pioter1234567/airhockey/firmware/lcd-unit/data/test.jpg

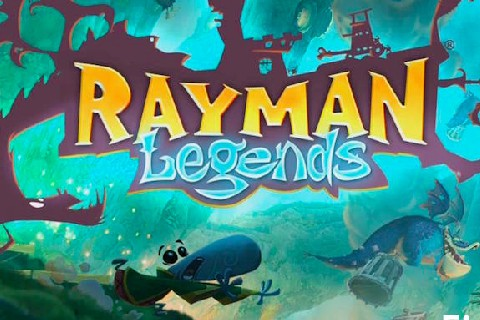
firmware/lcd-unit/data/test.jpg
