pioter1234567/airhockey/assets/Photos-3-001/IMG_20250711_163729.jpg

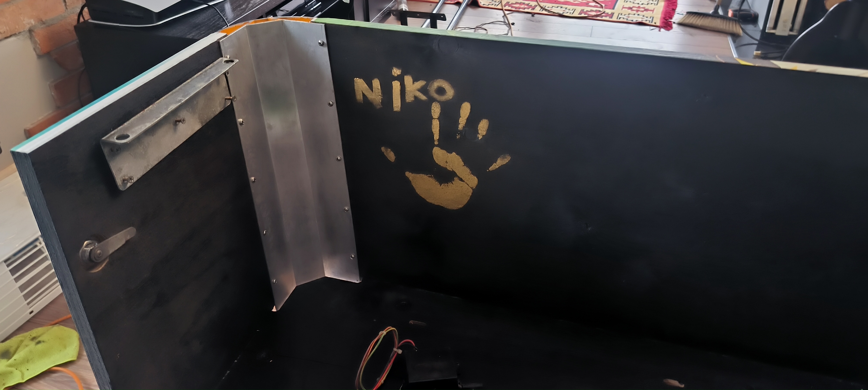
assets/Photos-3-001/IMG_20250711_163729.jpg
