pioter1234567/airhockey/assets/Photos-3-001/IMG20251211001312.jpg

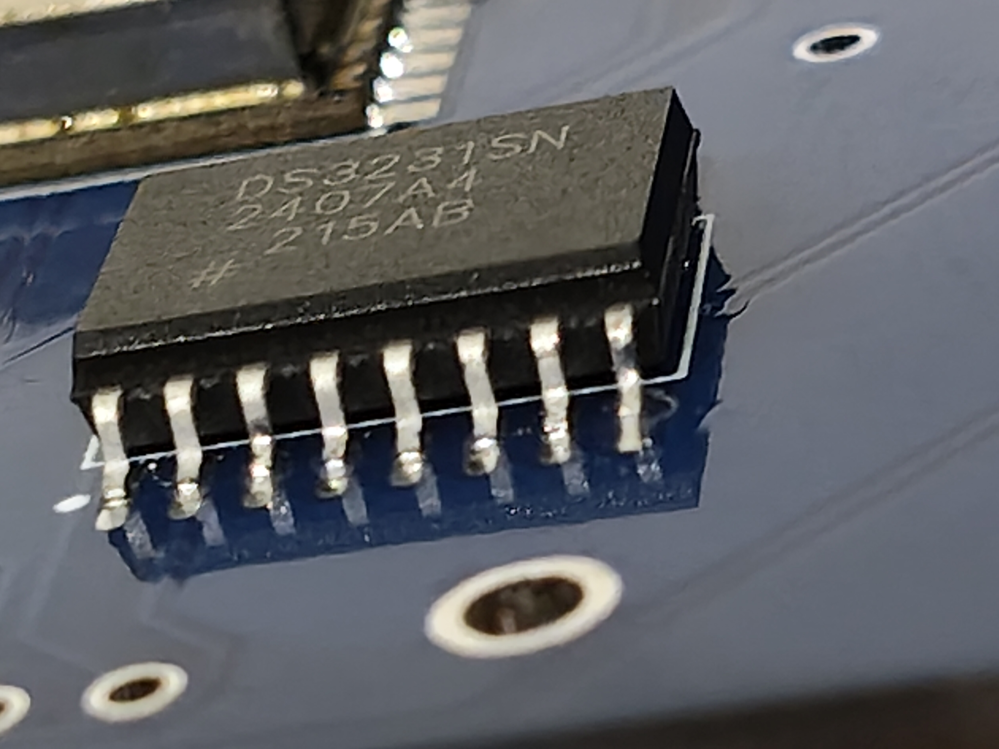
assets/Photos-3-001/IMG20251211001312.jpg
