pioter1234567/airhockey/assets/Photos-3-001/IMG20251225112504.jpg

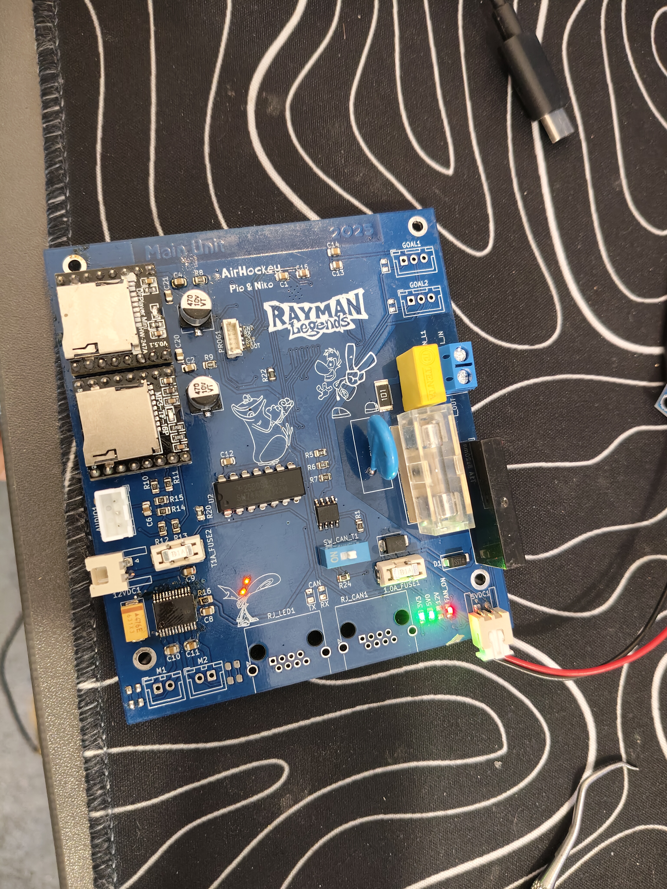
assets/Photos-3-001/IMG20251225112504.jpg
