pioter1234567/airhockey/assets/Photos-3-001/IMG20260116083901.jpg

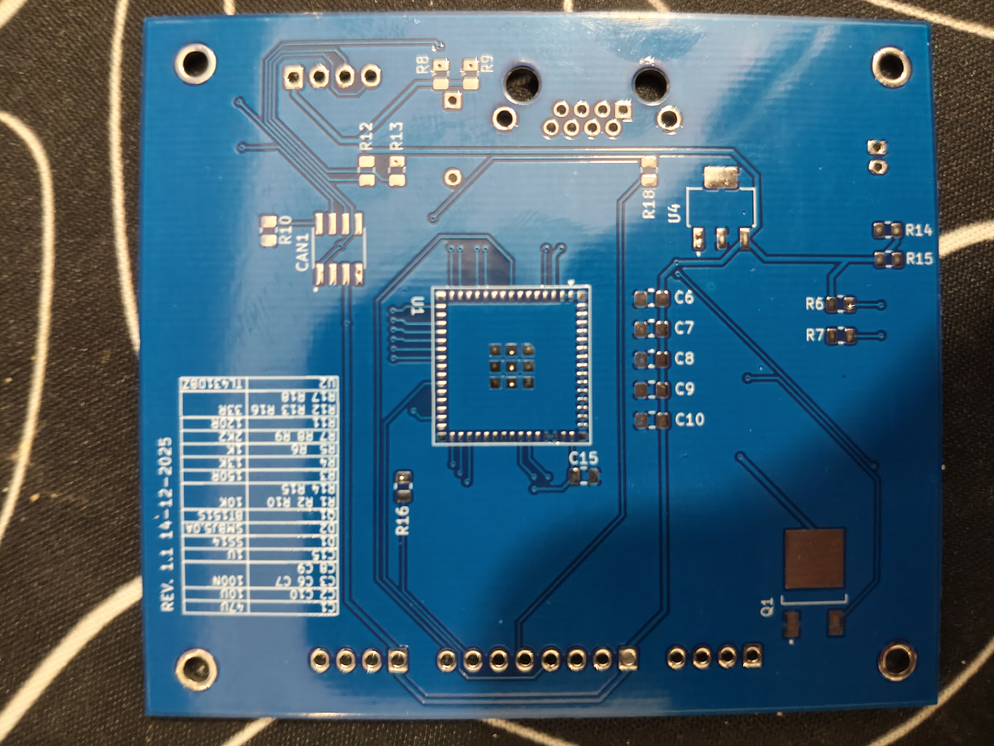
assets/Photos-3-001/IMG20260116083901.jpg
