pioter1234567/airhockey/assets/Photos-3-001/IMG20260215171539.jpg

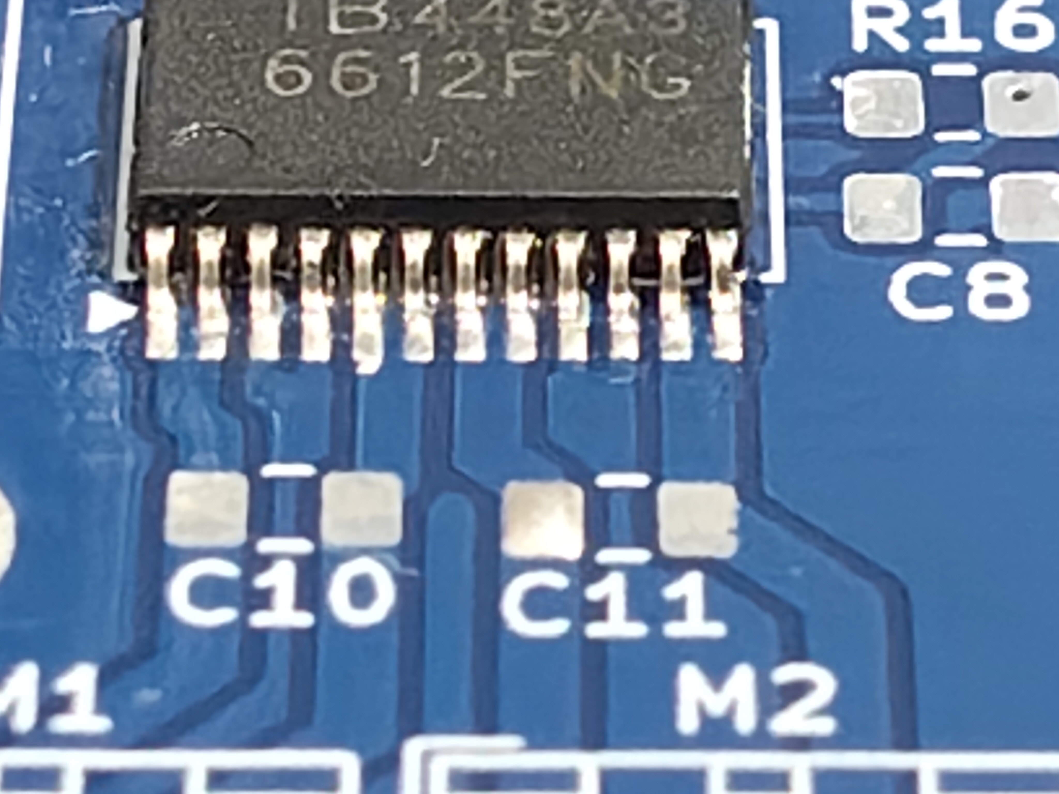
assets/Photos-3-001/IMG20260215171539.jpg
