pioter1234567/airhockey/assets/Photos-3-001/IMG20260219232452.jpg

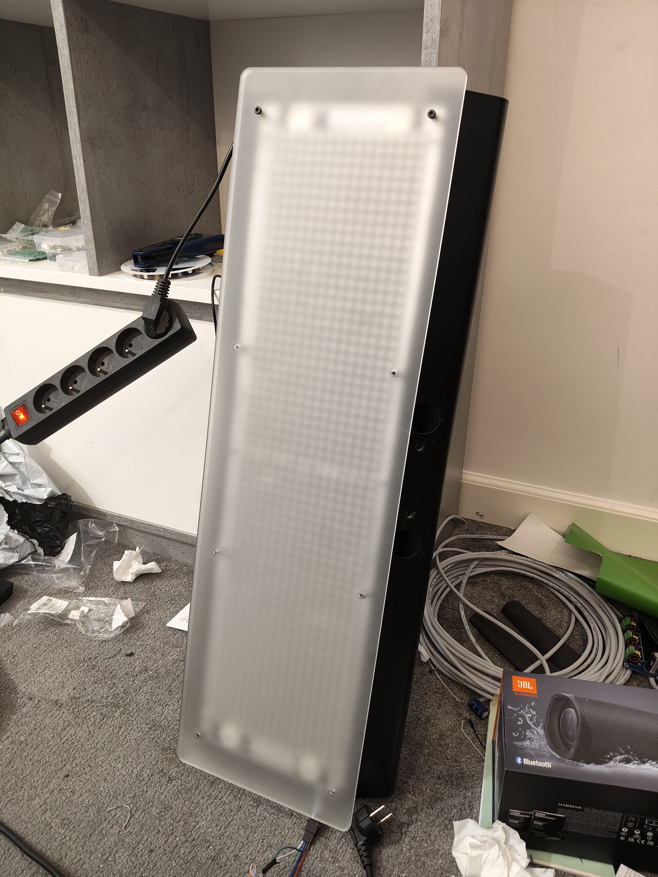
assets/Photos-3-001/IMG20260219232452.jpg
