pioter1234567/airhockey/assets/Photos-3-001/IMG20260315170738.jpg

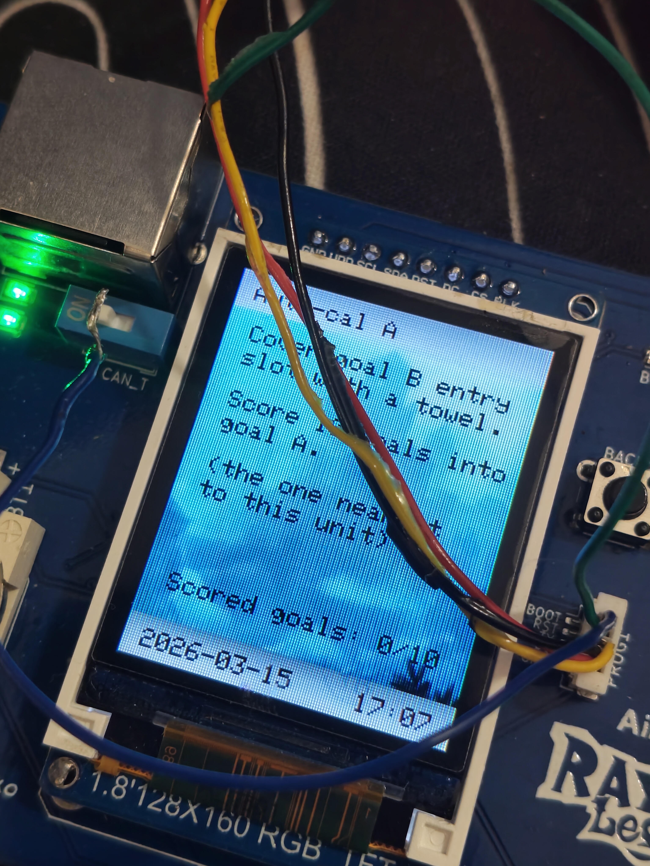
assets/Photos-3-001/IMG20260315170738.jpg
