pioter1234567/airhockey/assets/Photos-3-001/IMG20260322153125.jpg

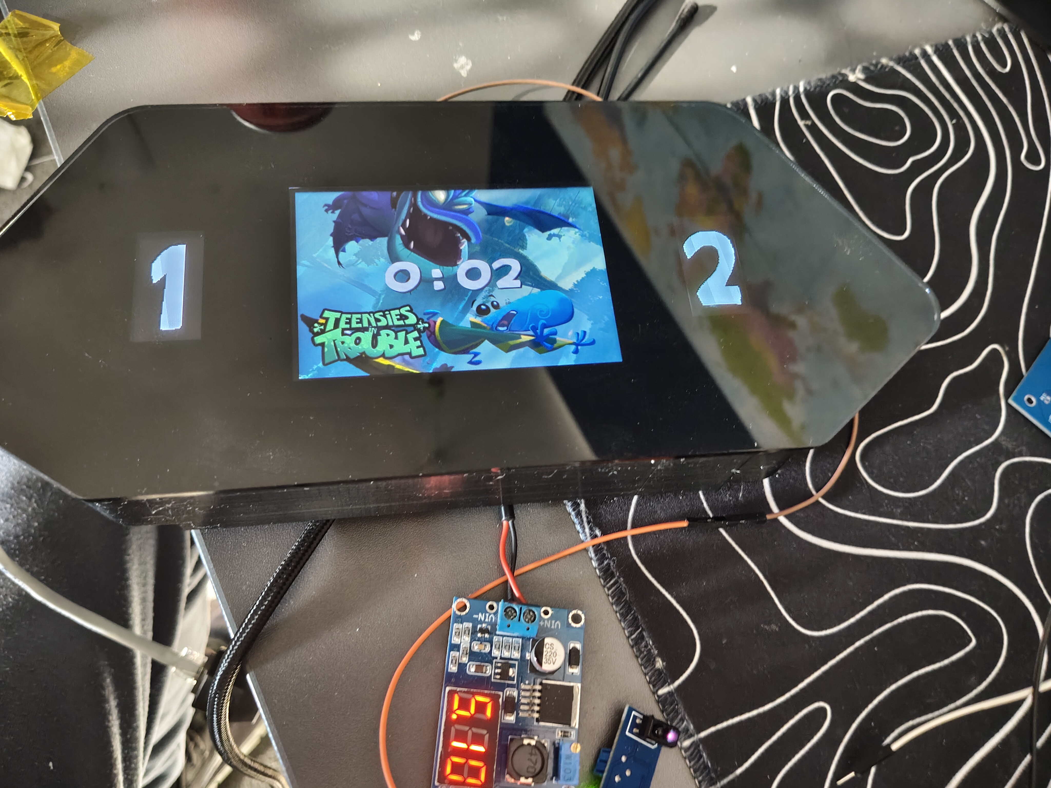
assets/Photos-3-001/IMG20260322153125.jpg
