pioter1234567/airhockey/assets/Photos-3-001/IMG_20250701_151449.jpg

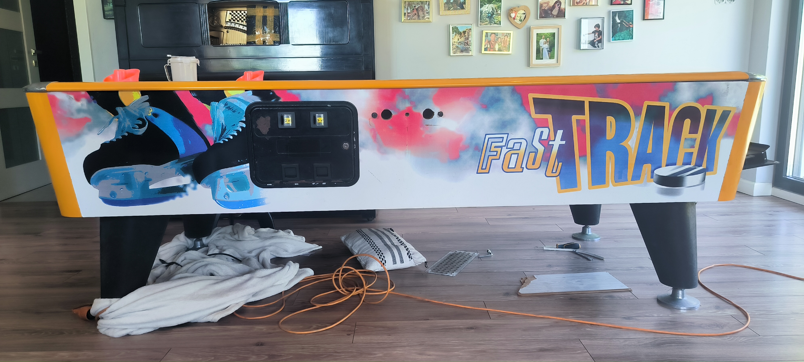
assets/Photos-3-001/IMG_20250701_151449.jpg
