pioter1234567/airhockey/assets/Photos-3-001/IMG_20250701_194646.jpg

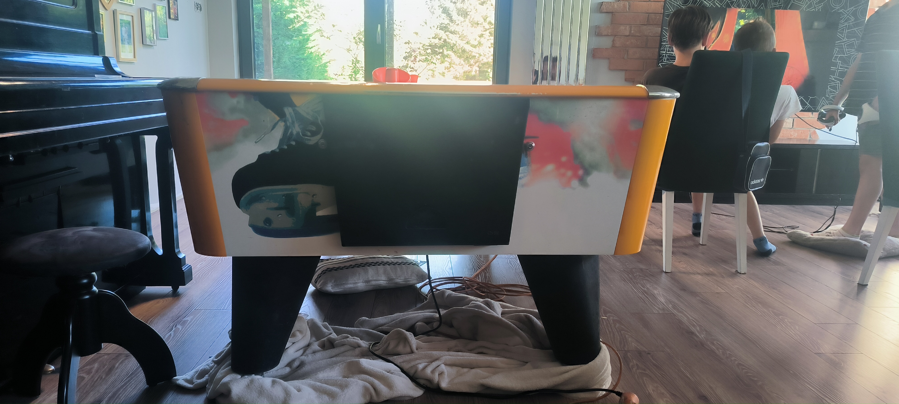
assets/Photos-3-001/IMG_20250701_194646.jpg
