pioter1234567/airhockey/assets/Photos-3-001/IMG_20250701_220945.jpg

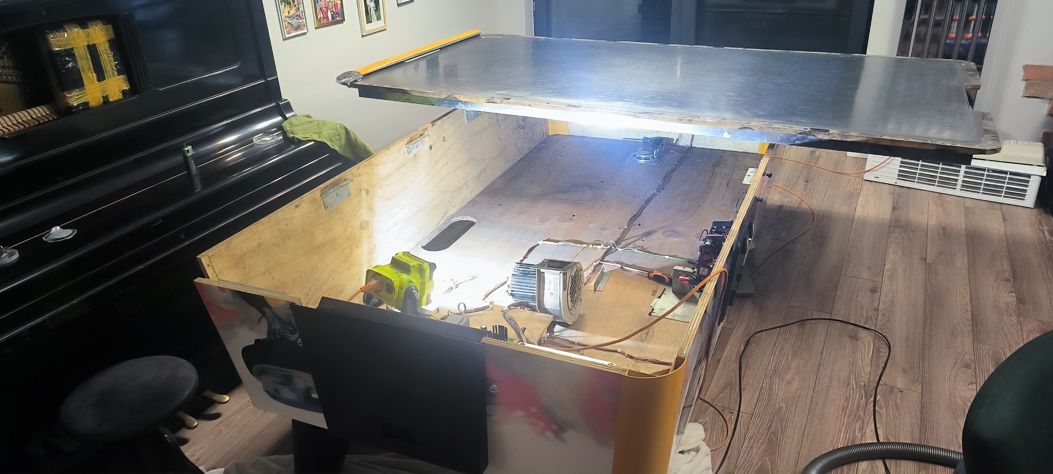
assets/Photos-3-001/IMG_20250701_220945.jpg
