pioter1234567/airhockey/assets/Photos-3-001/IMG_20250702_174221.jpg

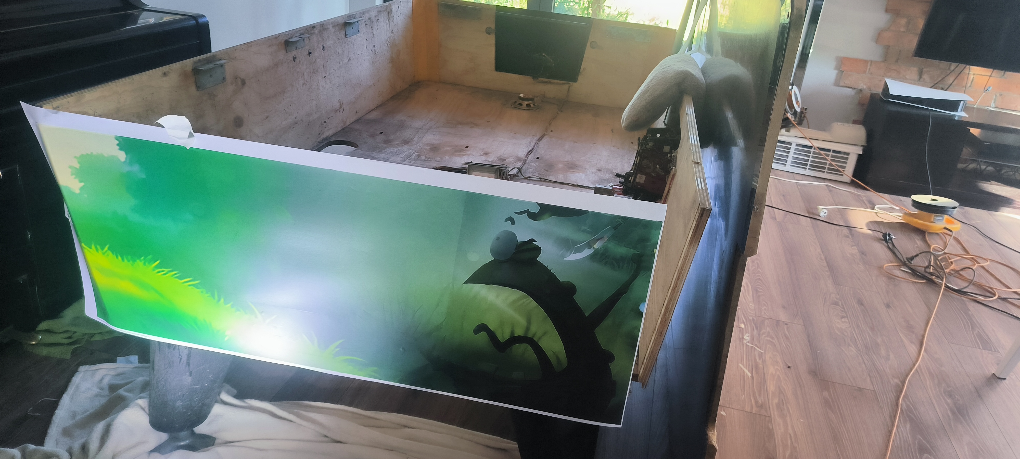
assets/Photos-3-001/IMG_20250702_174221.jpg
