pioter1234567/airhockey/assets/Photos-3-001/IMG_20250702_181902.jpg

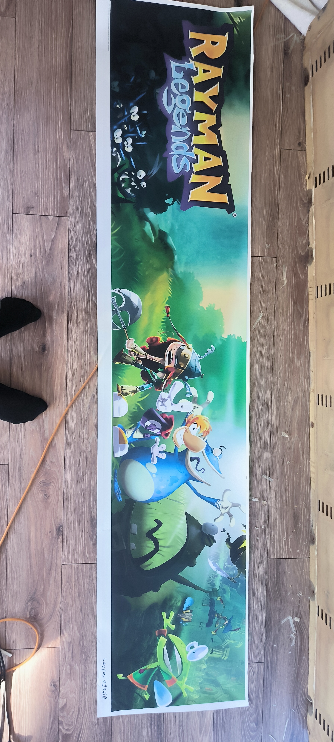
assets/Photos-3-001/IMG_20250702_181902.jpg
