pioter1234567/airhockey/assets/Photos-3-001/IMG_20250703_210801.jpg

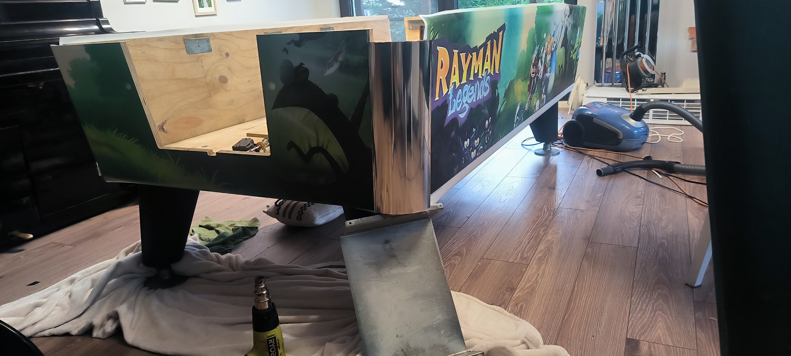
assets/Photos-3-001/IMG_20250703_210801.jpg
