pioter1234567/airhockey/assets/Photos-3-001/IMG_20250704_192019.jpg

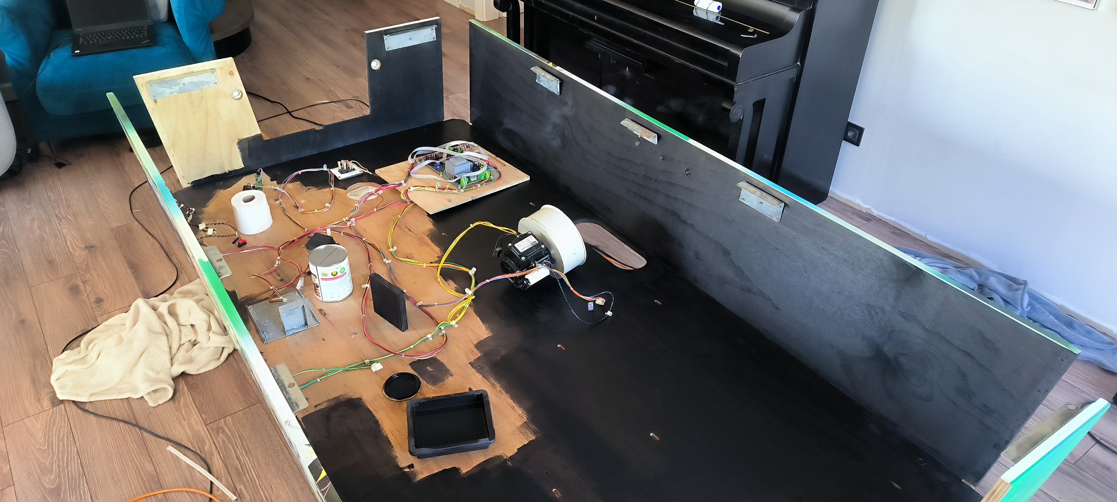
assets/Photos-3-001/IMG_20250704_192019.jpg
