pioter1234567/airhockey/assets/Photos-3-001/IMG_20250704_192031.jpg

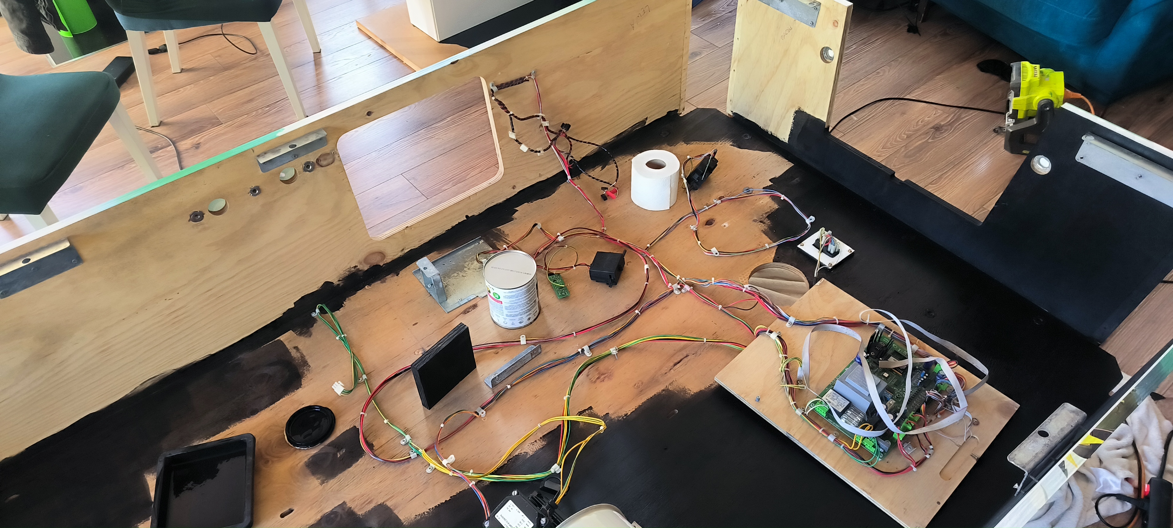
assets/Photos-3-001/IMG_20250704_192031.jpg
