pioter1234567/airhockey/assets/Photos-3-001/IMG_20250705_002451.jpg

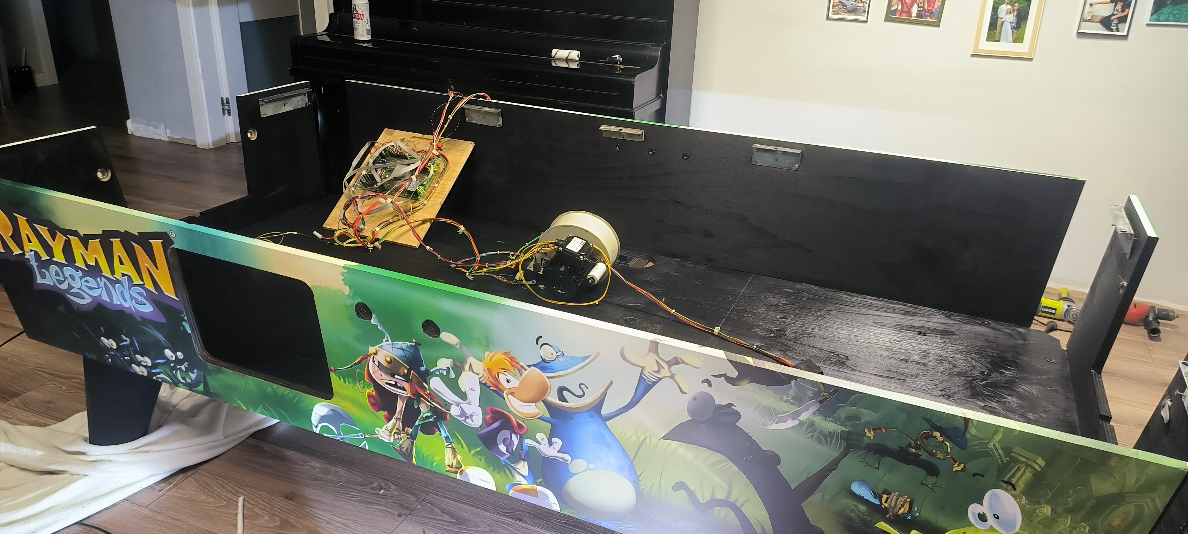
assets/Photos-3-001/IMG_20250705_002451.jpg
