pioter1234567/airhockey/assets/Photos-3-001/IMG_20250707_110234.jpg

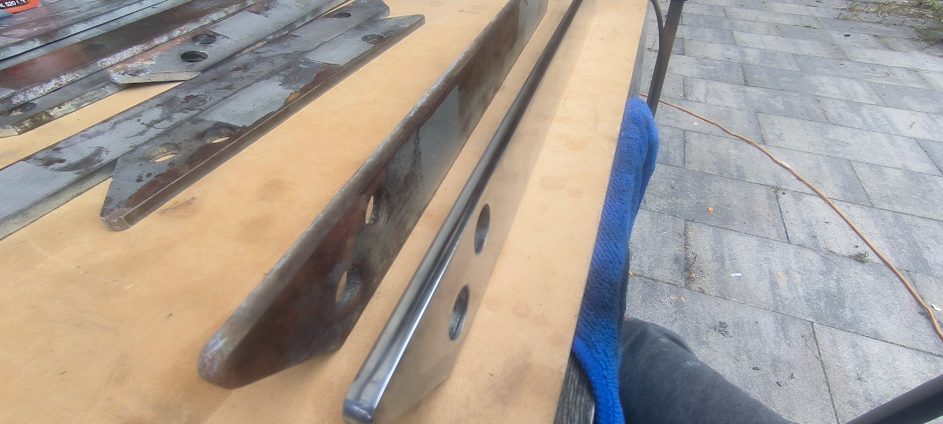
assets/Photos-3-001/IMG_20250707_110234.jpg
