pioter1234567/airhockey/assets/Photos-3-001/IMG_20250710_201015.jpg

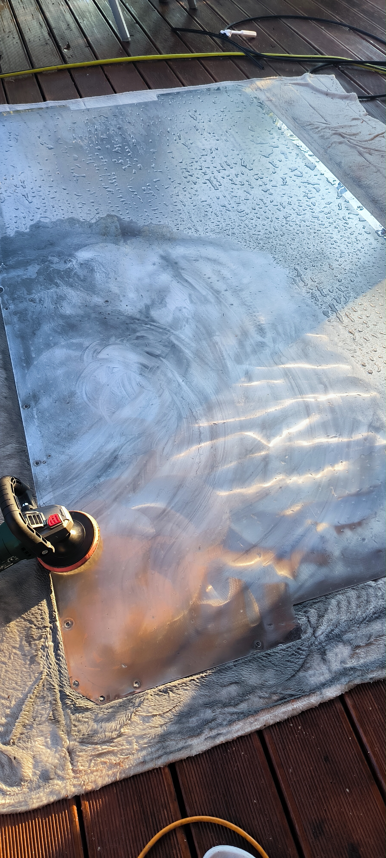
assets/Photos-3-001/IMG_20250710_201015.jpg
