pioter1234567/airhockey/assets/Photos-3-001/IMG_20250710_223631.jpg

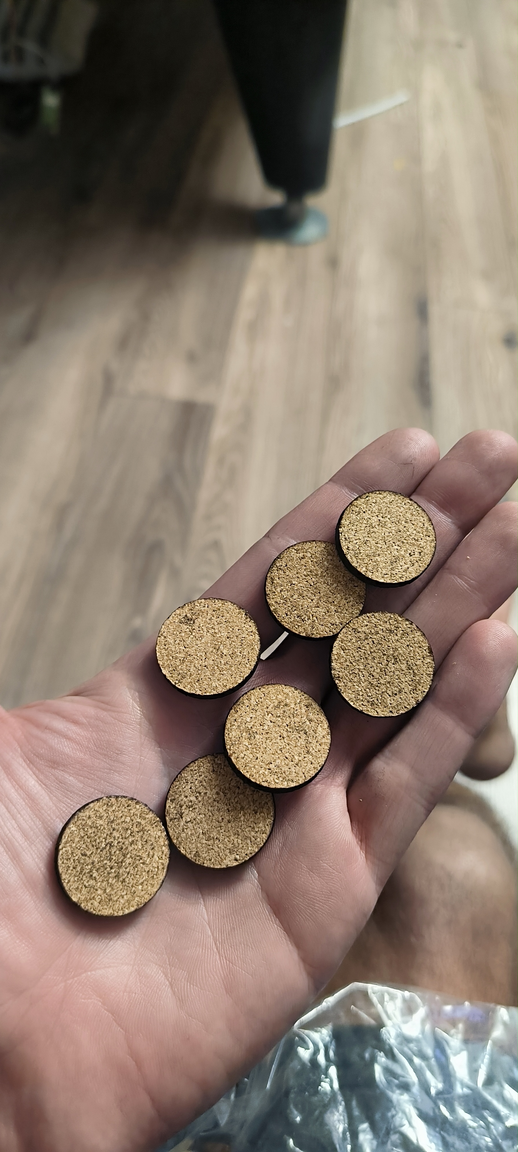
assets/Photos-3-001/IMG_20250710_223631.jpg
