pioter1234567/airhockey/assets/Photos-3-001/IMG_20250711_163737.jpg

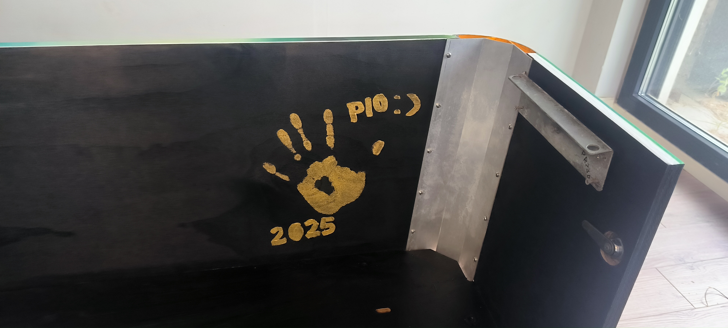
assets/Photos-3-001/IMG_20250711_163737.jpg
