pioter1234567/airhockey/assets/Photos-3-001/IMG_20250711_205644.jpg

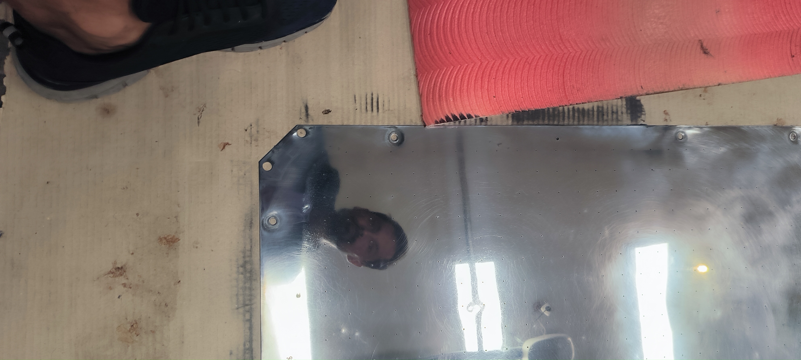
assets/Photos-3-001/IMG_20250711_205644.jpg
