pioter1234567/airhockey/assets/Photos-3-001/IMG_20250713_214349.jpg

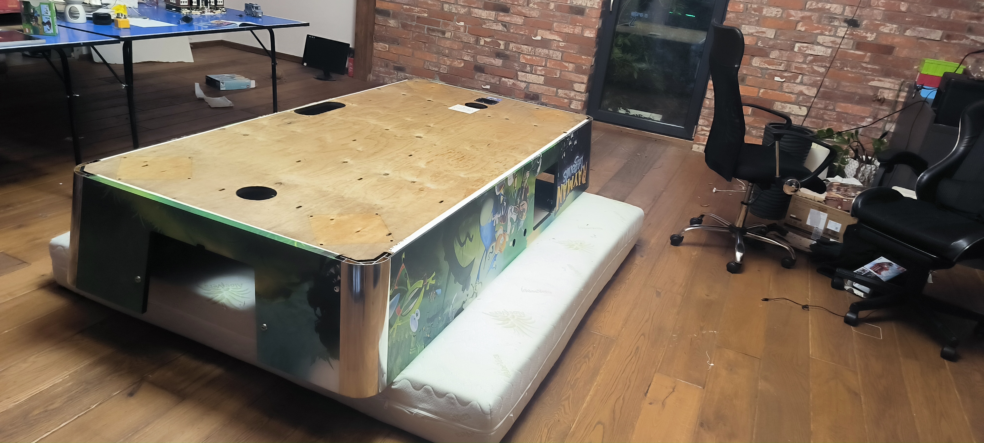
assets/Photos-3-001/IMG_20250713_214349.jpg
