pioter1234567/airhockey/assets/Photos-3-001/IMG_20250714_130432.jpg

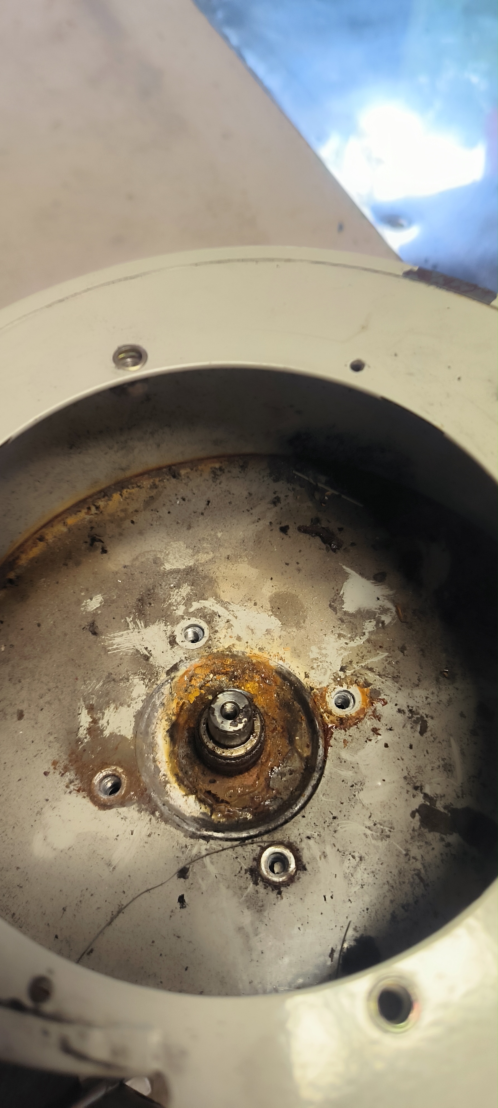
assets/Photos-3-001/IMG_20250714_130432.jpg
