pioter1234567/airhockey/assets/Photos-3-001/IMG_20250715_013938.jpg

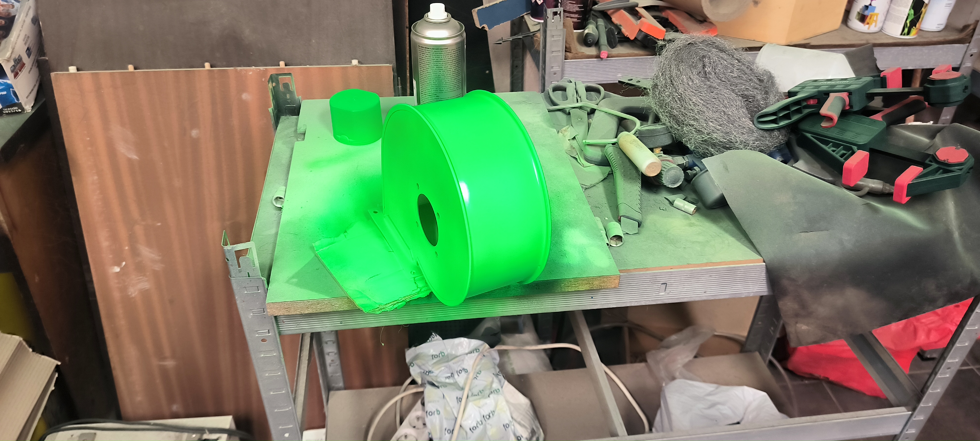
assets/Photos-3-001/IMG_20250715_013938.jpg
