pioter1234567/airhockey/assets/Photos-3-001/IMG_20250715_210039.jpg

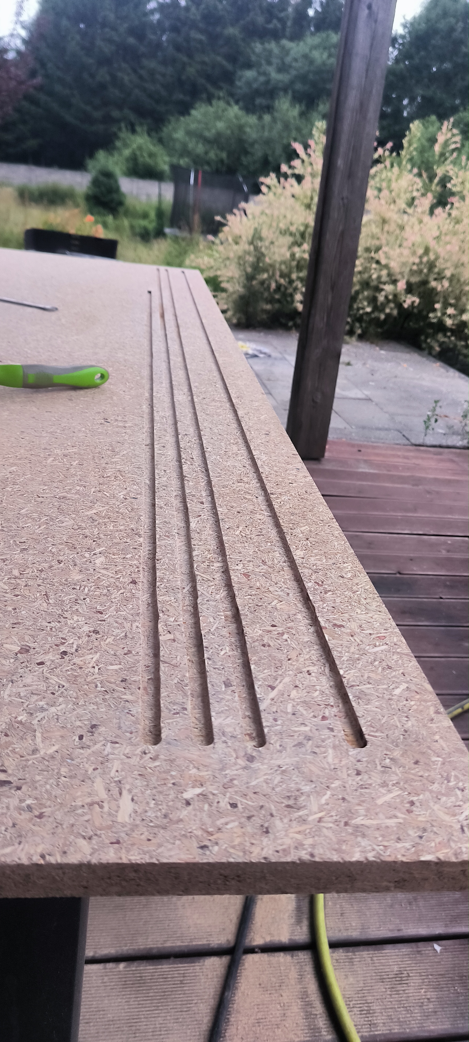
assets/Photos-3-001/IMG_20250715_210039.jpg
