pioter1234567/airhockey/assets/Photos-3-001/IMG_20250801_133204.jpg

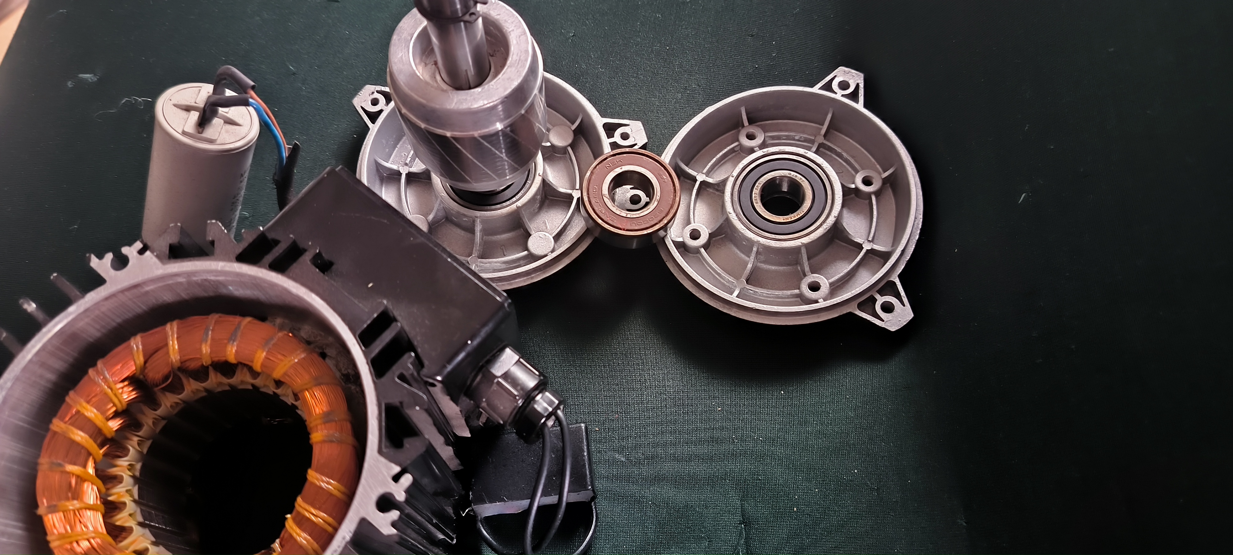
assets/Photos-3-001/IMG_20250801_133204.jpg
