pioter1234567/airhockey/assets/Photos-3-001/IMG_20250807_211830.jpg

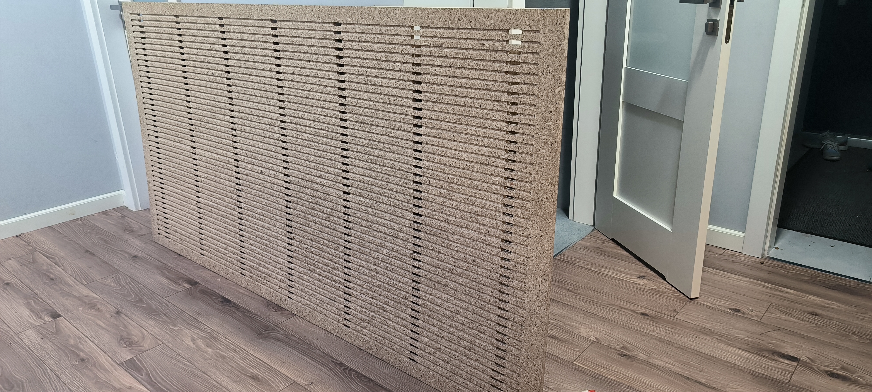
assets/Photos-3-001/IMG_20250807_211830.jpg
