pioter1234567/airhockey/assets/Photos-3-001/IMG_20250807_212000.jpg

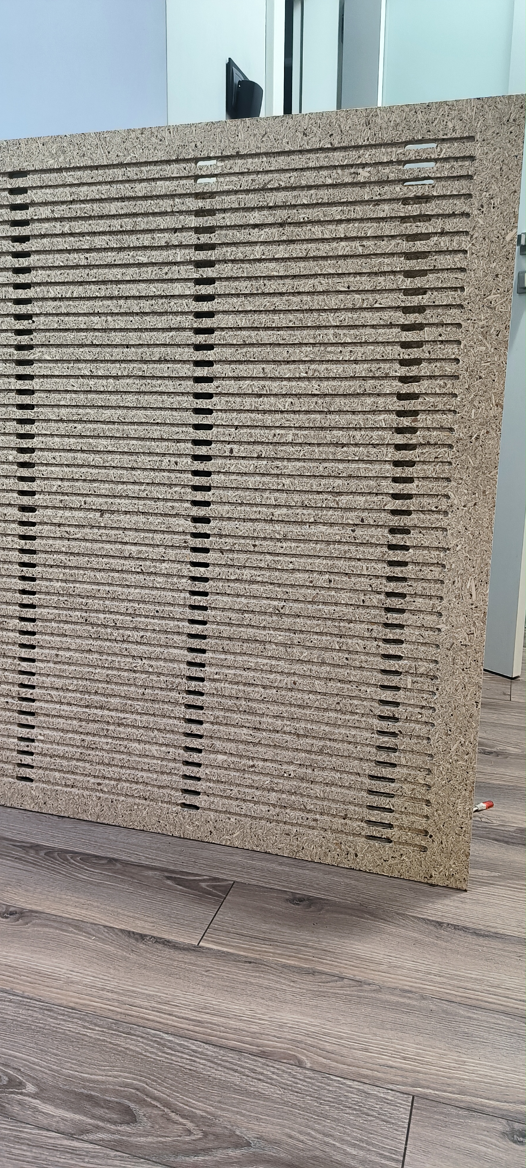
assets/Photos-3-001/IMG_20250807_212000.jpg
