pioter1234567/airhockey/assets/Photos-3-001/IMG_20250908_225837.jpg

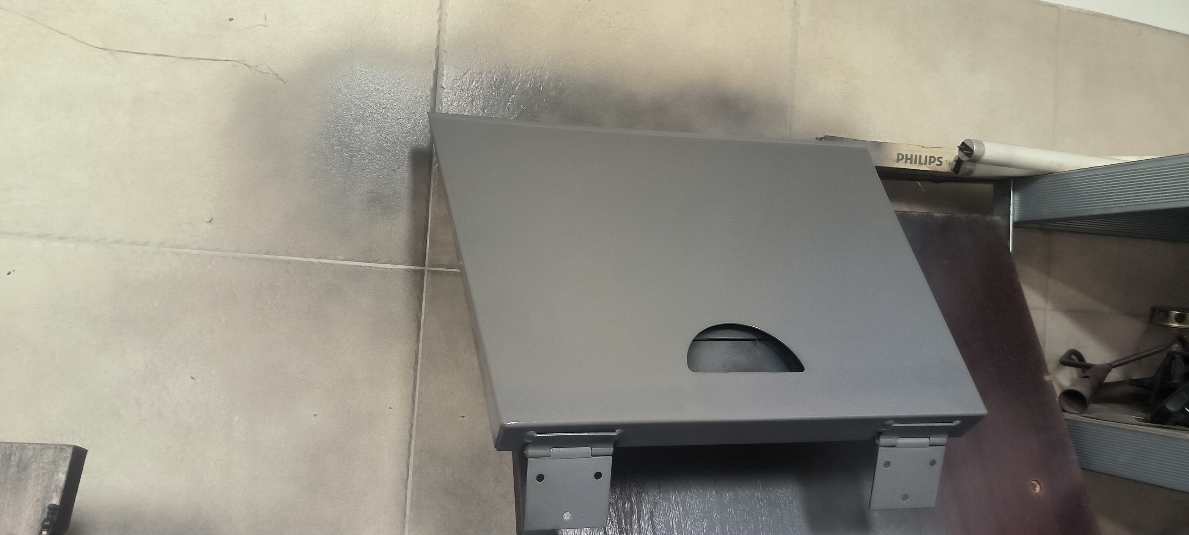
assets/Photos-3-001/IMG_20250908_225837.jpg
