pioter1234567/airhockey/electronics/main-unit_nowy/rayman_main.step

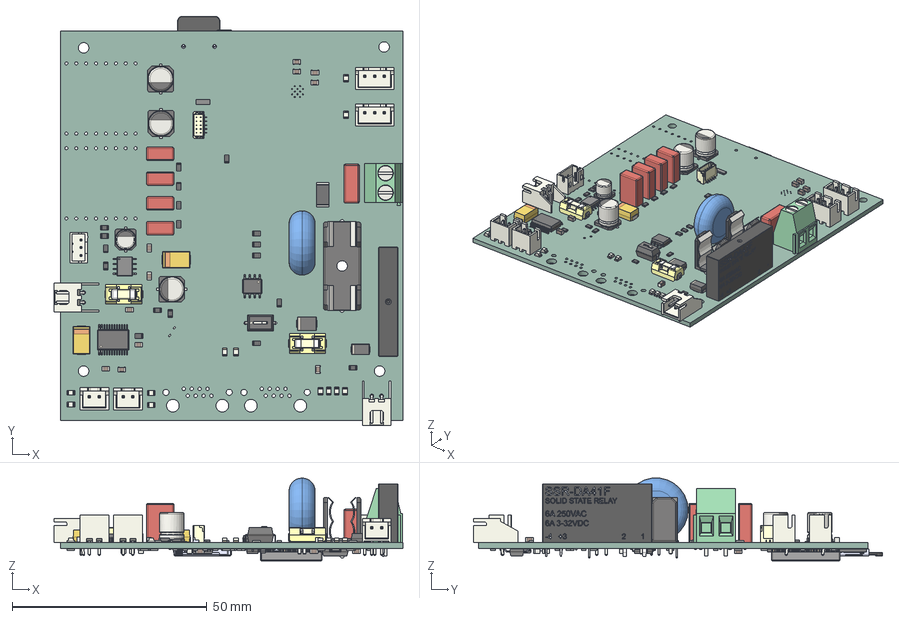
[picture p40: CAD file, 2026-06-09]
electronics/main-unit_nowy/rayman_main.step
89.6 x 105.1 x 21.2 mm
JST_XH_B2B-XH-A_1x02_P2.50mm_Vertical x 2
SOIC-8_3.9x4.9mm_P1.27mm
C_Rect_L10.0mm_W4.0mm_P7.50mm_FKS3_FKP3
SW_DIP_SPSTx01_Slide_6.7x4.1mm_W7.62mm_P2.54mm_LowProfile
R_0805_2012Metric x 47
0154001.DR x 2
C_Rect_L7.0mm_W3.5mm_P5.00mm x 4
LED_0805_2012Metric x 12
CP_EIA-7343-31_Kemet-D x 2
D_SMB
C_0805_2012Metric x 22
BM05B-SRSS-TB-LF--SN---3DModel-STEP-56544
RV_Disc_D16.5mm_W6.7mm_P7.5mm
CP_Elec_6.3x7.7 x 3
R_2512_6332Metric
TerminalBlock_Phoenix_MKDS-1,5-2_1x02_P5.00mm_Horizontal
JST_XH_S2B-XH-A-1_1x02_P2.50mm_Horizontal x 2
SSOP-24_5.3x8.2mm_P0.65mm
SP3012-06UTG
CP_Elec_5x5.3
JST_XH_B3B-XH-A_1x03_P2.50mm_Vertical x 2
D_SMA
LED_0201_0603Metric x 2
Fuseholder_Cylinder-5x20mm_Schurter_0031_8201_Horizontal_Open
JST_PH_B3B-PH-K_1x03_P2.00mm_Vertical
Body001 (Mirror #1) x 4
XY-plane x 12
X-axis x 12
noga4
noga3
noga2
noga1
SOT-23
SN74AHCT125PW
PESD1CAN
MCP1826S-5002E_DB
ESP32-S3-WROOM-1
ACM2012-T002 DRRAubN(typ size)
ACM2012-T002 dɃubN(typ size) x 4
MSD-4-A
Micro SD Card
rayman_main_PCB
