pioter1234567/airhockey/assets/3d-models-etc/main unit tray.FCStd

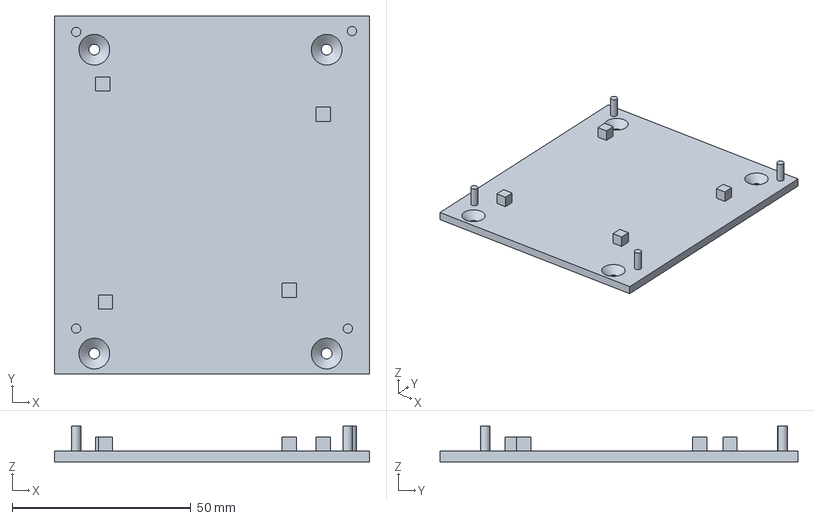
[picture p41: CAD file, 2026-06-09]
assets/3d-models-etc/main unit tray.FCStd
88.1 x 100.0 x 10.0 mm
