pioter1234567/airhockey/assets/3d-models-etc/door_strip_latch.stl

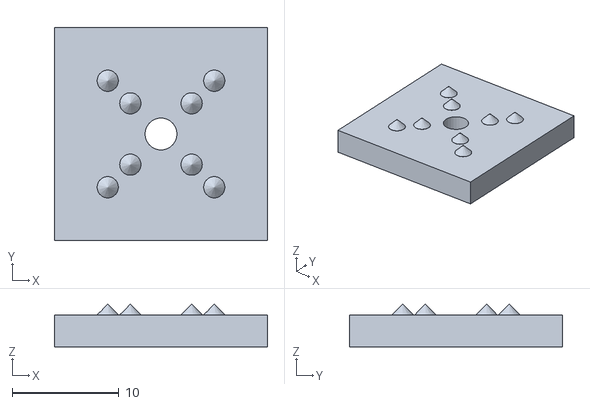
[picture p42: CAD file, 2026-06-22]
assets/3d-models-etc/door_strip_latch.stl
20.0 x 20.0 x 4.00
