pioter1234567/airhockey/electronics/lamp-driver/lamp-driver/lamp-driver.step

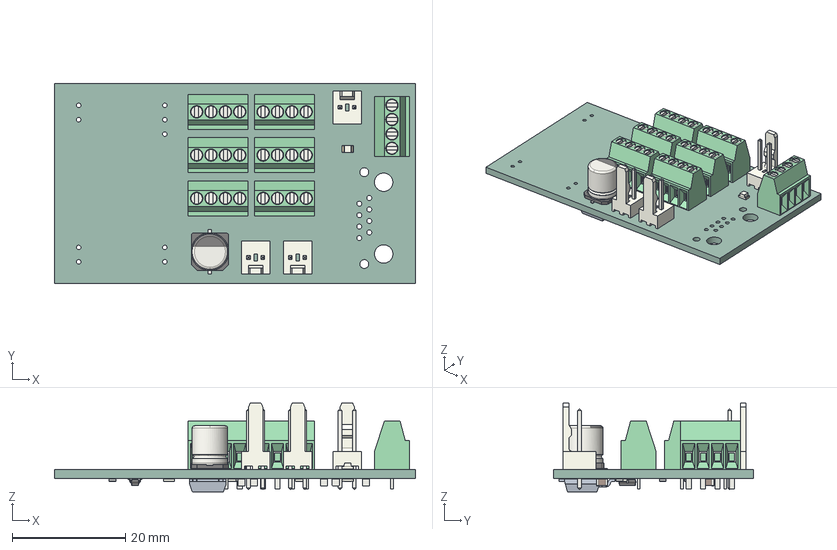
[picture p43: CAD file, 2026-04-10]
electronics/lamp-driver/lamp-driver/lamp-driver.step
63.9 x 35.4 x 15.7 mm
CP_Elec_6.3x7.7
TerminalBlock_Phoenix_MPT-0,5-4-2.54_1x04_P2.54mm_Horizontal x 7
LED_0805_2012Metric
Molex_KK-254_AE-6410-02A_1x02_P2.54mm_Vertical x 3
R_0805_2012Metric x 9
C_0805_2012Metric x 5
SOT-23
lamp-driver 1.21.1
lamp-driver_PCB
