pioter1234567/airhockey/electronics/lcd-unit-STM32/rayman_LCD_STM.step

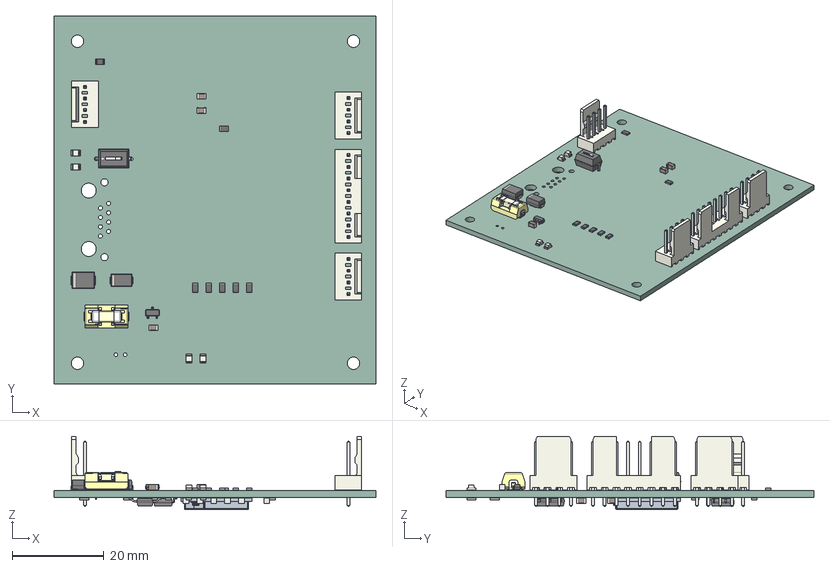
[picture p44: CAD file, 2026-04-10]
electronics/lcd-unit-STM32/rayman_LCD_STM.step
70.0 x 80.0 x 16.0 mm
R_0805_2012Metric x 18
D_SMB
Molex_KK-254_AE-6410-04A_1x04_P2.54mm_Vertical x 3
C_0805_2012Metric x 9
SOT-23
LED_0805_2012Metric x 4
0154001.DR
SW_DIP_SPSTx01_Slide_6.7x4.1mm_W7.62mm_P2.54mm_LowProfile
D_SMA
Molex_KK-254_AE-6410-08A_1x08_P2.54mm_Vertical
MCP1826S-5002E_DB
rayman_LCD 1.31.1
rayman_LCD 1.31.2
Body001 (Mirror #1) x 4
XY-plane x 12
X-axis x 12
rayman_LCD_PCB
