pioter1234567/airhockey/electronics/settings-unit/nowe_ust.step

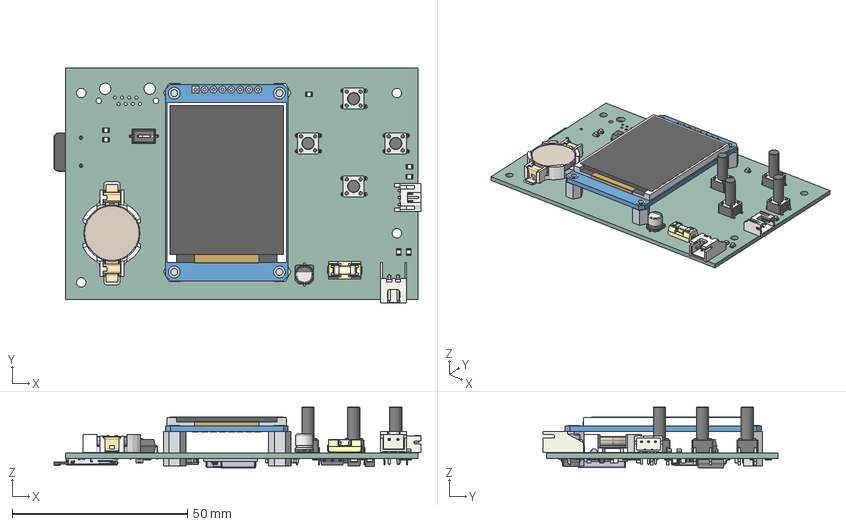
[picture p45: CAD file, 2026-06-09]
electronics/settings-unit/nowe_ust.step
104.6 x 67.0 x 17.3 mm
SW_DIP_SPSTx01_Slide_6.7x4.1mm_W7.62mm_P2.54mm_LowProfile
JST_PH_S3B-PH-K_1x03_P2.00mm_Horizontal
SW_PUSH_6mm_H13mm x 4
LED_0805_2012Metric x 7
BU-1632SM PAD^BU-1632SM-JJ-GTR_00
BU-1632SM^BU-1632SM-JJ-G_BU-1632SM-JJ-GTR_00
Contact (+)^BU-1632SM-JJ-G_BU-1632SM-JJ-GTR_00
Contact (-)^BU-1632SM-JJ-G_BU-1632SM-JJ-GTR_00
CR1632^BU-1632SM-JJ-GTR
0154001.DR
CP_Elec_5x5.3
JST_XH_S2B-XH-A-1_1x02_P2.50mm_Horizontal
1.8_inches_128x160_RGB_TFT_LCD
srubki
C_0805_2012Metric x 13
R_0805_2012Metric x 31
nowe_ust 1.25.1
nowe_ust 1.25.2
D_SMB
MSD-4-A
Micro SD Card
MCP1826S-5002E_DB
D_SMA
DS3231S
Body001 (Mirror #1) x 4
XY-plane x 12
X-axis x 12
SOT-23
nowe_ust_PCB
