pioter1234567/airhockey/assets/3d-models-etc/door_stripe_latch2.FCStd

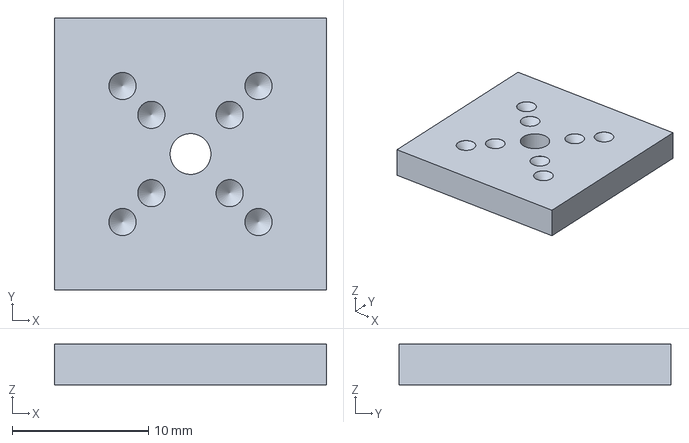
[picture p46: CAD file, 2026-06-22]
assets/3d-models-etc/door_stripe_latch2.FCStd
20.0 x 20.0 x 3.00 mm
