pioter1234567/airhockey/electronics/settings-unit/ob_gora.step

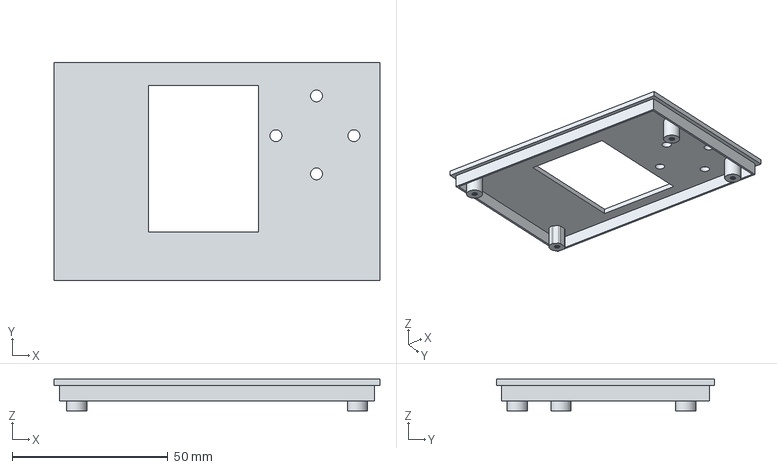
[picture p47: CAD file, 2026-03-13]
electronics/settings-unit/ob_gora.step
104.5 x 70.0 x 10.2 mm
