pioter1234567/airhockey/assets/3d-models-etc/kulka.stl

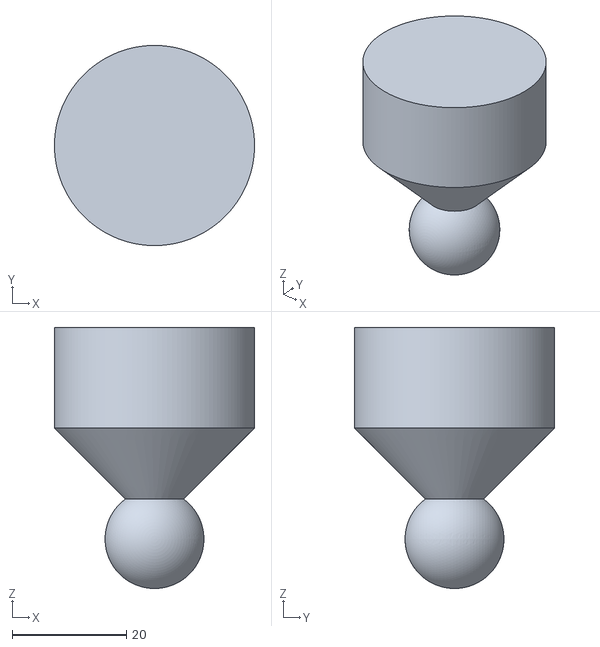
[picture p48: CAD file, 2026-06-22]
assets/3d-models-etc/kulka.stl
35.0 x 35.0 x 45.6
