pioter1234567/airhockey/assets/3d-models-etc/BT_tray.stl

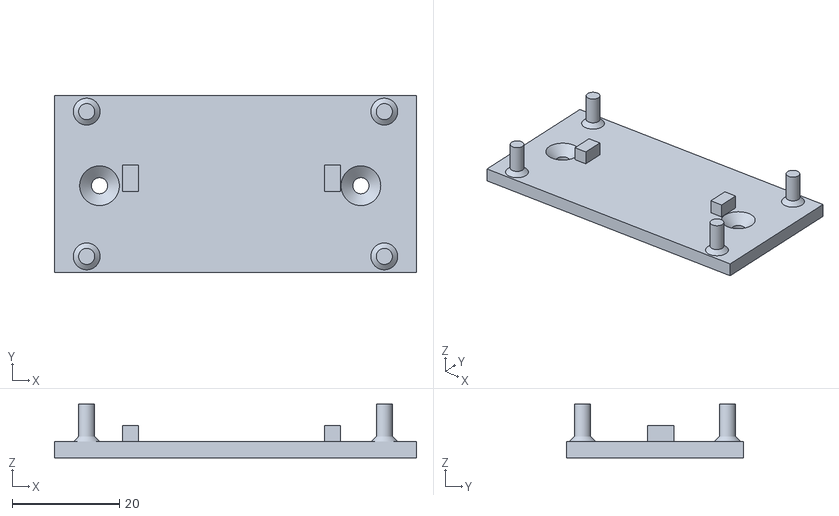
[picture p49: CAD file, 2026-06-09]
assets/3d-models-etc/BT_tray.stl
67.5 x 33.0 x 10.0
