pioter1234567/airhockey/assets/3d-models-etc/5v_tray.stl

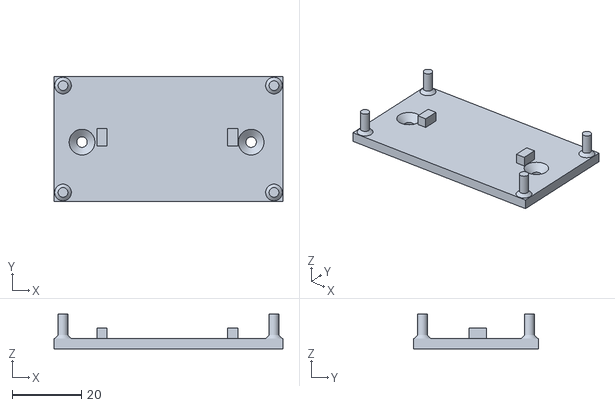
[picture p50: CAD file, 2026-06-09]
assets/3d-models-etc/5v_tray.stl
66.0 x 36.0 x 10.0
