pioter1234567/airhockey/assets/3d-models-etc/settings tray.FCStd

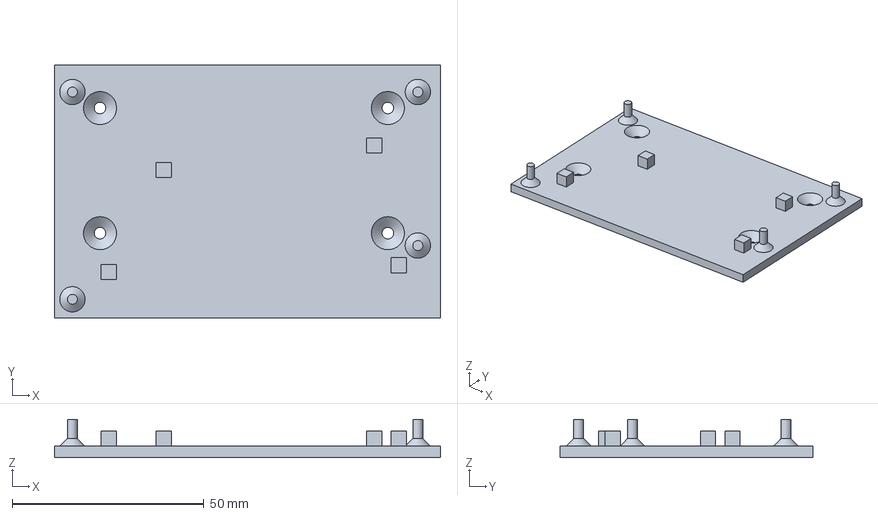
[picture p51: CAD file, 2026-06-09]
assets/3d-models-etc/settings tray.FCStd
100.6 x 66.0 x 10.0 mm
