pioter1234567/airhockey/assets/3d-models-etc/speaker_tweeters.FCStd

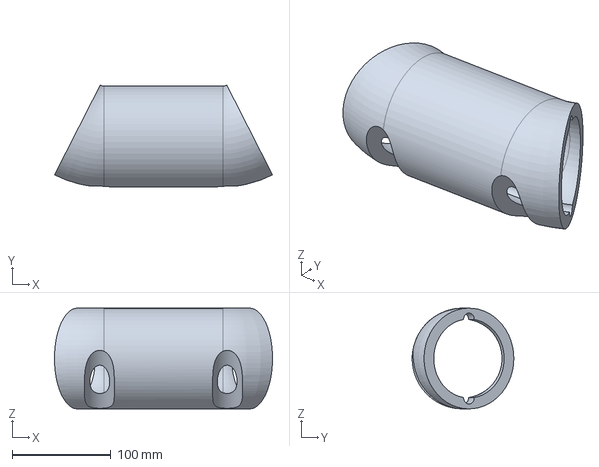
[picture p52: CAD file, 2026-06-02]
assets/3d-models-etc/speaker_tweeters.FCStd
220.7 x 103.0 x 102.0 mm
