pioter1234567/airhockey/assets/3d-models-etc/speaker_tweeters2.FCStd

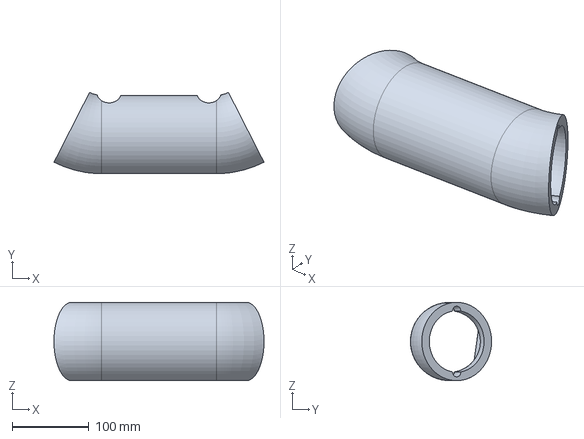
[picture p53: CAD file, 2026-06-02]
assets/3d-models-etc/speaker_tweeters2.FCStd
273.4 x 105.7 x 102.0 mm
