pioter1234567/airhockey/assets/3d-models-etc/lamp-driver-housing.FCStd

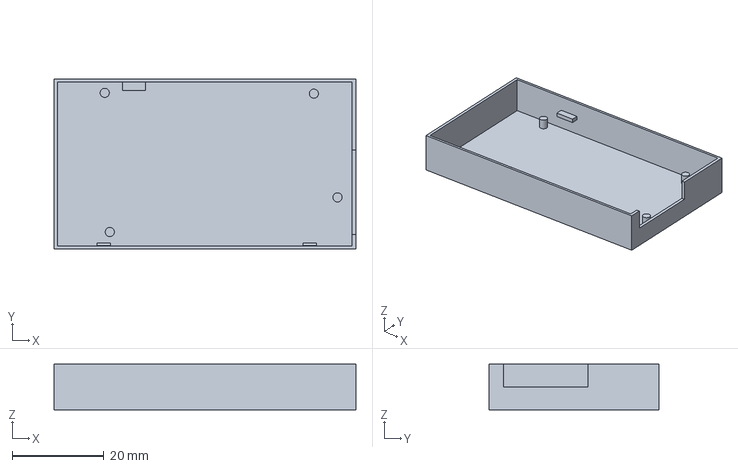
[picture p54: CAD file, 2026-04-10]
assets/3d-models-etc/lamp-driver-housing.FCStd
65.8 x 36.9 x 10.0 mm
