pioter1234567/airhockey/assets/3d-models-etc/speaker_box.FCStd

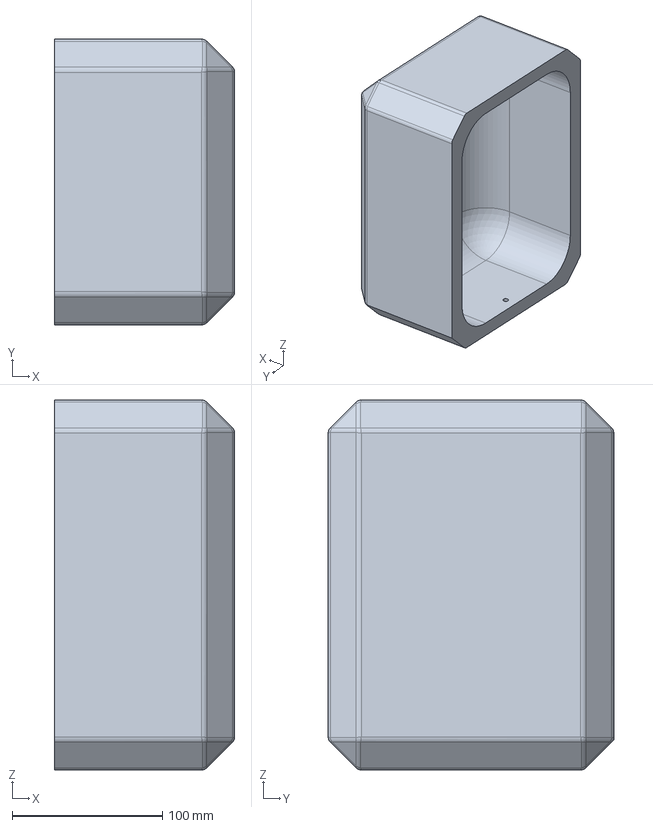
[picture p55: CAD file, 2026-03-21]
assets/3d-models-etc/speaker_box.FCStd
120.0 x 190.0 x 246.0 mm
