pioter1234567/airhockey/assets/3d-models-etc/lcd-housing.FCStd

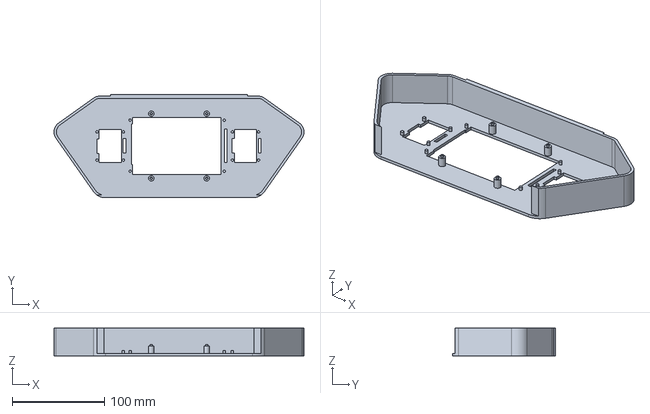
[picture p56: CAD file, 2026-03-21]
assets/3d-models-etc/lcd-housing.FCStd
270.7 x 112.0 x 30.0 mm
