pioter1234567/airhockey/(list of files, cad)

Other CAD files:
assets/3d-models-etc/door_stripe_latch.FCStd
assets/3d-models-etc/door_strip_latch2.stl
assets/3d-models-etc/treble-box.stl
assets/3d-models-etc/lcd-cover-screen-lasercut.FCStd
assets/3d-models-etc/lamp-driver-housing.stl
assets/3d-models-etc/lcd-housing.stl
assets/3d-models-etc/main unit tray.stl
assets/3d-models-etc/settings tray.stl
