pioter1234567/airhockey/(list of files, drawings)

Other design files:
electronics/settings-unit/nowe_ust.dsn
