pioter1234567/airhockey/electronics/main-unit/rayman_main.kicad_pcb

## KiCad design electronics/main-unit/rayman_main.kicad_pcb (2026-06-02)

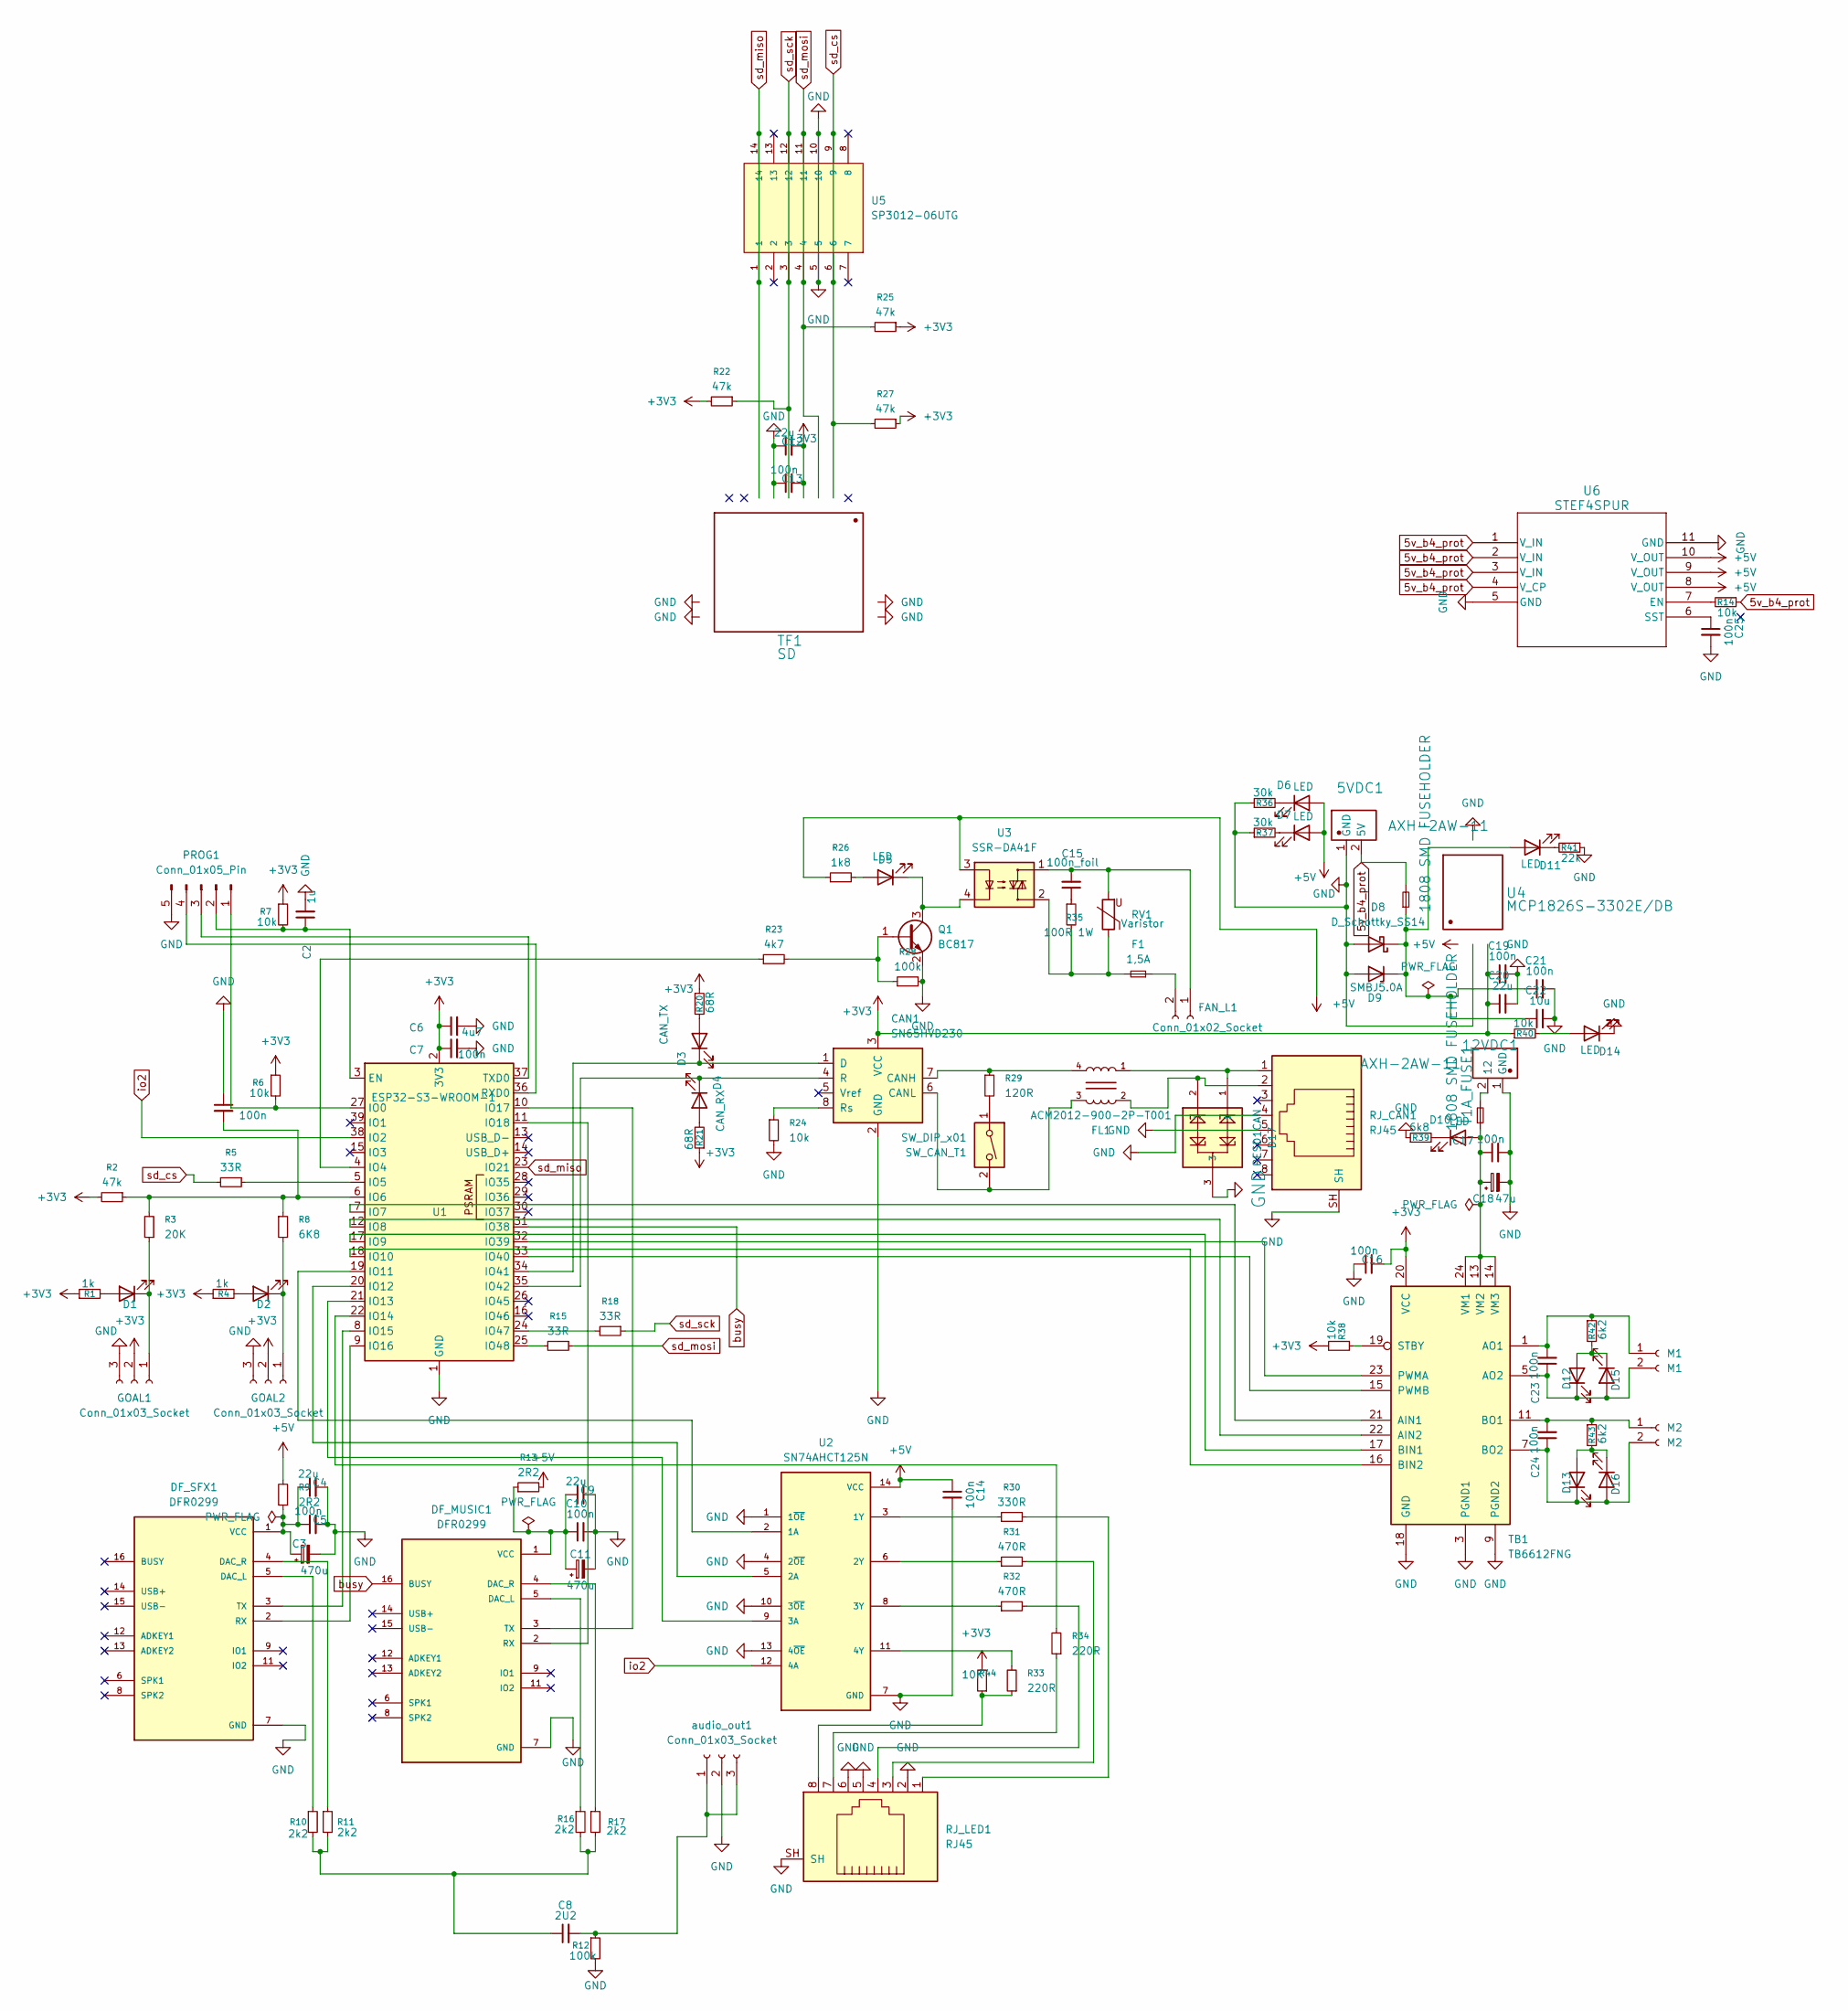
[picture p57: schematic rayman_main.kicad_sch]

Parts:
1,0A_FUSE1: 1808 SMD FUSEHOLDER; FUSE_1808; Manufacturer Part 1808 SMD Fuseholder
5VDC1, 12VDC1: AXH-2AW-11; JST_XH_S2B-XH-A-1_1x02_P2.50mm_Horizontal; Manufacturer Part AXH-2AW-11
C1, C5, C7, C10, C13, C14, C16, C17, C19, C21, C23, C24, C25: 100n; C_0805_2012Metric
C2: 1u; C_0805_2012Metric
C3, C11: 470u; CP_Elec_6.3x7.7
C4, C9, C12, C20: 22u; C_0805_2012Metric
C6: 4u7; C_0805_2012Metric
C8: 2U2; C_0805_2012Metric
C15: 100n_foil; C_Rect_L10.0mm_W4.0mm_P7.50mm_FKS3_FKP3
C18: 47u; CP_EIA-7343-31_Kemet-D
C22: 10u; C_0805_2012Metric
CAN1: SN65HVD230; SOIC-8_3.9x4.9mm_P1.27mm
D1, D2, D5, D10, D11, D12, D13, D14, D15, D16: LED; LED_0805_2012Metric
D3: CAN_TX; LED_0805_2012Metric
D4: CAN_RX; LED_0805_2012Metric
D6, D7: LED; LED_0201_0603Metric
D8: D_Schottky_SS14; D_SMA
D9: SMBJ5.0A; D_SMB
D17: PESD1CAN; SOT23-3
DF_MUSIC1: DFR0299; MODULE_DFR0299
DF_SFX1: DFR0299; MODULE_DFR0299
F1: 1,5A; Fuseholder_Cylinder-5x20mm_Schurter_0031_8201_Horizontal_Op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
FAN_L1: Conn_01x02_Socket; TerminalBlock_Phoenix_MKDS-1,5-2_1x02_P5.00mm_Horizontal
FL1: ACM2012-900-2P-T001; FIL_ACM2012-900-2P-T001
GOAL1, GOAL2: Conn_01x03_Socket; JST_XH_B3B-XH-A_1x03_P2.50mm_Vertical
M1: M1; JST_XH_B2B-XH-A_1x02_P2.50mm_Vertical
M2: M2; JST_XH_B2B-XH-A_1x02_P2.50mm_Vertical
PROG1: Conn_01x05_Pin; JST_SH_BM05B-SRSS-TB_1x05-1MP_P1.00mm_Vertical
Q1: BC817; SOT-23
R1, R4: 1k; R_0805_2012Metric
R2, R22, R25, R27: 47k; R_0805_2012Metric
R3: 20K; R_0805_2012Metric
R5, R15, R18: 33R; R_0805_2012Metric
R6, R7, R14, R24, R38, R40: 10k; R_0805_2012Metric
R8: 6K8; R_0805_2012Metric
R9, R13: 2R2; R_0805_2012Metric
R10, R11, R16, R17: 2k2; R_0805_2012Metric
R12, R28: 100k; R_0805_2012Metric
R20, R21: 68R; R_0805_2012Metric
R23: 4k7; R_0805_2012Metric
R26: 1k8; R_0805_2012Metric
R29: 120R; R_0805_2012Metric
R30: 330R; R_0805_2012Metric
R31, R32: 470R; R_0805_2012Metric
R33, R34: 220R; R_0805_2012Metric
R35: 100R 1W; R_2512_6332Metric
R36, R37: 30k; R_0805_2012Metric
R39: 6k8; R_0805_2012Metric
R41: 22k; R_0805_2012Metric
R42, R43: 6k2; R_0805_2012Metric
R44: 10K; R_0805_2012Metric
RJ_CAN1: RJ45; RJ45_Amphenol_RJHSE5380
RJ_LED1: RJ45; RJ45_Amphenol_RJHSE5380
RV1: Varistor; RV_Disc_D16.5mm_W6.7mm_P7.5mm
SW_CAN_T1: SW_DIP_x01; SW_DIP_SPSTx01_Slide_6.7x4.1mm_W7.62mm_P2.54mm_LowProfile
T1A_FUSE1: 1808 SMD FUSEHOLDER; FUSE_1808; Manufacturer Part 1808 SMD Fuseholder
TB1: TB6612FNG; SSOP-24_5.3x8.2mm_P0.65mm
TF1: SD; CUI_MSD-4-A; Manufacturer Part SD
U1: ESP32-S3-WROOM-1
U2: SN74AHCT125N; DIP794W45P254L1930H508Q14; PARTREV Q
U3: SSR-DA41F; Relay_SPST-NO_Fujitsu_FTR-LYAA005x_FormA_Vertical
U4: MCP1826S-3302E/DB; MCP1826S-5002EDB; Manufacturer Part MCP1826S-3302E/DB
U5: SP3012-06UTG; SON50P350X135X55-14N; PARTREV 02/23/17
U6: STEF4SPUR; STEF05PUR
audio_out1: Conn_01x03_Socket; JST_PH_B3B-PH-SM4-TB_1x03-1MP_P2.00mm_Vertical

Connections:
5v_b4_prot: 1,0A_FUSE1.2, 5VDC1.2 (5V), R14.1, U6.1 (V_IN), U6.2 (V_IN), U6.3 (V_IN), U6.4 (V_CP)
+3V3: C6.1, C7.1, C12.2, C13.2, C16.2, C19.1, C20.1, CAN1.3 (VCC), GOAL1.2 (VCC), GOAL2.2 (VCC), R1.1, R2.2, R4.1, R6.1, R7.1, R20.1, R21.1, R22.2, R25.1, R27.1, R38.2, R40.1, R44.2, TB1.20 (VCC), TF1.4 (VDD), U1.2 (3V3), U4.3 (VOUT)
+5V: C14.1, D6.2 (A), D7.2 (A), R9.2, R13.2, R26.1, U2.14 (VCC), U3.3, U4.1 (VIN), U6.8 (V_OUT), U6.9 (V_OUT), U6.10 (V_OUT)
GND: 5VDC1.1 (GND), 12VDC1.1 (GND), C1.1, C2.2, C3.2, C4.2, C5.2, C6.2, C7.2, C9.2, C10.2, C11.2, C12.1, C13.1, C14.2, C16.1, C17.2, C18.2, C19.2, C20.2, C21.2, C22.2, C25.2, CAN1.2 (GND), D8.2 (A), D9.2 (A), D14.1 (K), D17.3, DF_MUSIC1.7 (GND), DF_MUSIC1.10 (GND), DF_SFX1.7 (GND), DF_SFX1.10 (GND), GOAL1.3 (GND), GOAL2.3 (GND), PROG1.5, Q1.2 (E), R12.2, R24.2, R28.2, R36.1, R37.1, R39.1, R41.1, RJ_CAN1.4, RJ_CAN1.5, RJ_CAN1.SH, RJ_LED1.2, RJ_LED1.5, RJ_LED1.6, RJ_LED1.SH, TB1.3 (PGND1), TB1.4 (PGND1), TB1.9 (PGND2), TB1.10 (PGND2), TB1.18 (GND), TF1.6 (VSS), TF1.G1, TF1.G2, TF1.G3, TF1.G4, U1.1 (GND), U1.40 (GND), U1.41 (GND), U2.1 (1~OE), U2.4 (2~OE), U2.7 (GND), U2.10 (3~OE), U2.13 (4~OE), U4.2 (GND), U4.4 (GND), U5.5, U5.10, U6.5 (GND), U6.11 (GND), audio_out1.2 (VCC)
unnamed: 12VDC1.2 (12), T1A_FUSE1.2
unnamed: C8.1, R10.2, R11.2, R16.2, R17.2
unnamed: C15.1, R35.1
unnamed: CAN1.7 (CANH), FL1.4, R29.1
unnamed: CAN1.6 (CANL), FL1.3, SW_CAN_T1.2
unnamed: CAN1.1 (D), D3.1 (K), U1.34 (IO41)
unnamed: CAN1.4 (R), D4.1 (K), U1.35 (IO42)
unnamed: CAN1.8 (Rs), R24.1
unnamed: D1.2 (A), R1.2
unnamed: D1.1 (K), GOAL1.1 (DO), R3.1
unnamed: D2.2 (A), R4.2
unnamed: D2.1 (K), GOAL2.1 (DO), R8.2
unnamed: D3.2 (A), R20.2
unnamed: D4.2 (A), R21.2
unnamed: D5.2 (A), R26.2
unnamed: D5.1 (K), Q1.3 (C), U3.4
unnamed: D6.1 (K), R36.2
unnamed: D7.1 (K), R37.2
unnamed: C17.1, C18.1, D10.2 (A), T1A_FUSE1.1, TB1.13 (VM2), TB1.14 (VM3), TB1.24 (VM1)
unnamed: D10.1 (K), R39.2
unnamed: 1,0A_FUSE1.1, C21.1, C22.1, D8.1 (K), D9.1 (K), D11.2 (A)
unnamed: D11.1 (K), R41.2
unnamed: D12.2 (A), D15.1 (K), R42.2
unnamed: C23.1, D12.1 (K), D15.2 (A), M1.2, TB1.5 (AO2), TB1.6 (AO2)
unnamed: D13.2 (A), D16.1 (K), R43.2
unnamed: C24.1, D13.1 (K), D16.2 (A), M2.2, TB1.7 (BO2), TB1.8 (BO2)
unnamed: D14.2 (A), R40.2
unnamed: D17.1, FL1.1, RJ_CAN1.1
unnamed: D17.2, FL1.2, RJ_CAN1.2
unnamed: DF_MUSIC1.5 (DAC_L), R16.1
unnamed: DF_MUSIC1.4 (DAC_R), R17.1
unnamed: DF_MUSIC1.2 (RX), U1.11 (IO18)
unnamed: DF_MUSIC1.3 (TX), U1.10 (IO17)
unnamed: C9.1, C10.1, C11.1, DF_MUSIC1.1 (VCC), R13.1
unnamed: DF_SFX1.5 (DAC_L), R10.1
unnamed: DF_SFX1.4 (DAC_R), R11.1
unnamed: DF_SFX1.2 (RX), U1.9 (IO16)
unnamed: DF_SFX1.3 (TX), U1.8 (IO15)
unnamed: C3.1, C4.1, C5.1, DF_SFX1.1 (VCC), R9.1
unnamed: F1.2, R35.2, RV1.1, U3.2
unnamed: C15.2, FAN_L1.1, RV1.2, U3.1
unnamed: F1.1, FAN_L1.2
unnamed: C23.2, M1.1, R42.1, TB1.1 (AO1), TB1.2 (AO1)
unnamed: C24.2, M2.1, R43.1, TB1.11 (BO1), TB1.12 (BO1)
unnamed: PROG1.1, R6.2, U1.27 (IO0)
unnamed: C2.1, PROG1.2, R7.2, U1.3 (EN)
unnamed: PROG1.3, U1.37 (TXD0)
unnamed: PROG1.4, U1.36 (RXD0)
unnamed: Q1.1 (B), R23.2, R28.1
unnamed: R29.2, SW_CAN_T1.1
unnamed: R30.2, RJ_LED1.1
unnamed: R31.2, RJ_LED1.3
unnamed: R32.2, RJ_LED1.4
unnamed: R33.1, R44.1, RJ_LED1.8
unnamed: R34.1, RJ_LED1.7
unnamed: TB1.21 (AIN1), U1.7 (IO7)
unnamed: TB1.22 (AIN2), U1.12 (IO8)
unnamed: TB1.17 (BIN1), U1.17 (IO9)
unnamed: TB1.16 (BIN2), U1.18 (IO10)
unnamed: TB1.23 (PWMA), U1.32 (IO39)
unnamed: TB1.15 (PWMB), U1.33 (IO40)
unnamed: R38.1, TB1.19 (STBY)
unnamed: R23.1, U1.4 (IO4)
unnamed: R5.1, U1.5 (IO5)
unnamed: C1.2, R2.1, R3.2, R8.1, U1.6 (IO6)
unnamed: U1.19 (IO11), U2.2 (1A)
unnamed: U1.20 (IO12), U2.5 (2A)
unnamed: U1.21 (IO13), U2.9 (3A)
unnamed: R34.2, U1.22 (IO14)
unnamed: R18.2, U1.24 (IO47)
unnamed: R15.2, U1.25 (IO48)
unnamed: R30.1, U2.3 (1Y)
unnamed: R31.1, U2.6 (2Y)
unnamed: R32.1, U2.8 (3Y)
unnamed: R33.2, U2.11 (4Y)
unnamed: R14.2, U6.7 (EN)
unnamed: C25.1, U6.6 (SST)
unnamed: C8.2, R12.1, audio_out1.1 (DO), audio_out1.3 (GND)
busy: DF_MUSIC1.16 (BUSY), U1.31 (IO38)
io2: U1.38 (IO2), U2.12 (4A)
sd_cs: R5.2, R27.2, TF1.2 (CD/DAT3), U5.6, U5.9
sd_miso: TF1.7 (DAT0), U1.23 (IO21), U5.1, U5.14
sd_mosi: R15.1, R25.2, TF1.3 (CMD), U5.4, U5.11
sd_sck: R18.1, R22.1, TF1.5 (CLK), U5.3, U5.12

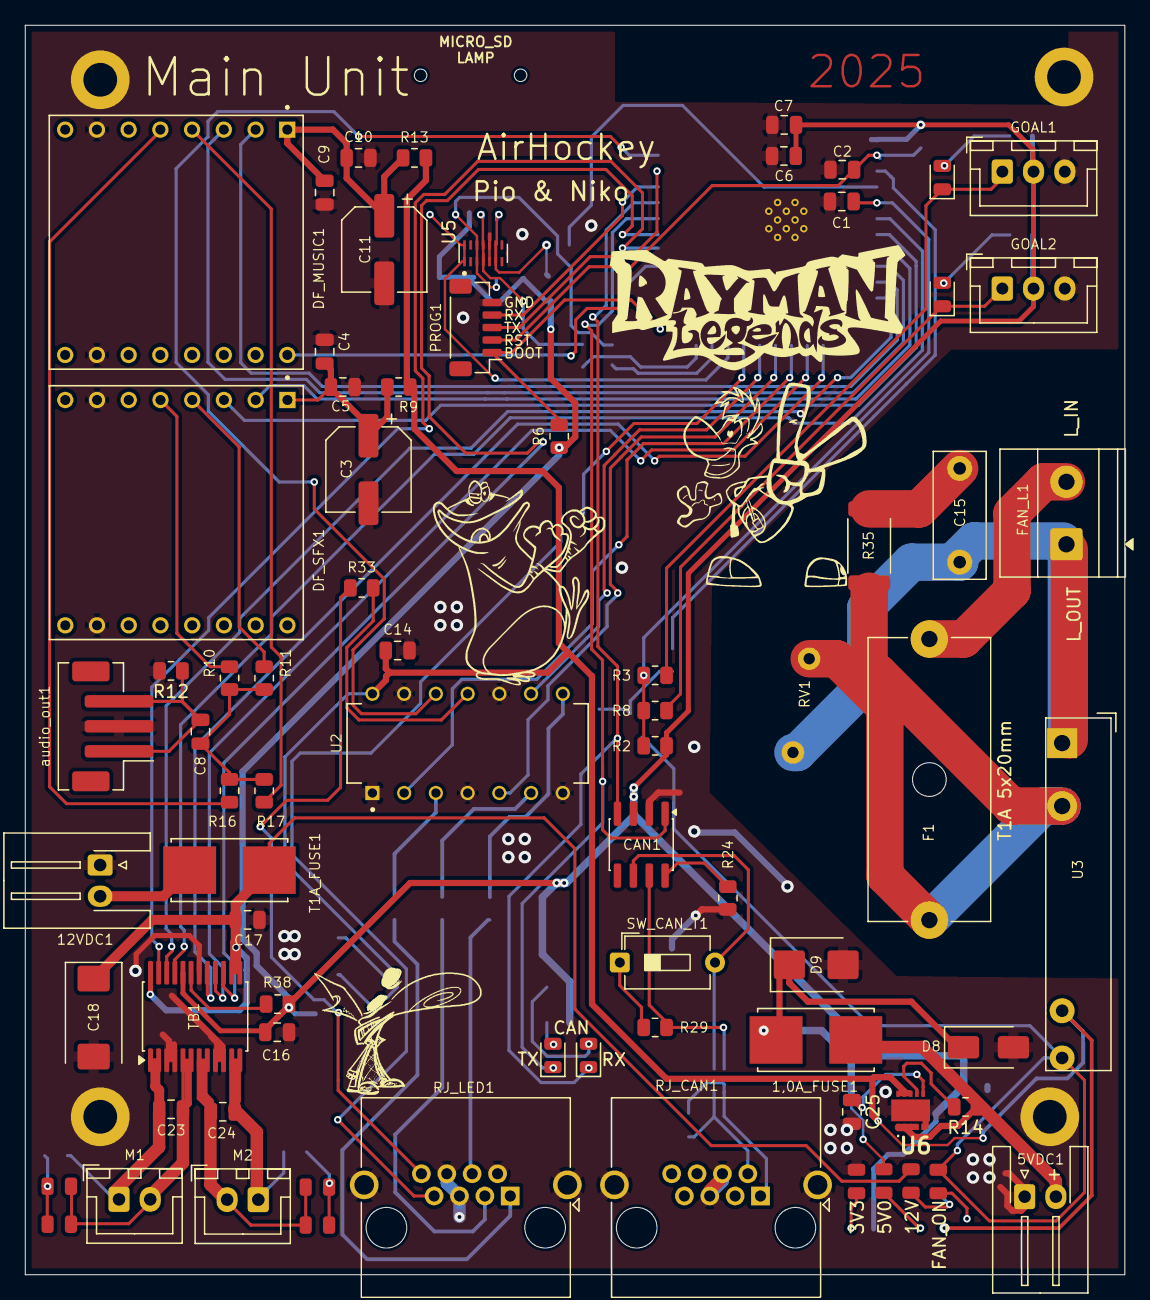
[picture p58: board rayman_main.kicad_pcb from above]

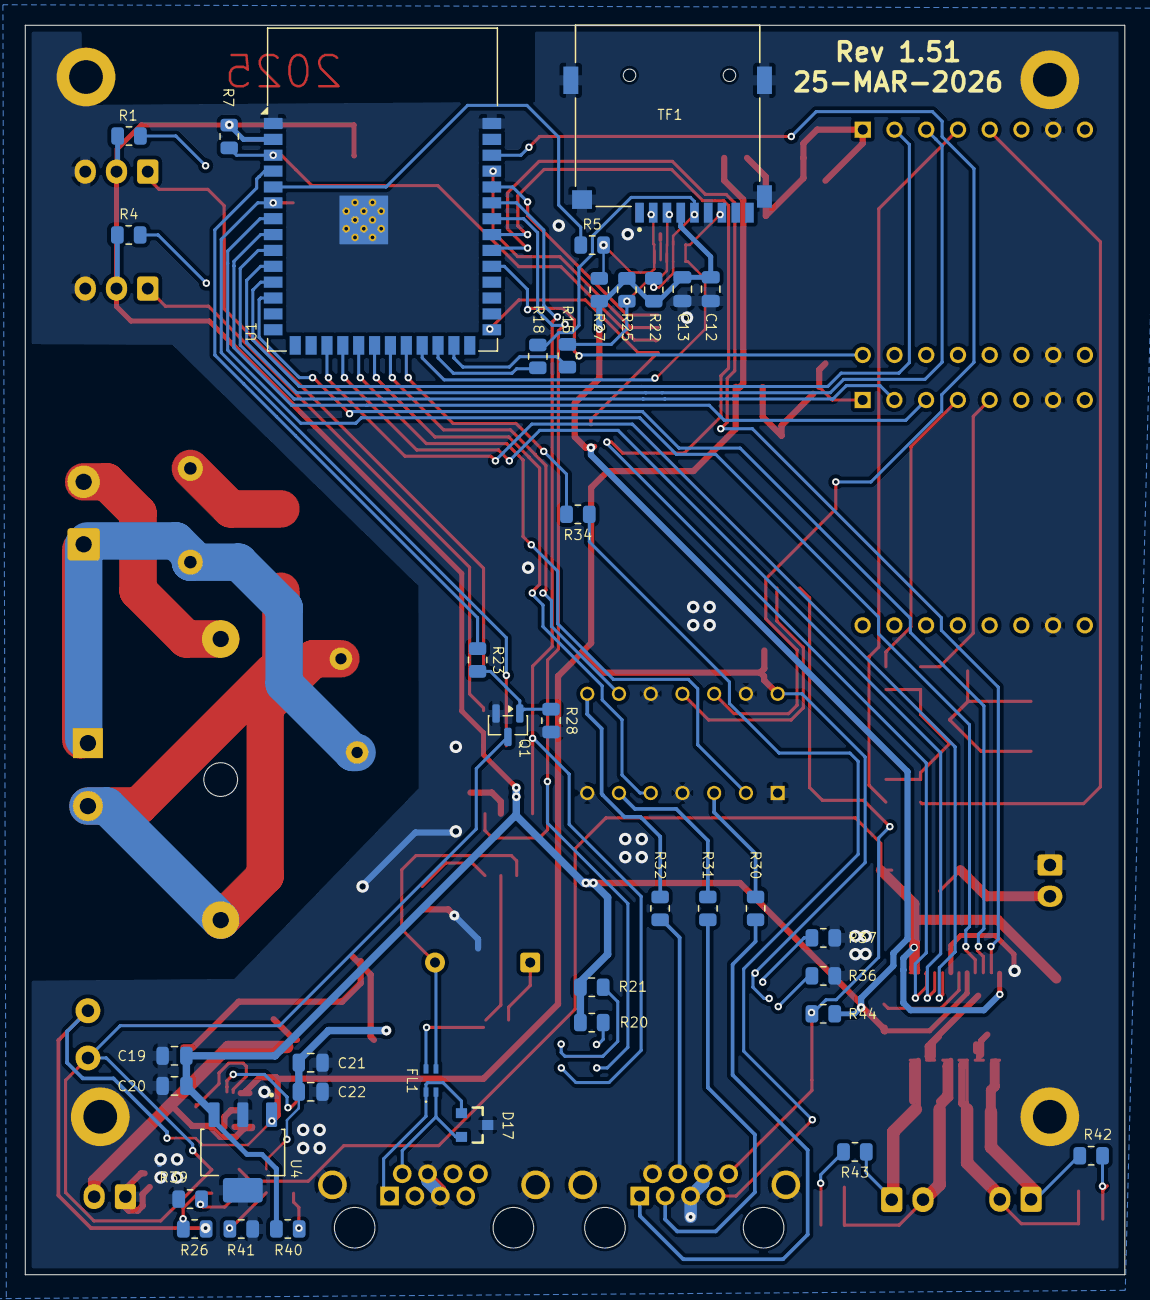
[picture p59: board rayman_main.kicad_pcb from below]

Board: 2 copper layers, 88.0 x 100.0 mm, 114 parts (38 on the bottom side), 88 nets.
