pioter1234567/airhockey/electronics/lcd-unit-STM32/rayman_LCD_STM.kicad_pcb

## KiCad design electronics/lcd-unit-STM32/rayman_LCD_STM.kicad_pcb (2026-06-02)

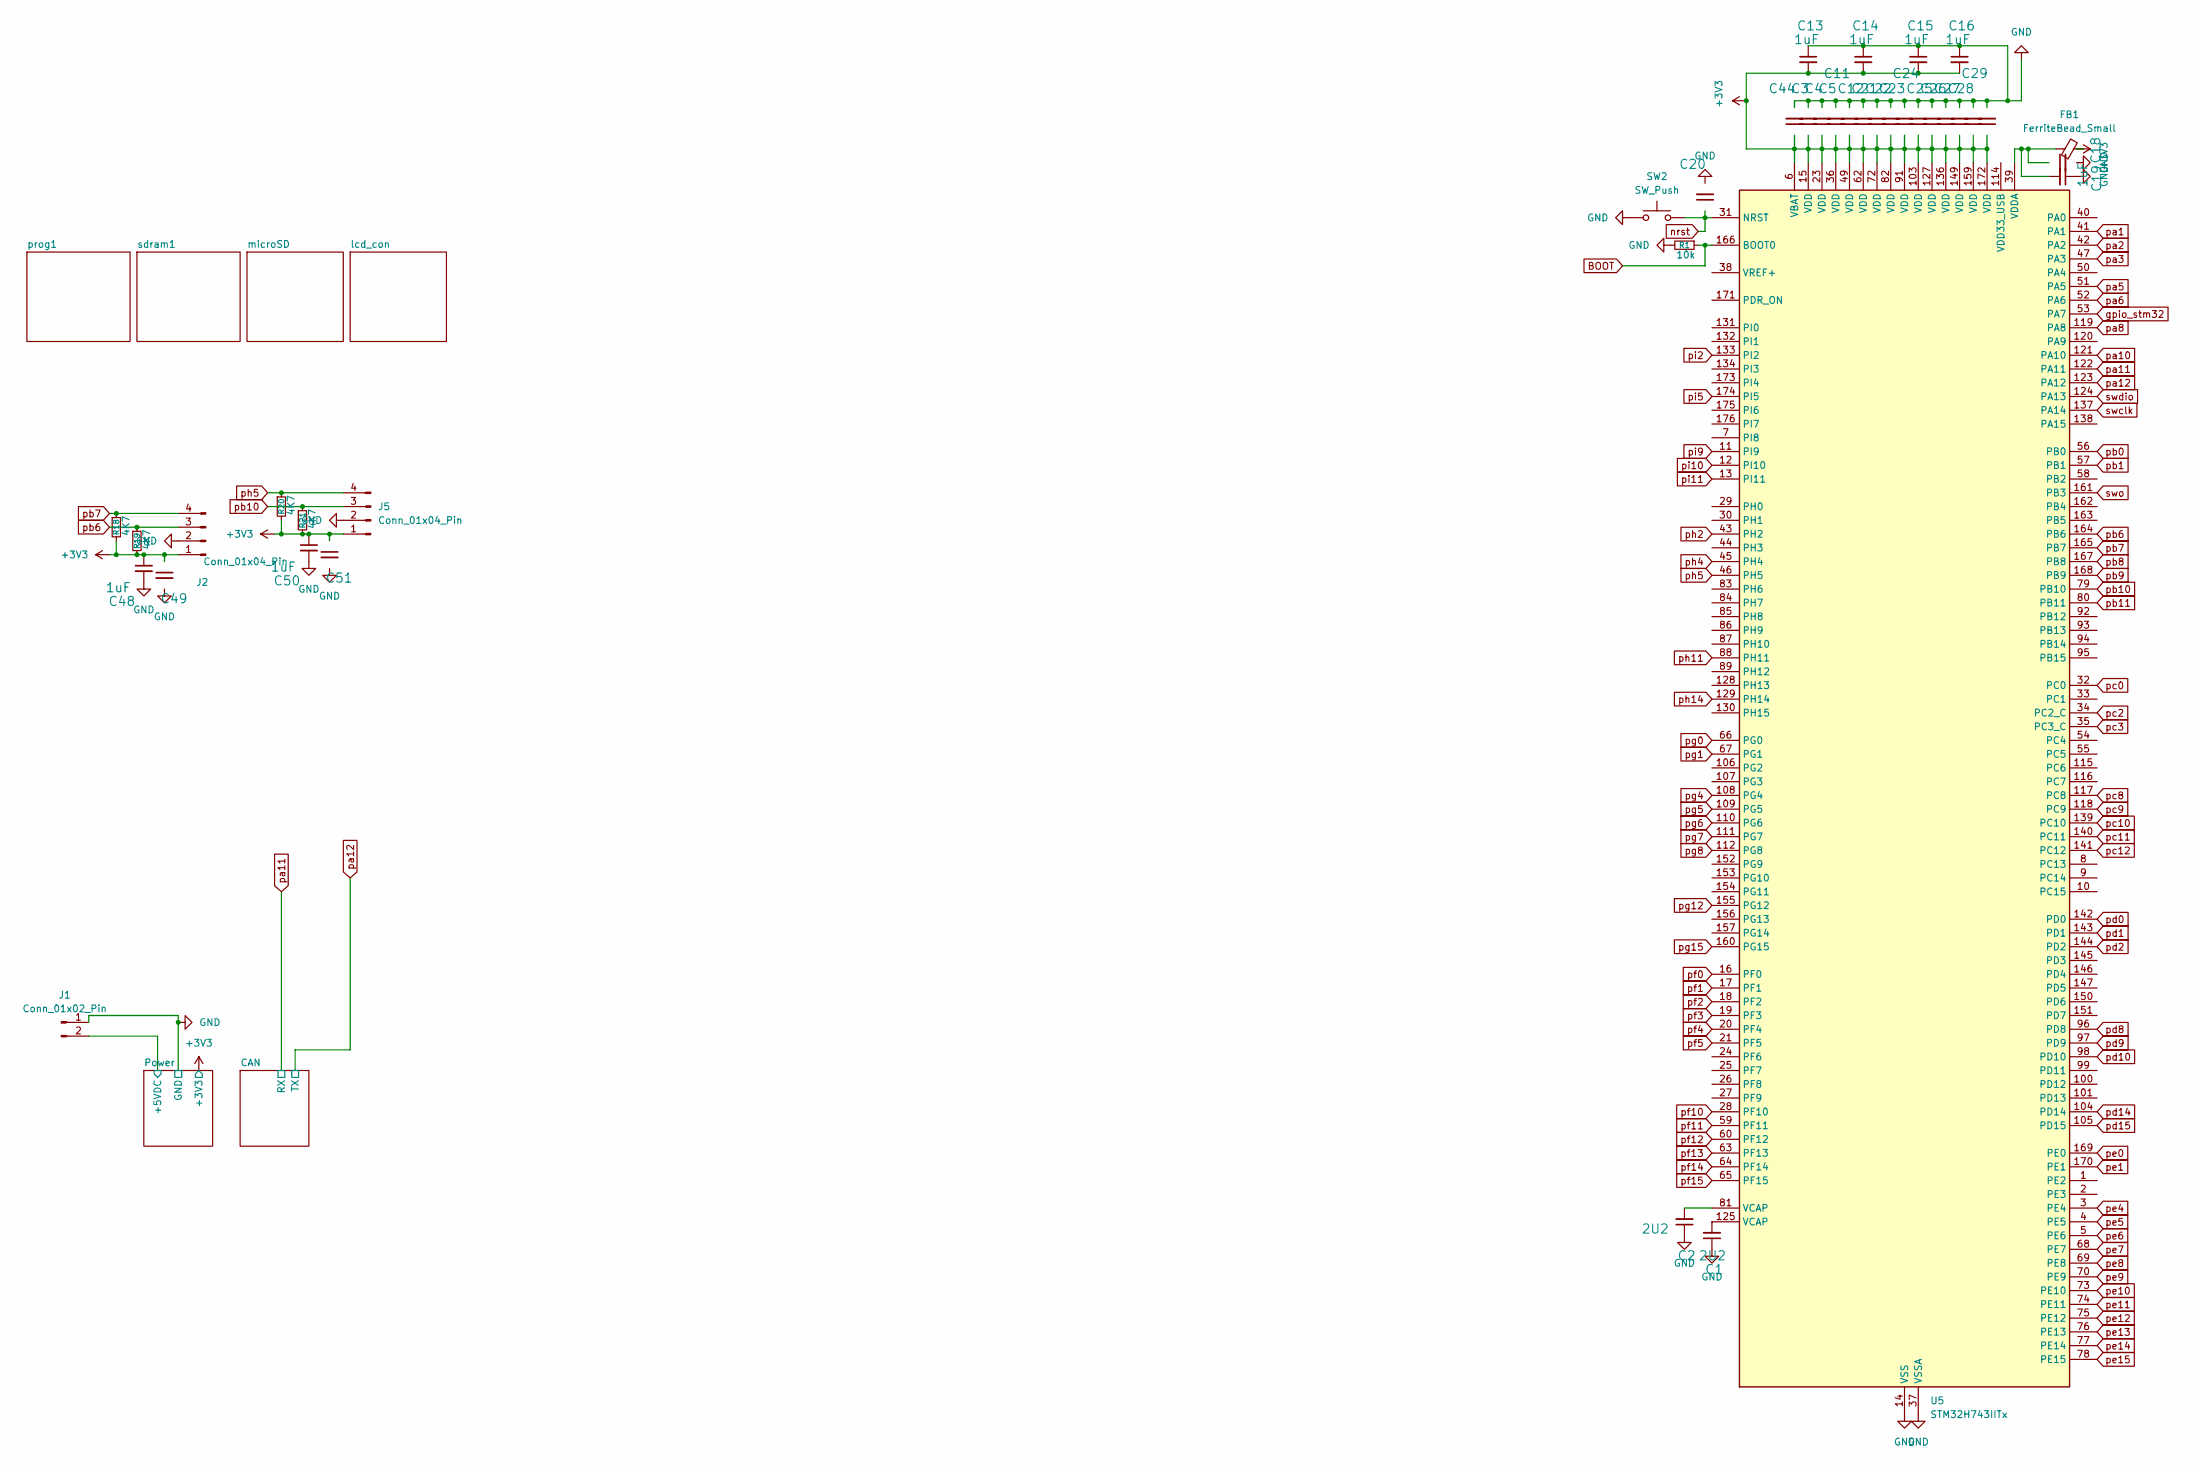
[picture p60: schematic rayman_LCD_STM.kicad_sch]

Parts:
C1, C2: 2U2; C_0603_1608Metric; Manufacturer Part 0805ZD106KAT2A
C3, C4, C5, C11, C12, C18, C20, C21, C22, C23, C24, C25, C26, C27, C28, C29, C44, C49, C51: 100nF; C_0603_1608Metric; Manufacturer Part 0805B104K160CT-C
C13, C14, C15, C16, C19, C48, C50: 1uF; C_0603_1608Metric; Manufacturer Part 0805ZD106KAT2A
FB1: FerriteBead_Small; ferrit_0805
J1: Conn_01x02_Pin; Molex_Micro-Latch_53253-0270_1x02_P2.00mm_Vertical
J2, J5: Conn_01x04_Pin; Molex_KK-254_AE-6410-04A_1x04_P2.54mm_Vertical
R1: 10k; R_0805_2012Metric
R18, R19, R20, R21: 4K7; R_0805_2012Metric
SW2: SW_Push; switch tacticle 3_4_2 smd
U5: STM32H743IITx; LQFP-176_24x24mm_P0.5mm

Connections:
+3V3: C3.1, C4.1, C5.1, C11.1, C12.1, C13.2, C14.2, C15.2, C16.2, C21.1, C22.1, C23.1, C24.1, C25.1, C26.1, C27.1, C28.1, C29.1, C44.1, C48.1, C49.1, C50.1, C51.1, FB1.2, J2.1 (VCC), J5.1 (VCC), R18.2, R19.2, R20.2, R21.2, U5.6 (VBAT), U5.15 (VDD), U5.23 (VDD), U5.36 (VDD), U5.49 (VDD), U5.62 (VDD), U5.72 (VDD), U5.82 (VDD), U5.91 (VDD), U5.103 (VDD), U5.127 (VDD), U5.136 (VDD), U5.149 (VDD), U5.159 (VDD), U5.172 (VDD); also elsewhere on the board
/Power/+5VDC: J1.2; also elsewhere on the board
BOOT: R1.1, U5.166 (BOOT0); also elsewhere on the board
GND: C1.1, C2.1, C3.2, C4.2, C5.2, C11.2, C12.2, C13.1, C14.1, C15.1, C16.1, C18.2, C19.1, C20.2, C21.2, C22.2, C23.2, C24.2, C25.2, C26.2, C27.2, C28.2, C29.2, C44.2, C48.2, C49.2, C50.2, C51.2, J1.1, J2.2 (GND), J5.2 (GND), R1.2, SW2.1, U5.14 (VSS), U5.22 (VSS), U5.37 (VSSA), U5.48 (VSS), U5.61 (VSS), U5.71 (VSS), U5.90 (VSS), U5.102 (VSS), U5.113 (VSS), U5.126 (VSS), U5.135 (VSS), U5.148 (VSS), U5.158 (VSS); also elsewhere on the board
unnamed: C1.2, U5.125 (VCAP)
unnamed: C2.2, U5.81 (VCAP)
unnamed: C18.1, C19.2, FB1.1, U5.39 (VDDA)
gpio_stm32: U5.53 (PA7); also elsewhere on the board
nrst: C20.1, SW2.2, U5.31 (NRST); also elsewhere on the board
pa1: U5.41 (PA1); also elsewhere on the board
pa2: U5.42 (PA2); also elsewhere on the board
pa3: U5.47 (PA3); also elsewhere on the board
pa5: U5.51 (PA5); also elsewhere on the board
pa6: U5.52 (PA6); also elsewhere on the board
pa8: U5.119 (PA8); also elsewhere on the board
pa10: U5.121 (PA10); also elsewhere on the board
pa11: U5.122 (PA11); also elsewhere on the board
pa12: U5.123 (PA12); also elsewhere on the board
pb0: U5.56 (PB0); also elsewhere on the board
pb1: U5.57 (PB1); also elsewhere on the board
pb6: J2.3 (SCK), R19.1, U5.164 (PB6)
pb7: J2.4 (SDK), R18.1, U5.165 (PB7)
pb8: U5.167 (PB8); also elsewhere on the board
pb9: U5.168 (PB9); also elsewhere on the board
pb10: J5.3 (SCK), R21.1, U5.79 (PB10)
pb11: U5.80 (PB11); also elsewhere on the board
pc0: U5.32 (PC0); also elsewhere on the board
pc2: U5.34 (PC2_C); also elsewhere on the board
pc3: U5.35 (PC3_C); also elsewhere on the board
pc8: U5.117 (PC8); also elsewhere on the board
pc9: U5.118 (PC9); also elsewhere on the board
pc10: U5.139 (PC10); also elsewhere on the board
pc11: U5.140 (PC11); also elsewhere on the board
pc12: U5.141 (PC12); also elsewhere on the board
pd0: U5.142 (PD0); also elsewhere on the board
pd1: U5.143 (PD1); also elsewhere on the board
pd2: U5.144 (PD2); also elsewhere on the board
pd8: U5.96 (PD8); also elsewhere on the board
pd9: U5.97 (PD9); also elsewhere on the board
pd10: U5.98 (PD10); also elsewhere on the board
pd14: U5.104 (PD14); also elsewhere on the board
pd15: U5.105 (PD15); also elsewhere on the board
pe0: U5.169 (PE0); also elsewhere on the board
pe1: U5.170 (PE1); also elsewhere on the board
pe4: U5.3 (PE4); also elsewhere on the board
pe5: U5.4 (PE5); also elsewhere on the board
pe6: U5.5 (PE6); also elsewhere on the board
pe7: U5.68 (PE7); also elsewhere on the board
pe8: U5.69 (PE8); also elsewhere on the board
pe9: U5.70 (PE9); also elsewhere on the board
pe10: U5.73 (PE10); also elsewhere on the board
pe11: U5.74 (PE11); also elsewhere on the board
pe12: U5.75 (PE12); also elsewhere on the board
pe13: U5.76 (PE13); also elsewhere on the board
pe14: U5.77 (PE14); also elsewhere on the board
pe15: U5.78 (PE15); also elsewhere on the board
pf0: U5.16 (PF0); also elsewhere on the board
pf1: U5.17 (PF1); also elsewhere on the board
pf2: U5.18 (PF2); also elsewhere on the board
pf3: U5.19 (PF3); also elsewhere on the board
pf4: U5.20 (PF4); also elsewhere on the board
pf5: U5.21 (PF5); also elsewhere on the board
pf10: U5.28 (PF10); also elsewhere on the board
pf11: U5.59 (PF11); also elsewhere on the board
pf12: U5.60 (PF12); also elsewhere on the board
pf13: U5.63 (PF13); also elsewhere on the board
pf14: U5.64 (PF14); also elsewhere on the board
pf15: U5.65 (PF15); also elsewhere on the board
pg0: U5.66 (PG0); also elsewhere on the board
pg1: U5.67 (PG1); also elsewhere on the board
pg4: U5.108 (PG4); also elsewhere on the board
pg5: U5.109 (PG5); also elsewhere on the board
pg6: U5.110 (PG6); also elsewhere on the board
pg7: U5.111 (PG7); also elsewhere on the board
pg8: U5.112 (PG8); also elsewhere on the board
pg12: U5.155 (PG12); also elsewhere on the board
pg15: U5.160 (PG15); also elsewhere on the board
ph2: U5.43 (PH2); also elsewhere on the board
ph4: U5.45 (PH4); also elsewhere on the board
ph5: J5.4 (SDK), R20.1, U5.46 (PH5)
ph11: U5.88 (PH11); also elsewhere on the board
ph14: U5.129 (PH14); also elsewhere on the board
pi2: U5.133 (PI2); also elsewhere on the board
pi5: U5.174 (PI5); also elsewhere on the board
pi9: U5.11 (PI9); also elsewhere on the board
pi10: U5.12 (PI10); also elsewhere on the board
pi11: U5.13 (PI11); also elsewhere on the board
swclk: U5.137 (PA14); also elsewhere on the board
swdio: U5.124 (PA13); also elsewhere on the board
swo: U5.161 (PB3); also elsewhere on the board

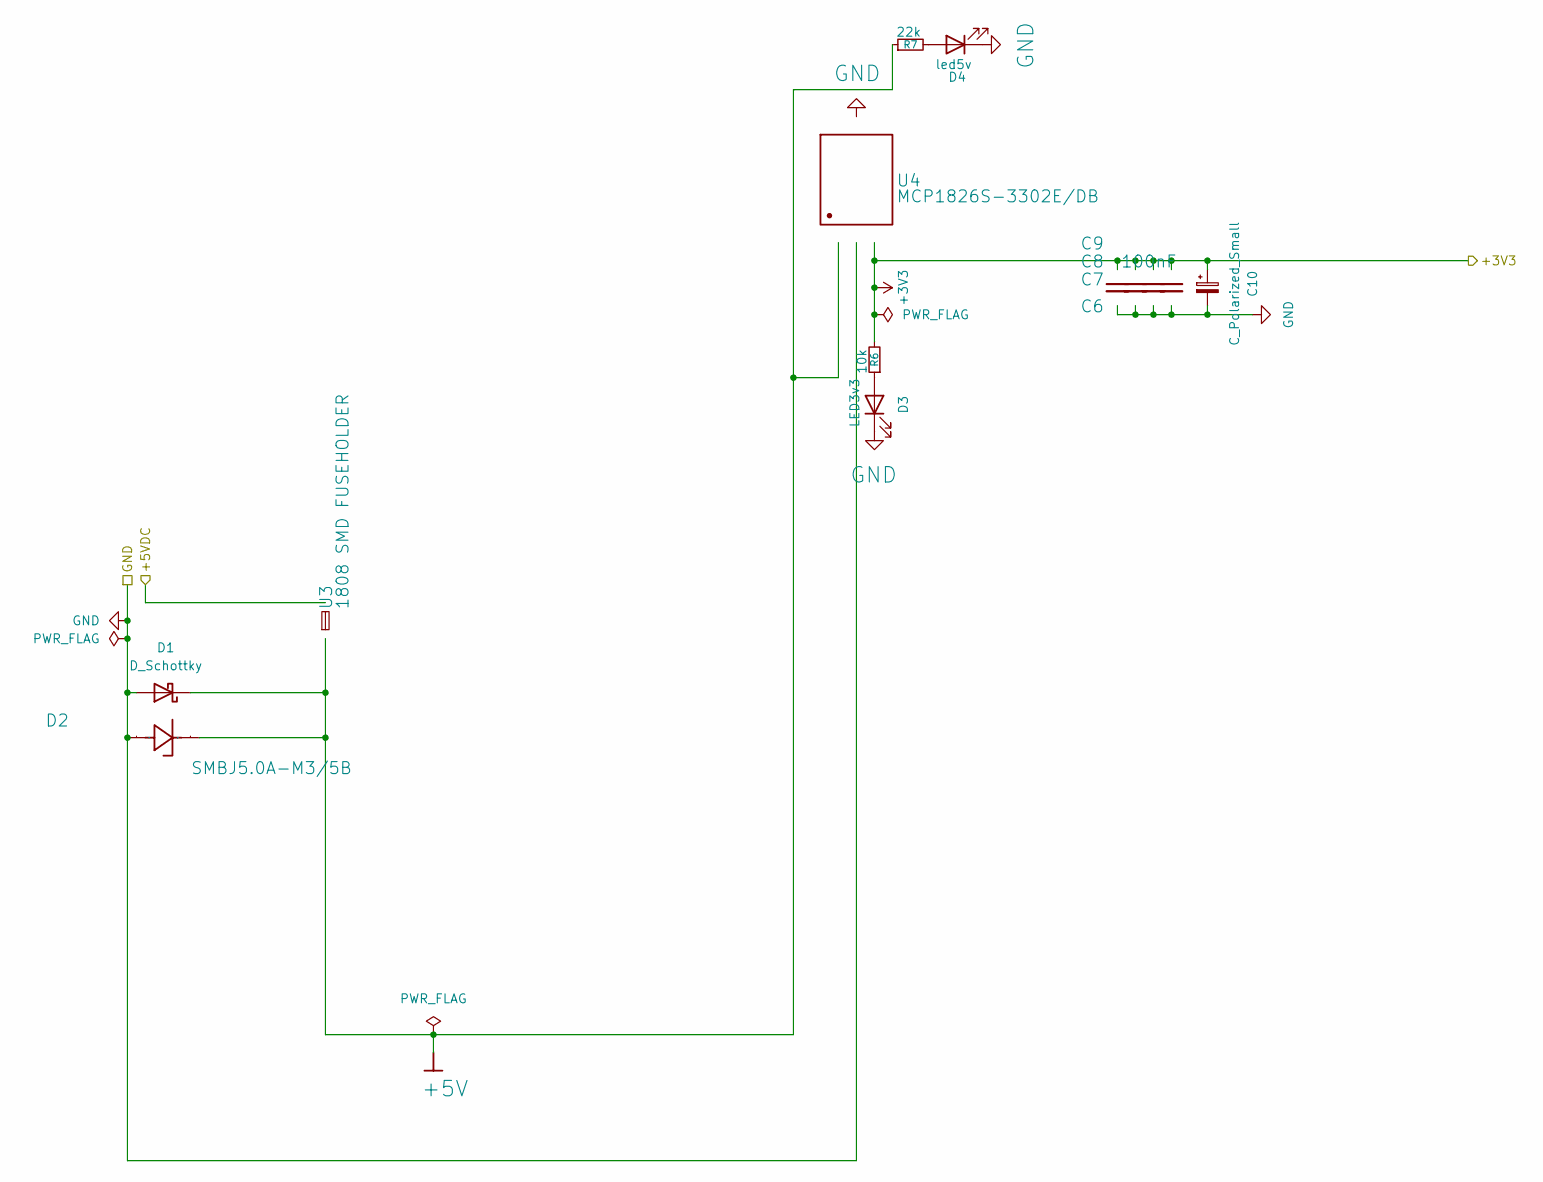
[picture p61: schematic power5v.kicad_sch]

Parts:
C6, C7, C8, C9: 100nF; C_0603_1608Metric; Manufacturer Part 0805B104K160CT-C
C10: C_Polarized_Small; CP_7343-tantal
D1: D_Schottky; D_SMA
D2: SMBJ5.0A-M3/5B; D_SMB; Manufacturer Part SMBJ5.0A-M3/5B
D3: LED3v3; LED_0805_2012Metric
D4: led5v; LED_0805_2012Metric
R6: 10k; R_0805_2012Metric
R7: 22k; R_0805_2012Metric
U3: 1808 SMD FUSEHOLDER; FUSE_1808; Manufacturer Part 1808 SMD Fuseholder
U4: MCP1826S-3302E/DB; MCP1826S-5002EDB; Manufacturer Part MCP1826S-3302E/DB

Connections:
+3V3: C6.1, C7.1, C8.1, C9.1, C10.1, R6.2, U4.3 (VOUT); also elsewhere on the board
+5V: D1.1 (K), D2.1 (K), R7.1, U3.1, U4.1 (VIN)
/Power/+5VDC: U3.2; also elsewhere on the board
GND: C6.2, C7.2, C8.2, C9.2, C10.2, D1.2 (A), D2.2 (A), D3.1 (K), D4.1 (K), U4.2 (GND), U4.4 (GND); also elsewhere on the board
unnamed: D3.2 (A), R6.1
unnamed: D4.2 (A), R7.2

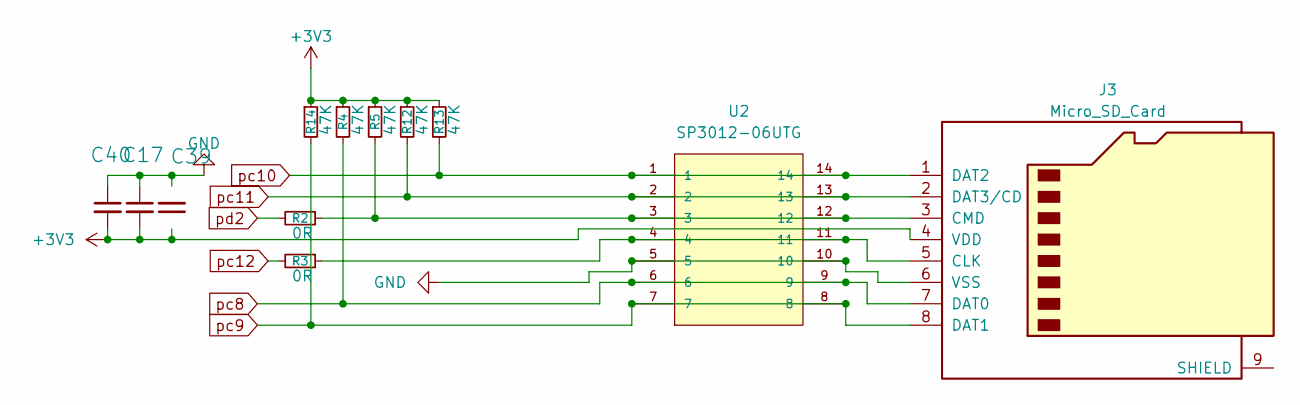
[picture p62: schematic untitled.kicad_sch]

Parts:
C17: 1uF; C_0603_1608Metric; Manufacturer Part 0805ZD106KAT2A
C39: 100nF; C_0603_1608Metric; Manufacturer Part 0805B104K160CT-C
C40: 10uF; C_0603_1608Metric; Manufacturer Part 0805ZD106KAT2A
J3: Micro_SD_Card; CUI_MSD-4-A
R2, R3: 0R; R_0805_2012Metric
R4, R5, R12, R13, R14: 47K; R_0805_2012Metric
U2: SP3012-06UTG; SON50P350X135X55-14N; PARTREV 02/23/17

Connections:
+3V3: C17.2, C39.1, C40.2, J3.4 (VDD), R4.1, R5.1, R12.1, R13.1, R14.1; also elsewhere on the board
GND: C17.1, C39.2, C40.1, J3.6 (VSS), U2.5, U2.10; also elsewhere on the board
unnamed: J3.5 (CLK), R3.1, U2.4, U2.11
unnamed: J3.3 (CMD), R2.1, R5.2, U2.3, U2.12
pc8: J3.7 (DAT0), R4.2, U2.6, U2.9; also elsewhere on the board
pc9: J3.8 (DAT1), R14.2, U2.7, U2.8; also elsewhere on the board
pc10: J3.1 (DAT2), R13.2, U2.1, U2.14; also elsewhere on the board
pc11: J3.2 (DAT3/CD), R12.2, U2.2, U2.13; also elsewhere on the board
pc12: R3.2; also elsewhere on the board
pd2: R2.2; also elsewhere on the board

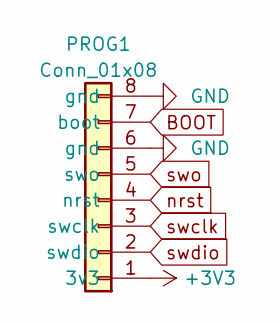
[picture p63: schematic prog1.kicad_sch]

Parts:
PROG1: Conn_01x08; Hirose_FH12-8S-0.5SH_1x08-1MP_P0.50mm_Horizontal

Connections:
+3V3: PROG1.1 (3v3); also elsewhere on the board
BOOT: PROG1.7 (boot); also elsewhere on the board
GND: PROG1.6 (gnd), PROG1.8 (gnd); also elsewhere on the board
nrst: PROG1.4 (nrst); also elsewhere on the board
swclk: PROG1.3 (swclk); also elsewhere on the board
swdio: PROG1.2 (swdio); also elsewhere on the board
swo: PROG1.5 (swo); also elsewhere on the board
