pioter1234567/airhockey/electronics/lcd-unit-STM32/rayman_LCD_STM.kicad_pcb

## KiCad design electronics/lcd-unit-STM32/rayman_LCD_STM.kicad_pcb (continued)

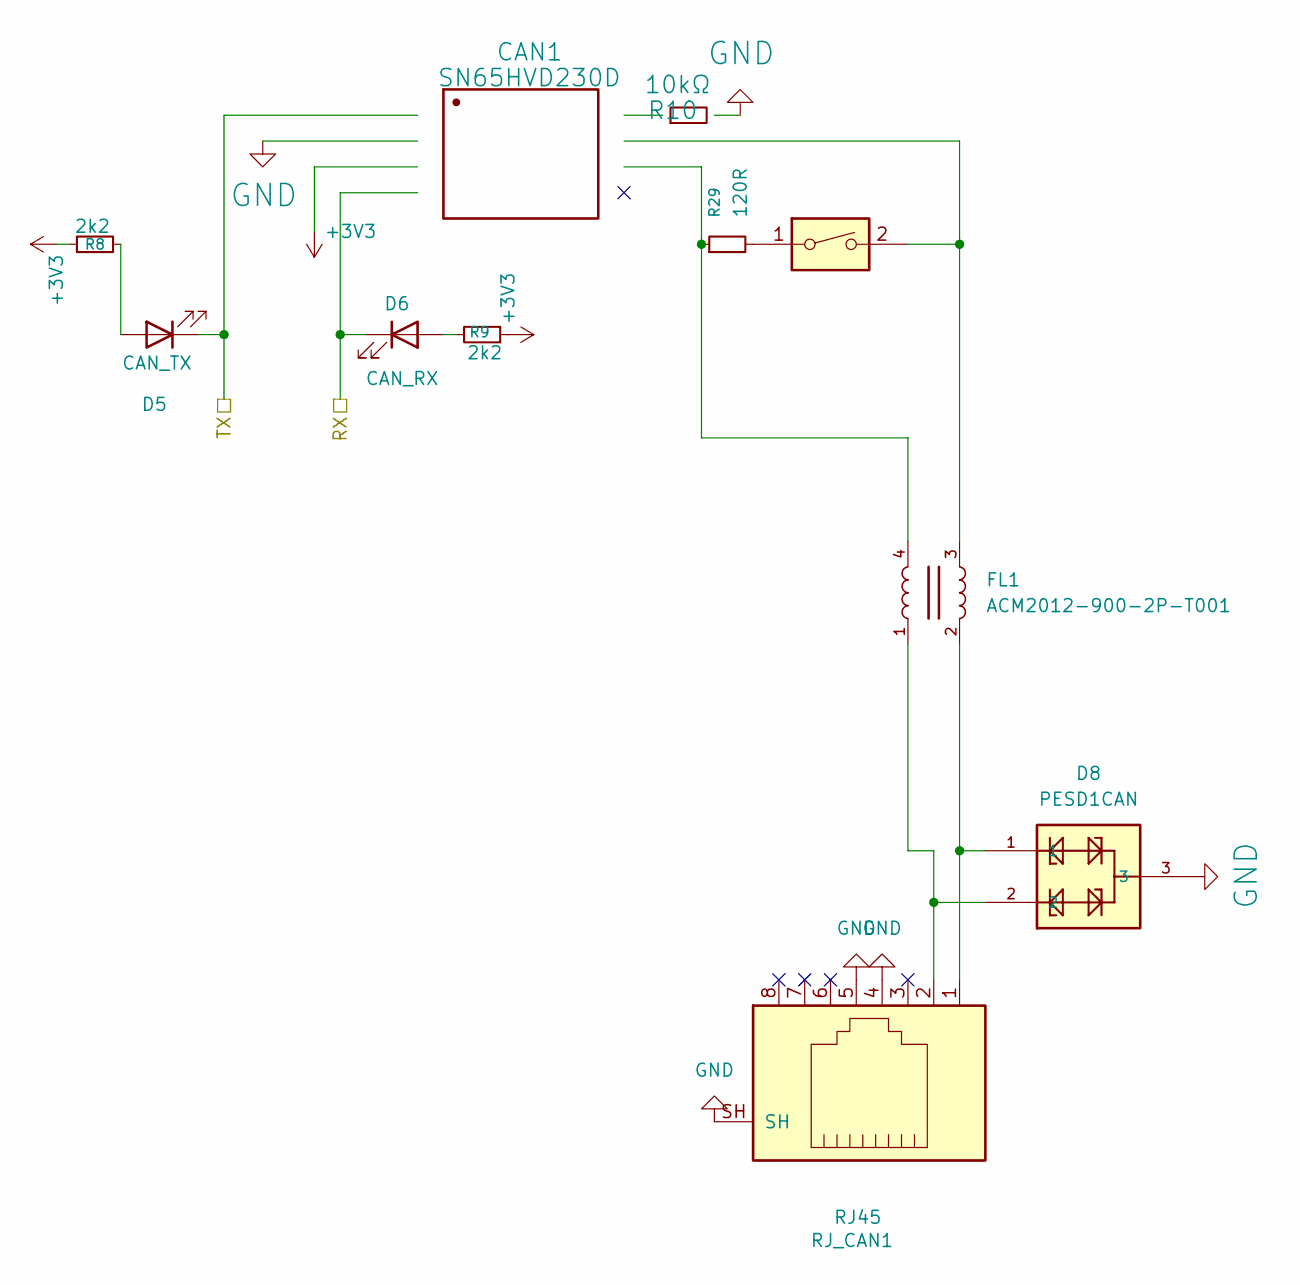
[picture p64: schematic can.kicad_sch]

Parts:
CAN1: SN65HVD230D; SOIC127P599X175-8N; Manufacturer Part SN65HVD230D
D5: CAN_TX; LED_0805_2012Metric
D6: CAN_RX; LED_0805_2012Metric
D8: PESD1CAN; SOT23-3
FL1: ACM2012-900-2P-T001; FIL_ACM2012-900-2P-T001
R8, R9: 2k2; R_0805_2012Metric
R10: 10kΩ; R_0805_2012Metric; Manufacturer Part RT0603LRA0710KL
R29: 120R; R_0805_2012Metric
RJ_CAN1: RJ45; RJ45_Amphenol_RJHSE5380
SW_CAN_T1: SW_DIP_x01; SW_DIP_SPSTx01_Slide_6.7x4.1mm_W7.62mm_P2.54mm_LowProfile

Connections:
+3V3: CAN1.3 (VCC), R8.1, R9.1; also elsewhere on the board
GND: CAN1.2 (GND), D8.3, R10.2, RJ_CAN1.4, RJ_CAN1.5, RJ_CAN1.SH; also elsewhere on the board
unnamed: CAN1.7 (CANH), FL1.3, SW_CAN_T1.2
unnamed: CAN1.6 (CANL), FL1.4, R29.1
unnamed: CAN1.8 (RS), R10.1
unnamed: D5.2 (A), R8.2
unnamed: D6.2 (A), R9.2
unnamed: D8.1, FL1.2, RJ_CAN1.1
unnamed: D8.2, FL1.1, RJ_CAN1.2
unnamed: R29.2, SW_CAN_T1.1
pa11: CAN1.4 (R), D6.1 (K); also elsewhere on the board
pa12: CAN1.1 (D), D5.1 (K); also elsewhere on the board

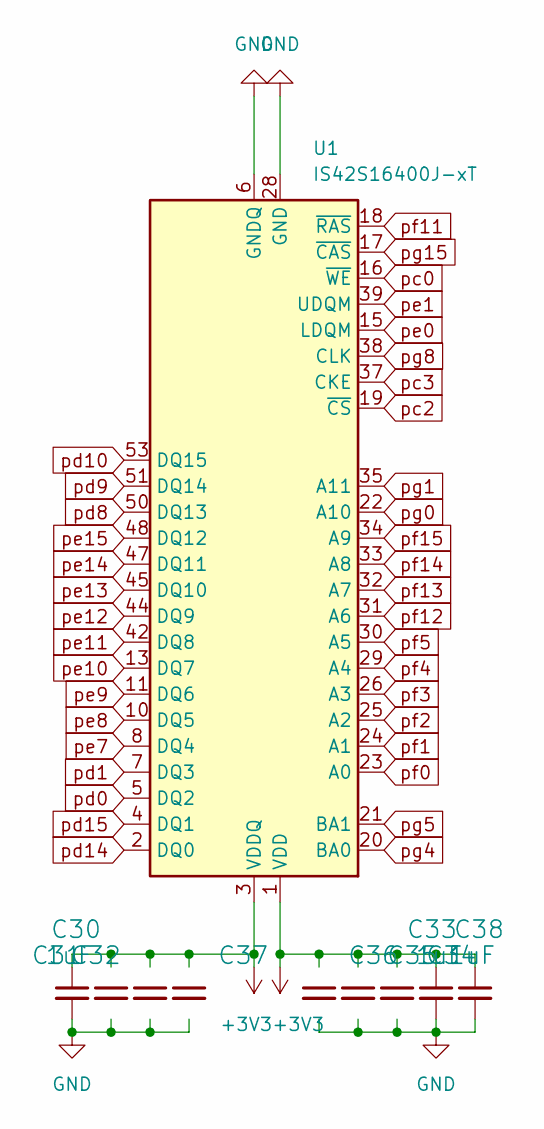
[picture p65: schematic sdram1.kicad_sch]

Parts:
C30, C33, C38: 1uF; C_0603_1608Metric; Manufacturer Part 0805ZD106KAT2A
C31, C32, C34, C35, C36, C37: 100nF; C_0603_1608Metric; Manufacturer Part 0805B104K160CT-C
U1: IS42S16400J-xT; TSOP-II-54_22.2x10.16mm_P0.8mm

Connections:
+3V3: C30.1, C31.1, C32.1, C33.1, C34.1, C35.1, C36.1, C37.1, C38.1, U1.1 (VDD), U1.3 (VDDQ), U1.9 (VDDQ), U1.14 (VDD), U1.27 (VDD), U1.43 (VDDQ), U1.49 (VDDQ); also elsewhere on the board
GND: C30.2, C31.2, C32.2, C33.2, C34.2, C35.2, C36.2, C37.2, C38.2, U1.6 (GNDQ), U1.12 (GNDQ), U1.28 (GND), U1.41 (GND), U1.46 (GNDQ), U1.52 (GNDQ), U1.54 (GND); also elsewhere on the board
pc0: U1.16 (~WE); also elsewhere on the board
pc2: U1.19 (~CS); also elsewhere on the board
pc3: U1.37 (CKE); also elsewhere on the board
pd0: U1.5 (DQ2); also elsewhere on the board
pd1: U1.7 (DQ3); also elsewhere on the board
pd8: U1.50 (DQ13); also elsewhere on the board
pd9: U1.51 (DQ14); also elsewhere on the board
pd10: U1.53 (DQ15); also elsewhere on the board
pd14: U1.2 (DQ0); also elsewhere on the board
pd15: U1.4 (DQ1); also elsewhere on the board
pe0: U1.15 (LDQM); also elsewhere on the board
pe1: U1.39 (UDQM); also elsewhere on the board
pe7: U1.8 (DQ4); also elsewhere on the board
pe8: U1.10 (DQ5); also elsewhere on the board
pe9: U1.11 (DQ6); also elsewhere on the board
pe10: U1.13 (DQ7); also elsewhere on the board
pe11: U1.42 (DQ8); also elsewhere on the board
pe12: U1.44 (DQ9); also elsewhere on the board
pe13: U1.45 (DQ10); also elsewhere on the board
pe14: U1.47 (DQ11); also elsewhere on the board
pe15: U1.48 (DQ12); also elsewhere on the board
pf0: U1.23 (A0); also elsewhere on the board
pf1: U1.24 (A1); also elsewhere on the board
pf2: U1.25 (A2); also elsewhere on the board
pf3: U1.26 (A3); also elsewhere on the board
pf4: U1.29 (A4); also elsewhere on the board
pf5: U1.30 (A5); also elsewhere on the board
pf11: U1.18 (~RAS); also elsewhere on the board
pf12: U1.31 (A6); also elsewhere on the board
pf13: U1.32 (A7); also elsewhere on the board
pf14: U1.33 (A8); also elsewhere on the board
pf15: U1.34 (A9); also elsewhere on the board
pg0: U1.22 (A10); also elsewhere on the board
pg1: U1.35 (A11); also elsewhere on the board
pg4: U1.20 (BA0); also elsewhere on the board
pg5: U1.21 (BA1); also elsewhere on the board
pg8: U1.38 (CLK); also elsewhere on the board
pg15: U1.17 (~CAS); also elsewhere on the board

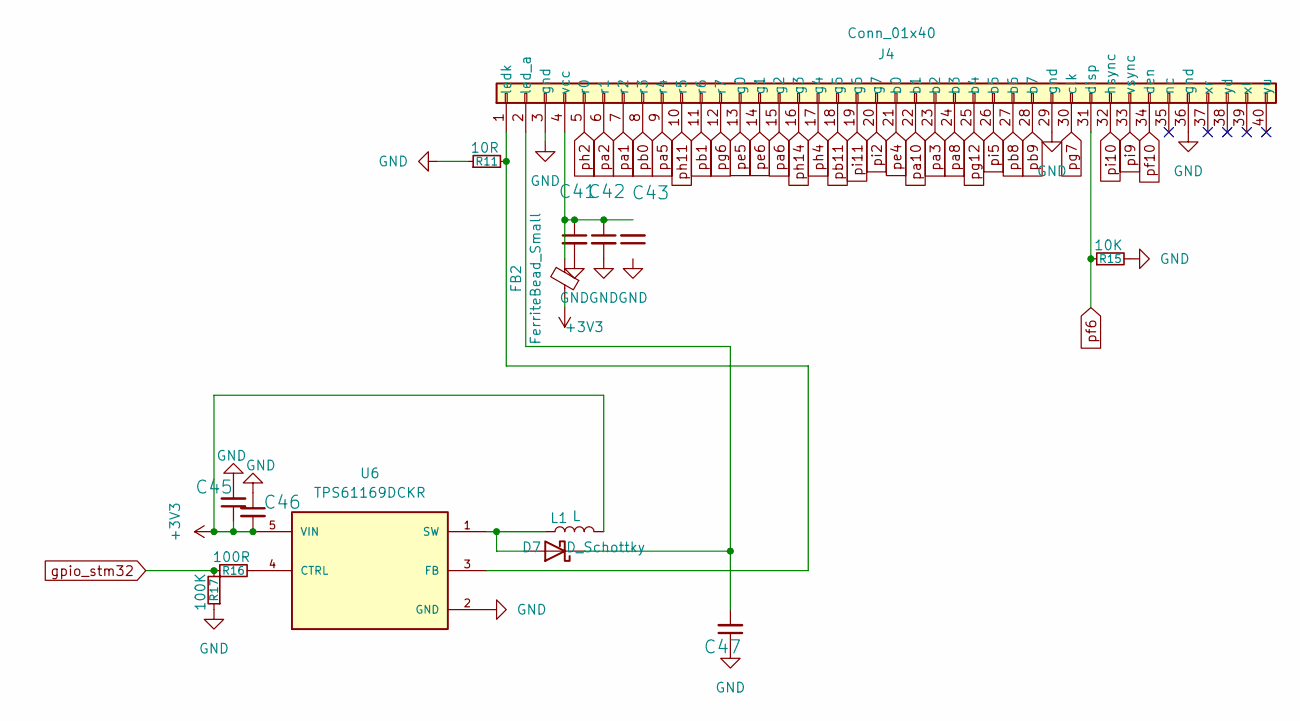
[picture p66: schematic lcd_con.kicad_sch]

Parts:
C41: 10uF; C_0603_1608Metric; Manufacturer Part 0805ZD106KAT2A
C42: 1uF; C_0603_1608Metric; Manufacturer Part 0805ZD106KAT2A
C43: 100nF; C_0603_1608Metric; Manufacturer Part 0805B104K160CT-C
C45: 4U7; C_0603_1608Metric; Manufacturer Part 0805B104K160CT-C
C46: 100n; C_0603_1608Metric; Manufacturer Part 0805ZD106KAT2A
C47: 2.2u 50v; C_0603_1608Metric; Manufacturer Part 0805ZD106KAT2A
D7: D_Schottky; D_SMA
FB2: FerriteBead_Small; ferrit_0805
J4: Conn_01x40; TE_4-1734839-0_1x40-1MP_P0.5mm_Horizontal
L1: L; L_Bourns-SRN4018
R11: 10R; R_0805_2012Metric
R15: 10K; R_0805_2012Metric
R16: 100R; R_0805_2012Metric
R17: 100K; R_0805_2012Metric
U6: TPS61169DCKR; SOT65P210X110-5N; PARTREV A

Connections:
+3V3: C45.1, C46.2, FB2.1, L1.2, U6.5 (VIN); also elsewhere on the board
GND: C41.2, C42.2, C43.1, C45.2, C46.1, C47.1, J4.3 (gnd), J4.29 (gnd), J4.36 (gnd), R11.1, R15.2, R17.1, U6.2 (GND); also elsewhere on the board
unnamed: D7.2 (A), L1.1, U6.1 (SW)
unnamed: C47.2, D7.1 (K), J4.2 (led_a)
unnamed: J4.1 (ledk), R11.2, U6.3 (FB)
unnamed: C41.1, C42.1, C43.2, FB2.2, J4.4 (vcc)
unnamed: R16.2, U6.4 (CTRL)
gpio_stm32: R16.1, R17.2; also elsewhere on the board
pa1: J4.7 (r2); also elsewhere on the board
pa2: J4.6 (r1); also elsewhere on the board
pa3: J4.23 (b2); also elsewhere on the board
pa5: J4.9 (r4); also elsewhere on the board
pa6: J4.15 (g2); also elsewhere on the board
pa8: J4.24 (b3); also elsewhere on the board
pa10: J4.22 (b1); also elsewhere on the board
pb0: J4.8 (r3); also elsewhere on the board
pb1: J4.11 (r6); also elsewhere on the board
pb8: J4.27 (b6); also elsewhere on the board
pb9: J4.28 (b7); also elsewhere on the board
pb11: J4.18 (g5); also elsewhere on the board
pe4: J4.21 (b0); also elsewhere on the board
pe5: J4.13 (g0); also elsewhere on the board
pe6: J4.14 (g1); also elsewhere on the board
pf6: J4.31 (disp), R15.1
pf10: J4.34 (den); also elsewhere on the board
pg6: J4.12 (r7); also elsewhere on the board
pg7: J4.30 (clk); also elsewhere on the board
pg12: J4.25 (b4); also elsewhere on the board
ph2: J4.5 (r0); also elsewhere on the board
ph4: J4.17 (g4); also elsewhere on the board
ph11: J4.10 (r5); also elsewhere on the board
ph14: J4.16 (g3); also elsewhere on the board
pi2: J4.20 (g7); also elsewhere on the board
pi5: J4.26 (b5); also elsewhere on the board
pi9: J4.33 (vsync); also elsewhere on the board
pi10: J4.32 (hsync); also elsewhere on the board
pi11: J4.19 (g6); also elsewhere on the board

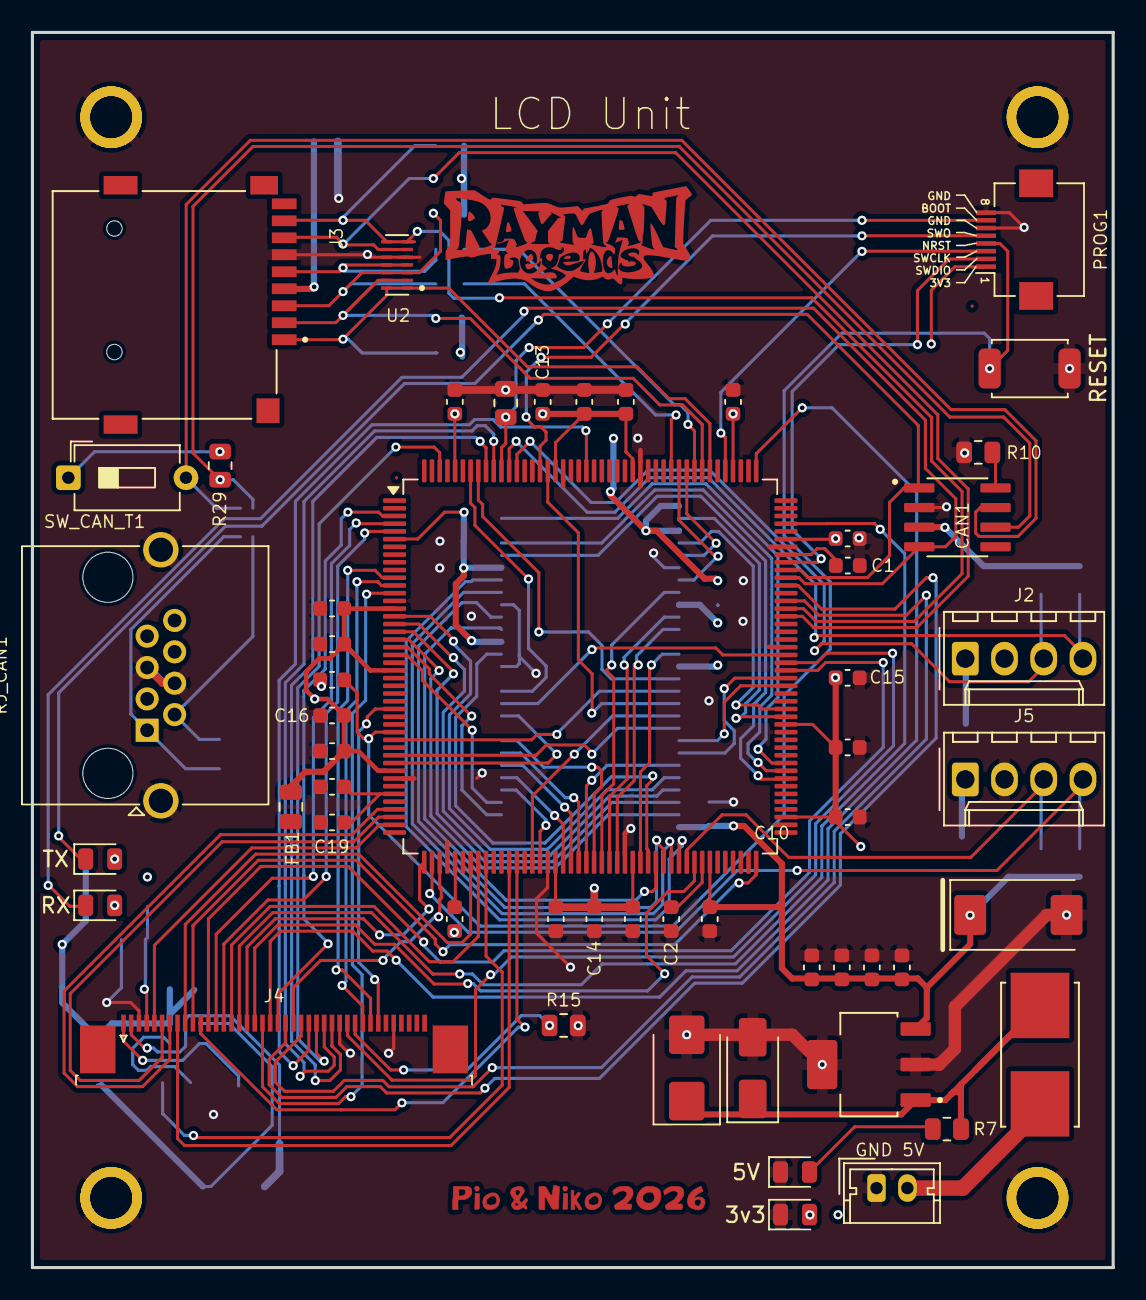
[picture p67: board rayman_LCD_STM.kicad_pcb from above]

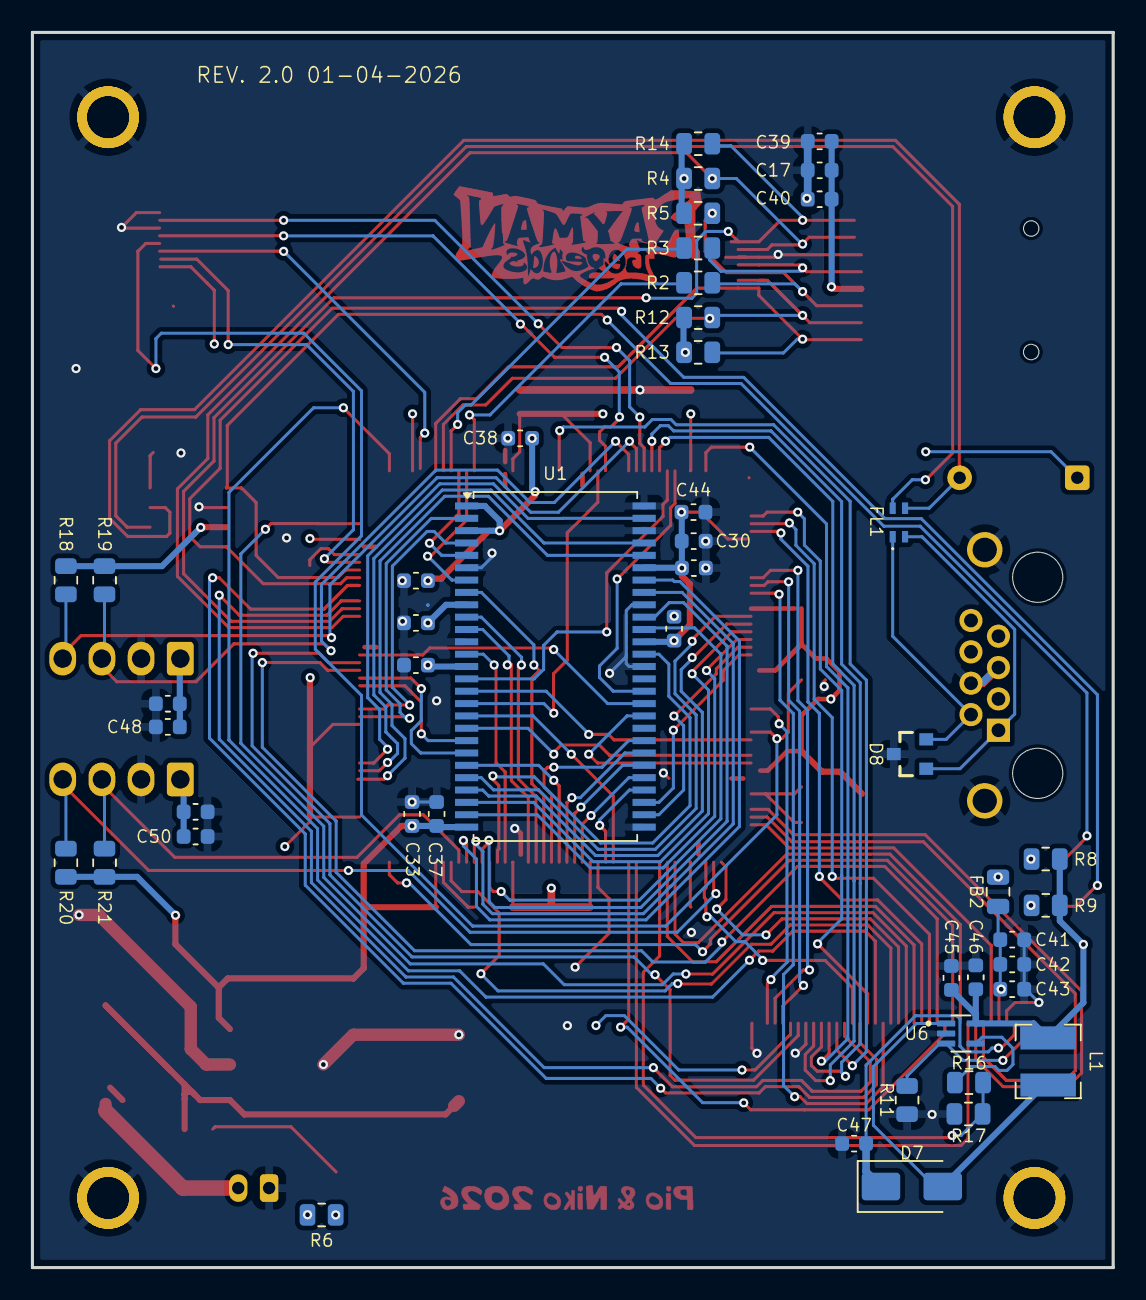
[picture p68: board rayman_LCD_STM.kicad_pcb from below]

Board: 4 copper layers, 70.0 x 80.0 mm, 101 parts (47 on the bottom side), 109 nets.
