pioter1234567/airhockey/electronics/lamp-driver/lamp-driver/lamp-driver.kicad_pcb

## KiCad design electronics/lamp-driver/lamp-driver/lamp-driver.kicad_pcb (2026-04-13)

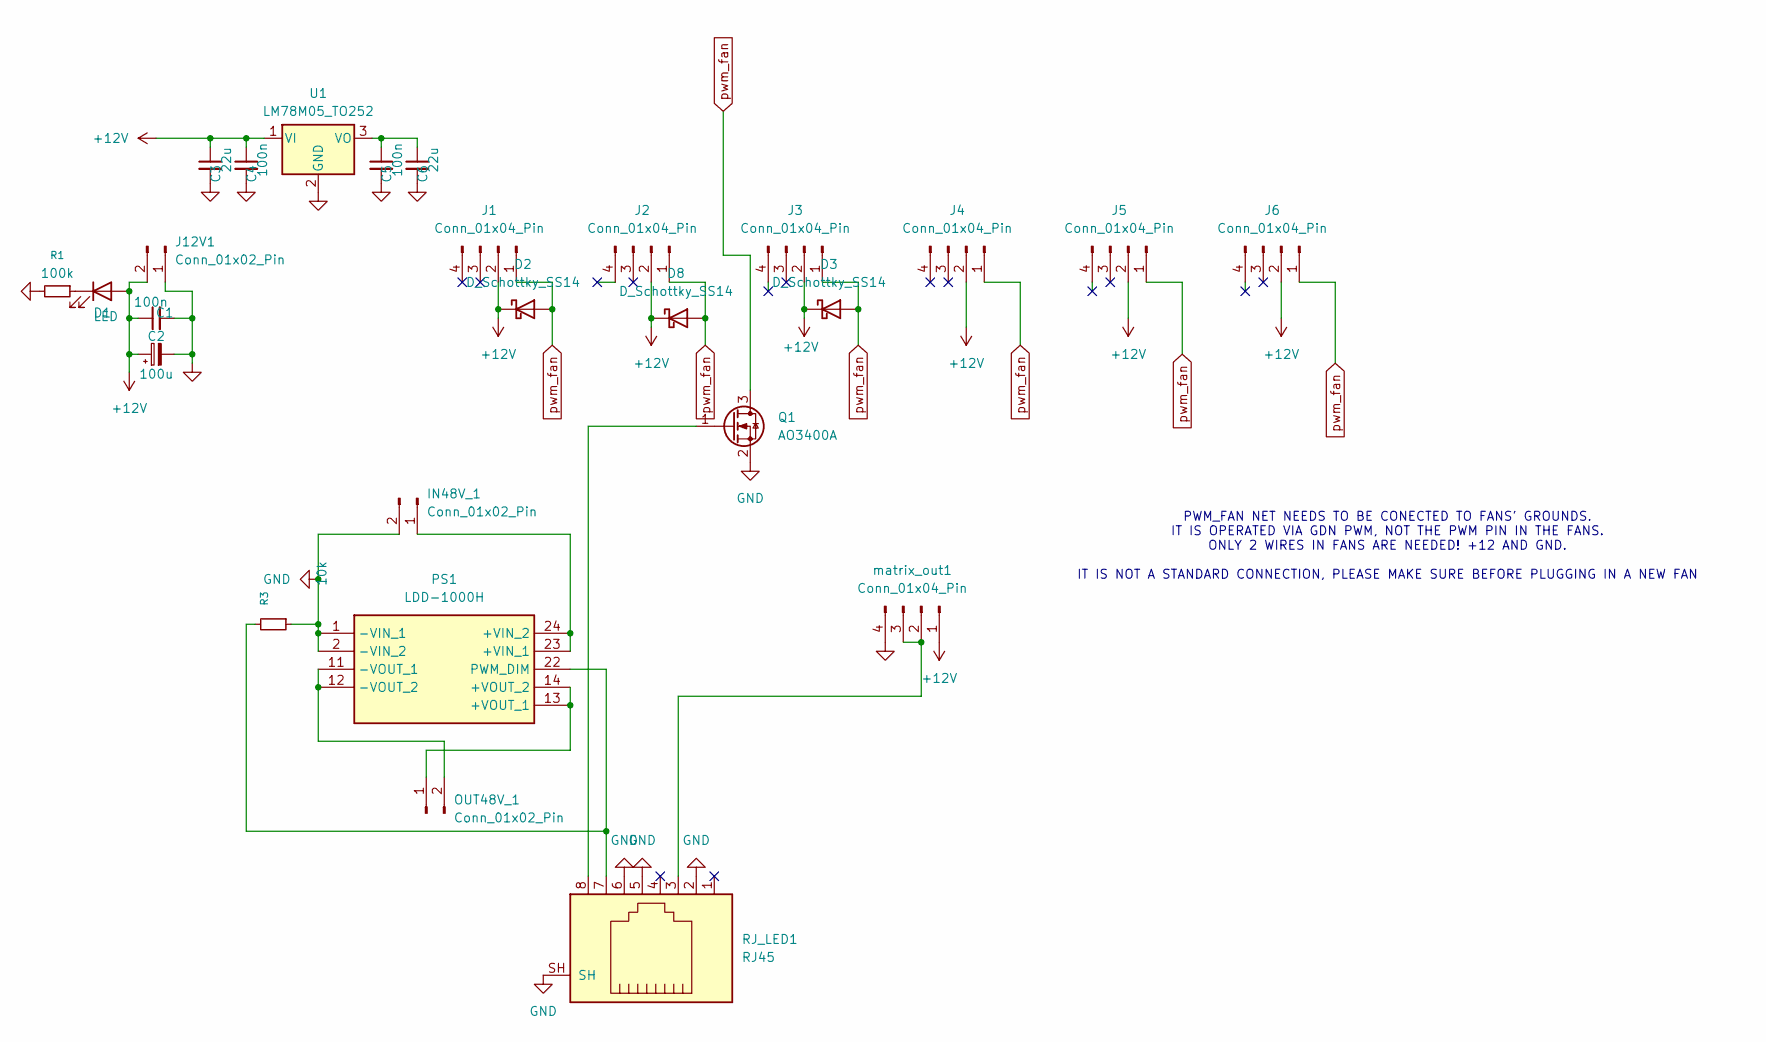
[picture p69: schematic lamp-driver.kicad_sch]

Parts:
C1, C4, C5: 100n; C_0805_2012Metric
C2: 100u; CP_Elec_6.3x7.7
C3, C6: 22u; C_0805_2012Metric
D1: LED; LED_0805_2012Metric
D2, D3, D8: D_Schottky_SS14; D_SMA
IN48V_1: Conn_01x02_Pin; Molex_KK-254_AE-6410-02A_1x02_P2.54mm_Vertical
J1, J2, J3, J4, J5, J6: Conn_01x04_Pin; TerminalBlock_Phoenix_MPT-0,5-4-2.54_1x04_P2.54mm_Horizontal
J12V1: Conn_01x02_Pin; Molex_KK-254_AE-6410-02A_1x02_P2.54mm_Vertical
OUT48V_1: Conn_01x02_Pin; Molex_KK-254_AE-6410-02A_1x02_P2.54mm_Vertical
PS1: LDD-1000H; LDD-700H; Mouser Part Number 709-LDD-1000H
Q1: AO3400A; SOT-23
R1: 100k; R_0805_2012Metric
R3: 10k; R_0805_2012Metric
RJ_LED1: RJ45; RJ45_Amphenol_RJHSE5380
U1: LM78M05_TO252; TO-252-2
matrix_out1: Conn_01x04_Pin; TerminalBlock_Phoenix_MPT-0,5-4-2.54_1x04_P2.54mm_Horizontal

Connections:
+12V: C1.1, C2.1, C3.1, C4.1, D1.2 (A), D2.1 (K), D3.1 (K), D8.1 (K), J1.2, J2.2, J3.2, J4.2, J5.2, J6.2, J12V1.2, U1.1 (VI), matrix_out1.1
GND: C1.2, C2.2, C3.2, C4.2, C5.2, C6.2, IN48V_1.2, J12V1.1, PS1.1 (-VIN_1), PS1.2 (-VIN_2), Q1.2 (S), R1.2, R3.1, RJ_LED1.2, RJ_LED1.5, RJ_LED1.6, RJ_LED1.SH, U1.2 (GND), matrix_out1.4
unnamed: D1.1 (K), R1.1
unnamed: IN48V_1.1, PS1.23 (+VIN_1), PS1.24 (+VIN_2)
unnamed: OUT48V_1.1, PS1.13 (+VOUT_1), PS1.14 (+VOUT_2)
unnamed: OUT48V_1.2, PS1.11 (-VOUT_1), PS1.12 (-VOUT_2)
unnamed: PS1.22 (PWM_DIM), R3.2, RJ_LED1.7
unnamed 7: Q1.1 (G), RJ_LED1.8; also elsewhere on the board
unnamed: C5.1, C6.1, U1.3 (VO)
unnamed: RJ_LED1.3, matrix_out1.2, matrix_out1.3
pwm_fan: D2.2 (A), D3.2 (A), D8.2 (A), J1.1, J2.1, J3.1, J4.1, J5.1, J6.1, Q1.3 (D)

Notes on the sheet:
PWM_FAN NET NEEDS TO BE CONECTED TO FANS' GROUNDS. IT IS OPERATED VIA GDN PWM, NOT THE PWM PIN IN THE FANS. ONLY 2 WIRES IN FANS ARE NEEDED! +12 AND GND. IT IS NOT A STANDARD CONNECTION, PLEASE MAKE SURE BEFORE PLUGGING IN A NEW FAN

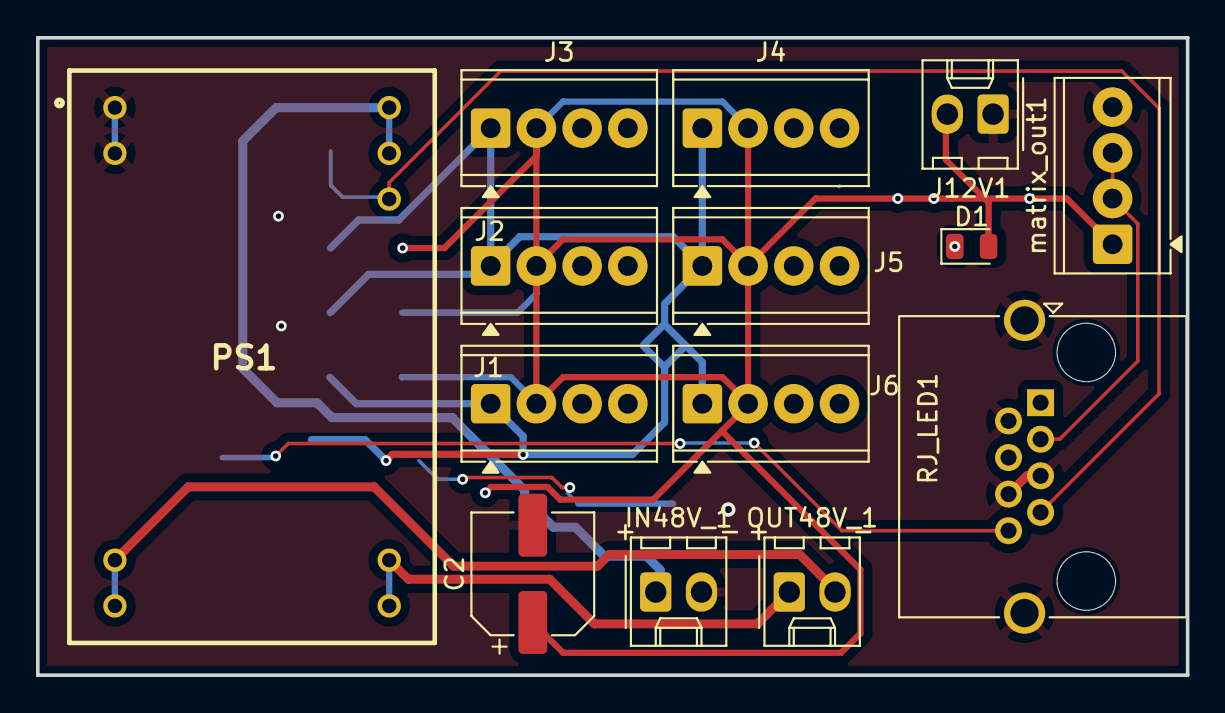
[picture p70: board lamp-driver.kicad_pcb from above]

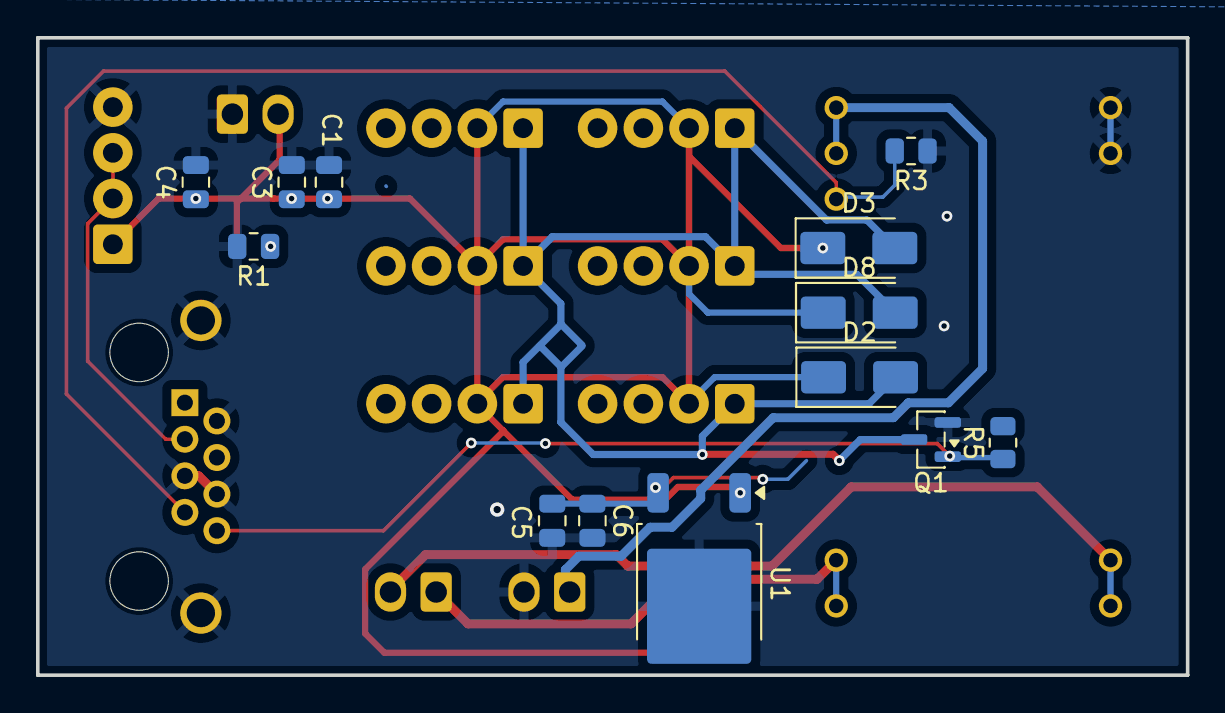
[picture p71: board lamp-driver.kicad_pcb from below]

Board: 2 copper layers, 63.9 x 35.4 mm, 27 parts (13 on the bottom side), 11 nets.

Other parts of the board:
R5: 10K; R_0805_2012Metric

Their connections:
unnamed 7: R5.1; also elsewhere on the board
