pioter1234567/airhockey/electronics/lcd-unit/rayman_LCD.kicad_pcb

## KiCad design electronics/lcd-unit/rayman_LCD.kicad_pcb (2026-03-13)

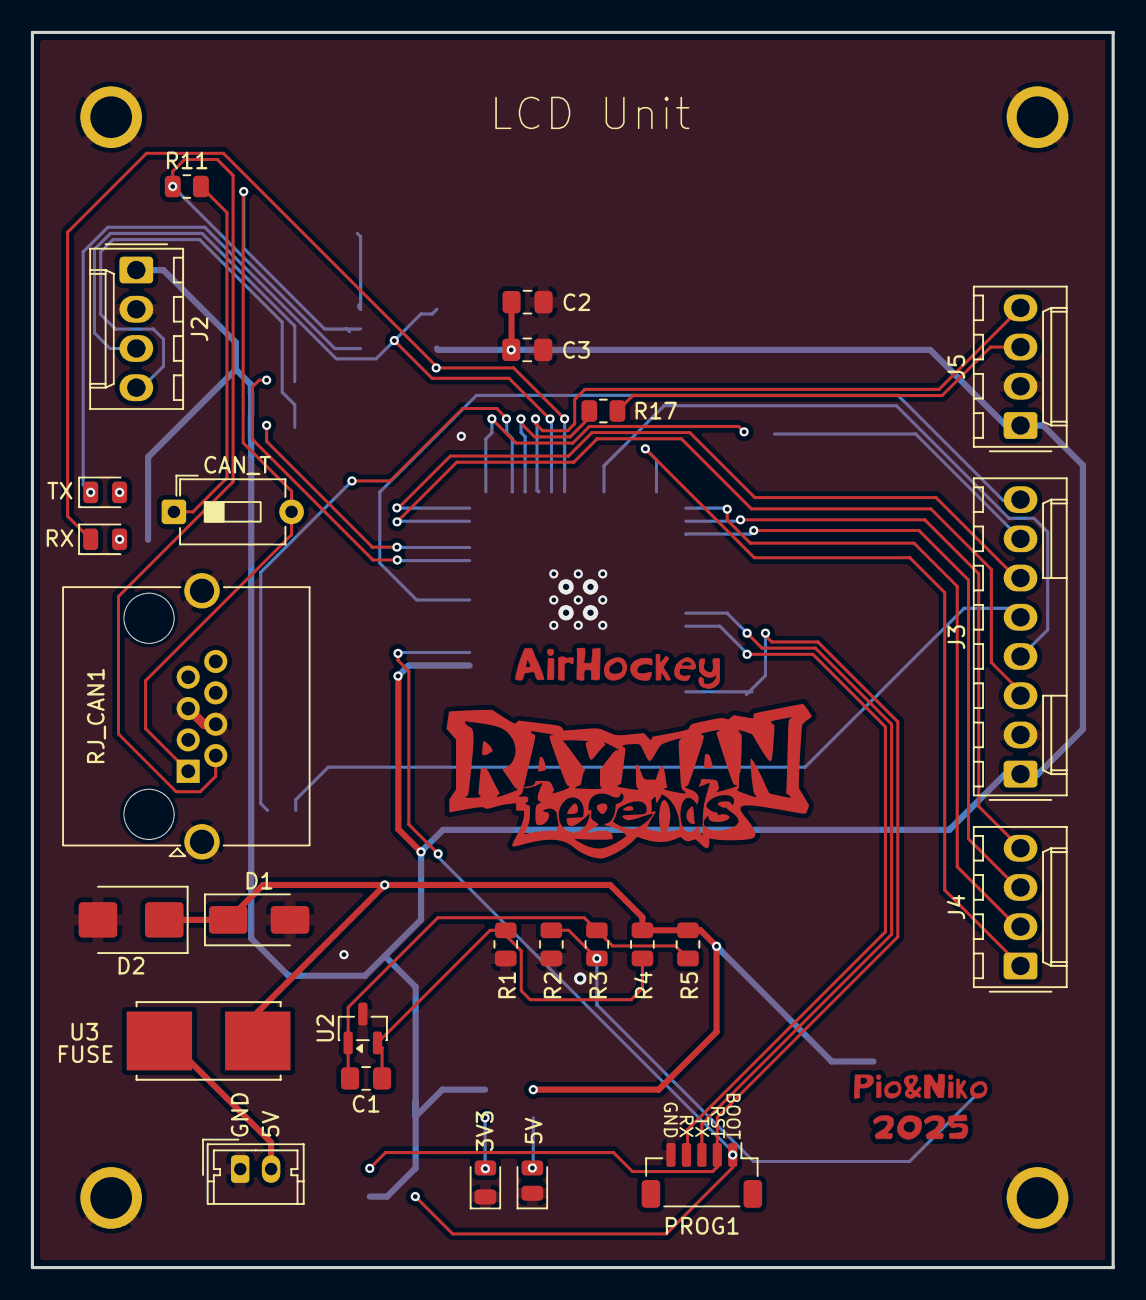
[picture p72: board rayman_LCD.kicad_pcb from above]

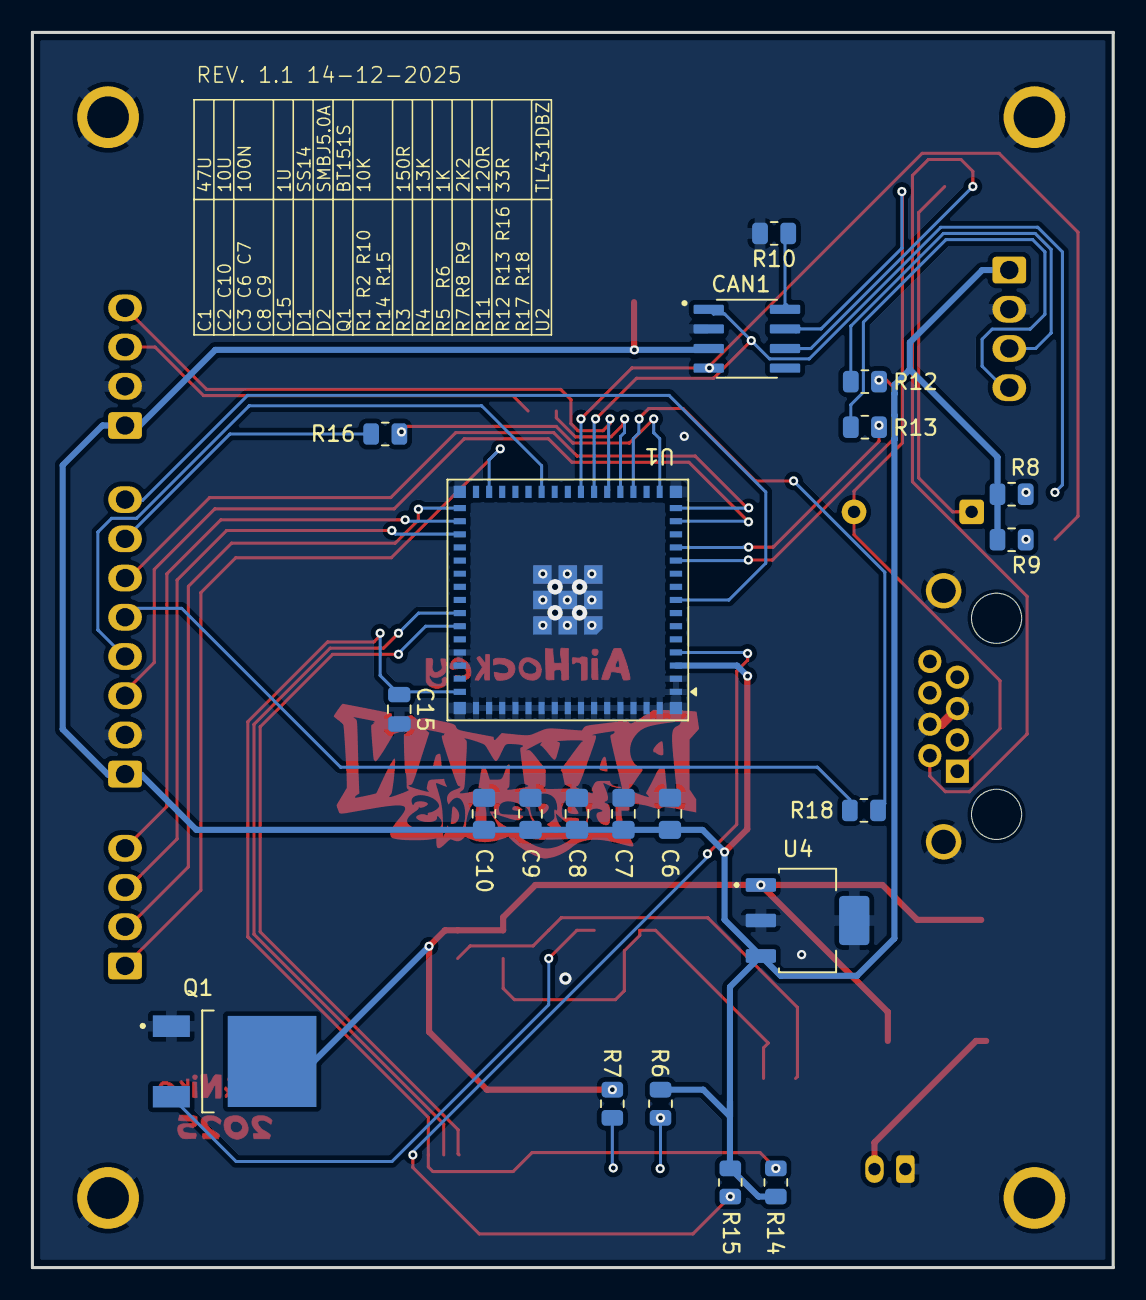
[picture p73: board rayman_LCD.kicad_pcb from below]

Board: 2 copper layers, 70.0 x 80.0 mm, 47 parts (21 on the bottom side), 40 nets.

Parts:
C1: 47uF; C_0805_2012Metric_Pad1.18x1.45mm_HandSolder
C2, C10: 10uF; C_0805_2012Metric_Pad1.18x1.45mm_HandSolder
C3, C6, C7, C8, C9: 100nF; C_0805_2012Metric_Pad1.18x1.45mm_HandSolder
C15: 1u; C_0805_2012Metric
CAN1: SN65HVD230D; SOIC127P599X175-8N
D1: D_Schottky; D_SMA
D2: SMBJ5.0A-M3/5B; D_SMB
D3: LED3v3; LED_0805_2012Metric
D4: led5v; LED_0805_2012Metric
D5: CAN_TX; LED_0805_2012Metric
D6: CAN_RX; LED_0805_2012Metric
J1: Conn_01x02_Pin; Molex_Micro-Latch_53253-0270_1x02_P2.00mm_Vertical
J2, J4, J5: Conn_01x04_Pin; Molex_KK-254_AE-6410-04A_1x04_P2.54mm_Vertical
J3: Conn_01x08_Pin; Molex_KK-254_AE-6410-08A_1x08_P2.54mm_Vertical
PROG1: Conn_01x05_Pin; JST_SH_BM05B-SRSS-TB_1x05-1MP_P1.00mm_Vertical
Q1: BT151S-650R; IC_BT136S-600E_118
R1, R2, R10, R14, R15: 10kΩ; R_0805_2012Metric
R3: 150R; R_0805_2012Metric
R4: 13kΩ; R_0805_2012Metric
R5: 1kΩ; R_0805_2012Metric
R6: 1k; R_0805_2012Metric
R7, R8, R9: 2k2; R_0805_2012Metric
R11: 120Ω; R_0805_2012Metric
R12, R13, R16, R17, R18: 33R; R_0805_2012Metric
RJ_CAN1: RJ45; RJ45_Amphenol_RJHSE5380
SW1: SW_DIP_x01; SW_DIP_SPSTx01_Slide_6.7x4.1mm_W7.62mm_P2.54mm_LowProfile
U1: ESP32-S3-MINI-1U; ESP32-S2-MINI-1U
U2: TL431DBZ; SOT-23
U3: 1808 SMD FUSEHOLDER; FUSE_1808
U4: MCP1826S-3302E/DB; MCP1826S-5002EDB

Connections:
+3V3: C2.1, C3.1, C6.1, C7.1, C8.1, C9.1, C10.1, CAN1.3 (VCC), J2.1 (VCC), J3.1 (vdd), J5.1 (VCC), R6.2, R8.1, R9.1, R14.1, R15.2, U1.3 (3V3), U4.3 (VOUT)
+5V: D1.1 (K), D2.1 (K), Q1.2 (A), R4.2, R5.2, R7.1, U3.1, U4.1 (VIN)
/CAN/RX: CAN1.4 (R), D6.1 (K), U1.22 (IO18)
/CAN/TX: CAN1.1 (D), D5.1 (K), U1.21 (IO17)
/Power/+5VDC: J1.2, U3.2
GND: C2.2, C3.2, C6.2, C7.2, C8.2, C9.2, C10.2, C15.2, CAN1.2 (GND), D1.2 (A), D2.2 (A), D3.1 (K), D4.1 (K), J1.1, J2.2 (GND), J3.2 (gnd), J5.2 (GND), PROG1.5, Q1.1 (K), R1.1, R2.1, R10.2, RJ_CAN1.4, RJ_CAN1.5, RJ_CAN1.SH, U1.1 (GND), U1.2 (GND), U1.42 (GND), U1.43 (GND), U1.46 (GND), U1.47 (GND), U1.48 (GND), U1.49 (GND), U1.50 (GND), U1.51 (GND), U1.52 (GND), U1.53 (GND), U1.54 (GND), U1.55 (GND), U1.56 (GND), U1.57 (GND), U1.58 (GND), U1.59 (GND), U1.60 (GND), U1.61 (GND), U1.62 (GND), U1.63 (GND), U1.64 (GND), U1.65 (GND), U2.3 (A), U4.2 (GND), U4.4 (GND)
unnamed: CAN1.7 (CANH), RJ_CAN1.1, SW1.2
unnamed: CAN1.6 (CANL), R11.1, RJ_CAN1.2
unnamed: CAN1.8 (RS), R10.1
unnamed: D3.2 (A), R6.1
unnamed: D4.2 (A), R7.2
unnamed: D5.2 (A), R8.2
unnamed: D6.2 (A), R9.2
unnamed: J2.3 (SCK), R12.1
unnamed: J2.4 (SDK), R13.1
unnamed: J3.8 (bl), U1.8 (IO4)
unnamed: J3.3 (cs), U1.14 (IO10)
unnamed: J3.5 (d/c), R18.1
unnamed: J3.4 (rst), U1.25 (IO21)
unnamed: J3.7 (sck), R16.1
unnamed: J3.6 (sdi), U1.15 (IO11)
unnamed: J4.4 (clk), U1.32 (IO36)
unnamed: J4.1 (scs), U1.29 (IO34)
unnamed: J4.2 (sdi), U1.31 (IO35)
unnamed: J4.3 (sdo), U1.33 (IO37)
unnamed: J5.3 (SCK), R17.1
unnamed: J5.4 (SDK), U1.20 (IO16)
unnamed: Q1.3 (G), R2.2, R3.1
unnamed: R11.2, SW1.1
unnamed: R12.2, U1.11 (IO7)
unnamed: R13.2, U1.12 (IO8)
unnamed: R16.2, U1.16 (IO12)
unnamed: R18.2, U1.18 (IO14)
unnamed: R17.2, U1.19 (IO15)
unnamed: C1.2, R3.2, R5.1, U2.1 (K)
unnamed: C1.1, R1.2, R4.1, U2.2 (REF)
en: C15.1, PROG1.2, R14.2, U1.45 (EN)
io0: PROG1.1, R15.1, U1.4 (IO0)
rxd0: PROG1.4, U1.40 (RXD0)
txd0: PROG1.3, U1.39 (TXD0)
