pioter1234567/airhockey/electronics/settings-unit/nowe_ust.kicad_pcb

## KiCad design electronics/settings-unit/nowe_ust.kicad_pcb (2026-03-13)

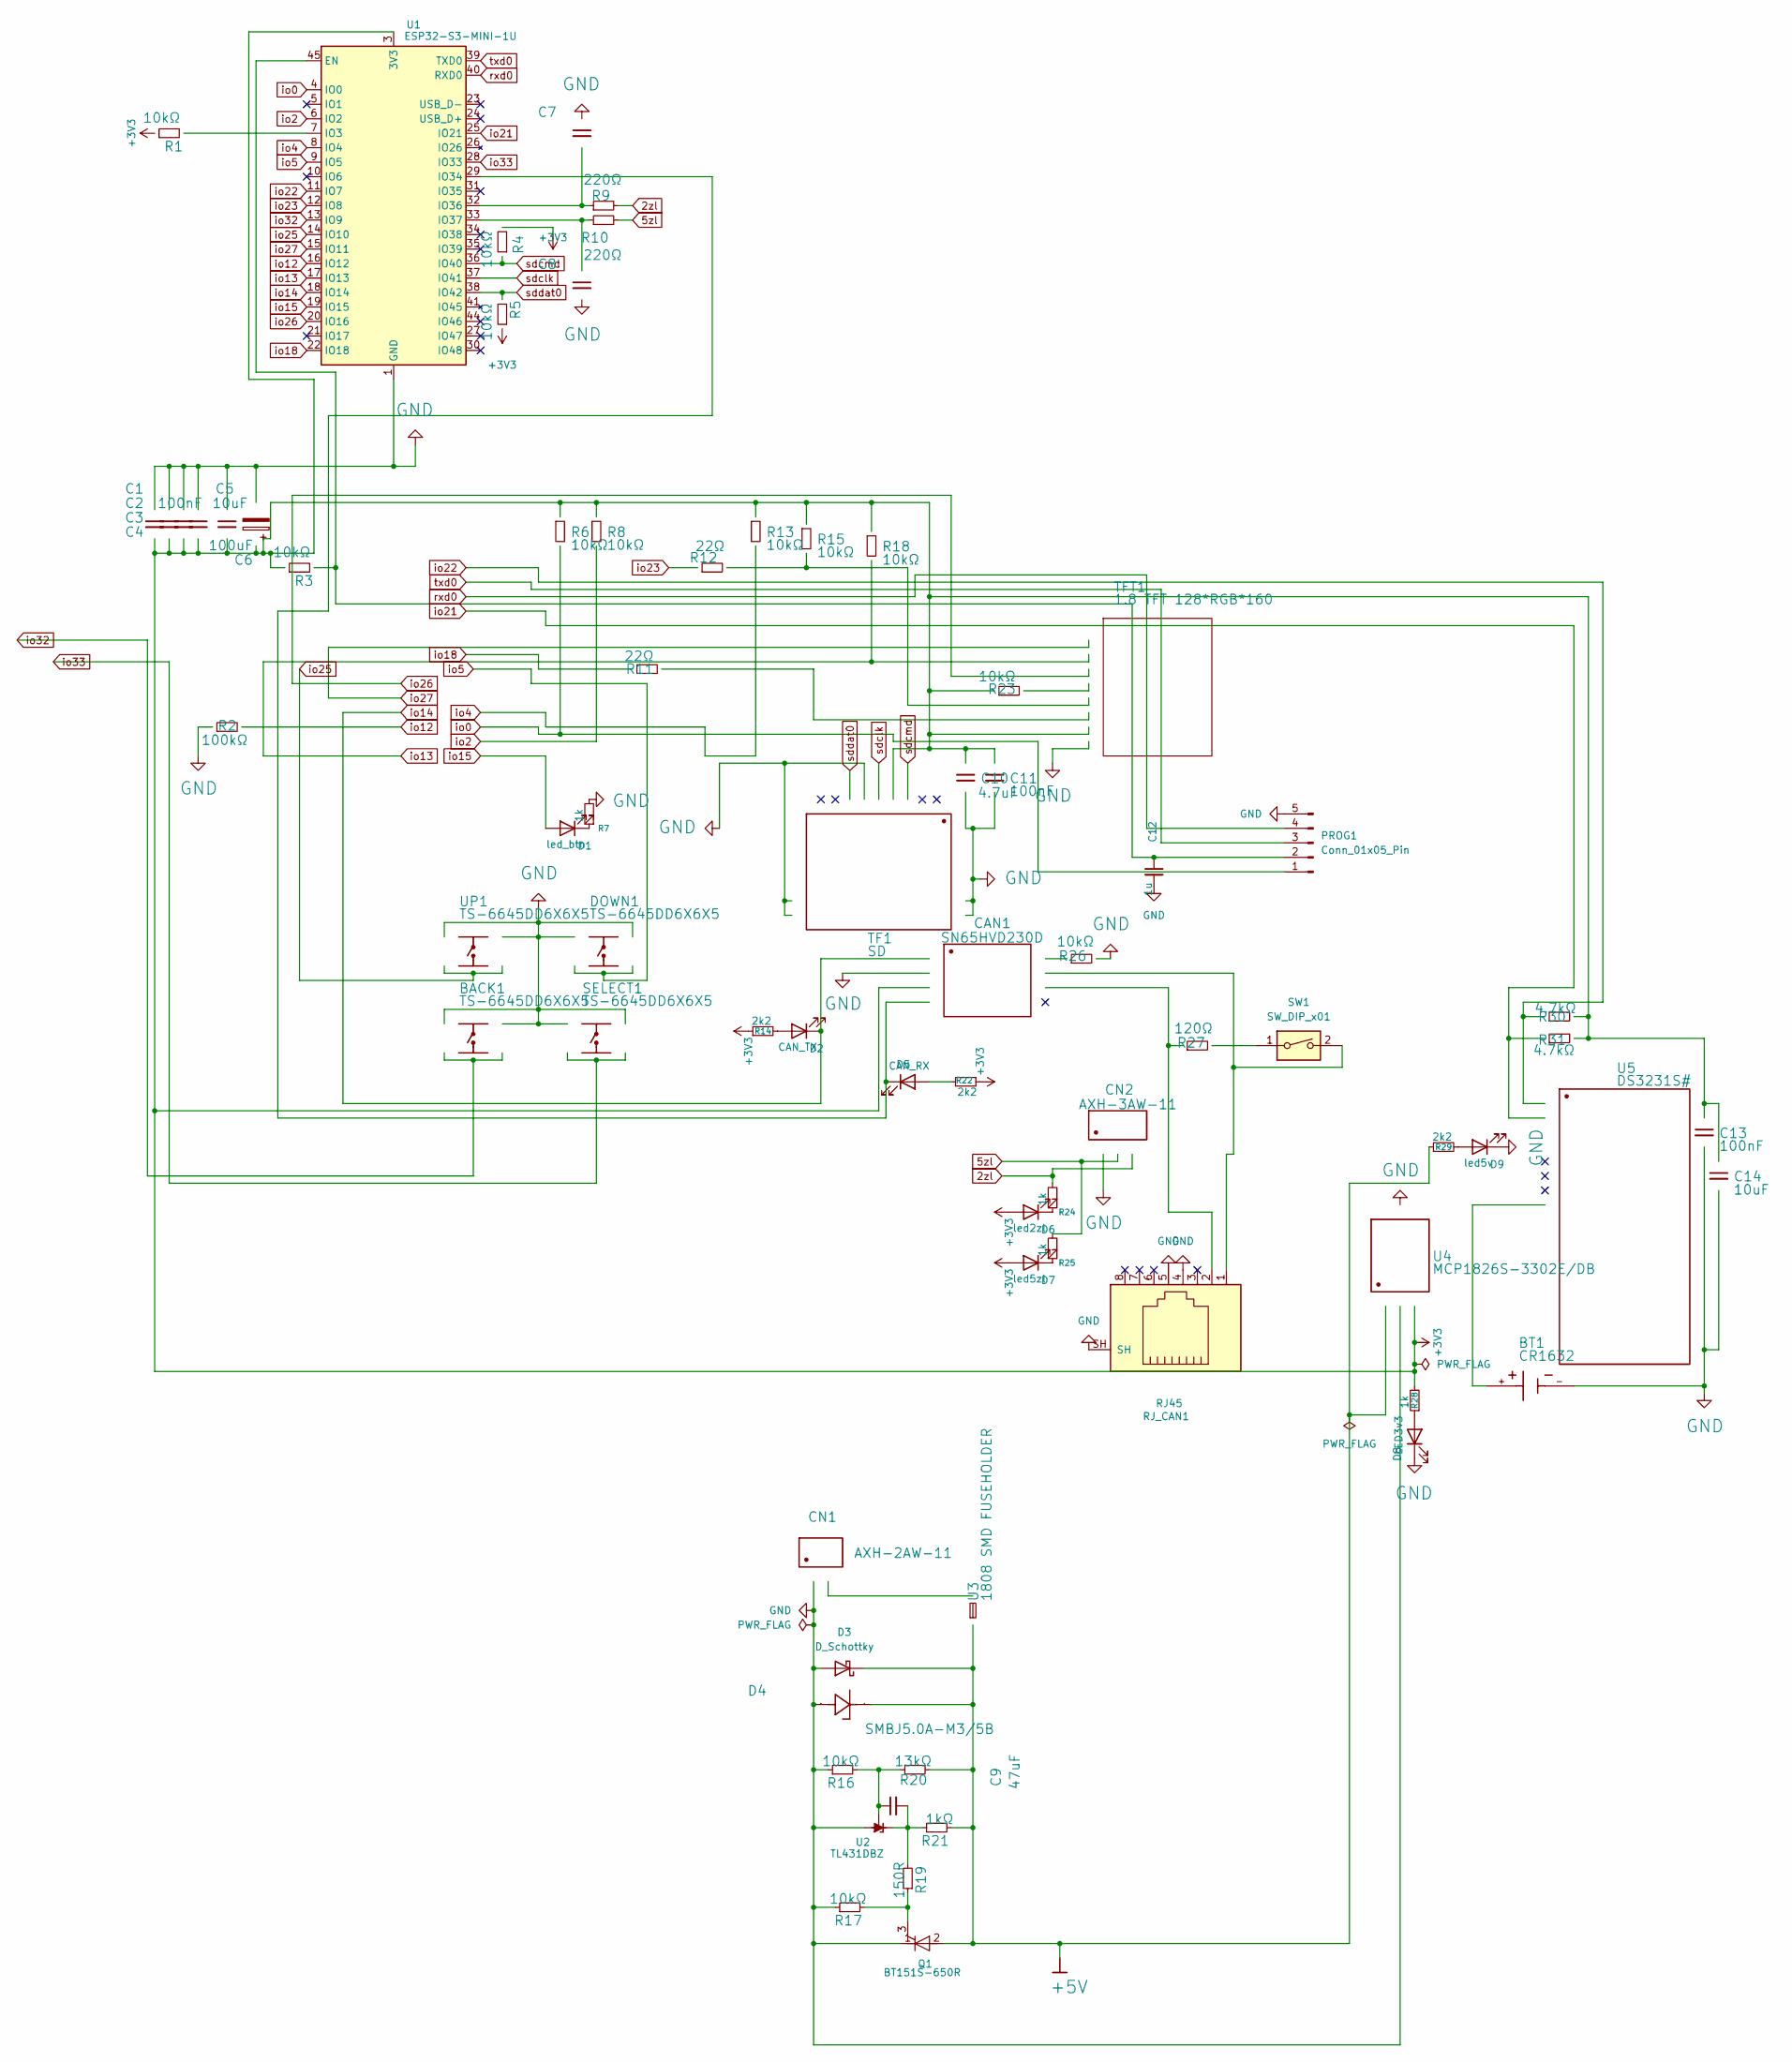
[picture p74: schematic nowe_ust.kicad_sch]

Parts:
BACK1: TS-6645DD6X6X5; SW_PUSH_6mm_H13mm; Manufacturer Part TS-6645DD6x6x5
BT1: CR1632; BAT_BU1632SM-JJ-GTR; Manufacturer Part XDBS-CR2032-9
C1, C2, C3, C4, C7, C8, C11, C13: 100nF; C_0805_2012Metric_Pad1.18x1.45mm_HandSolder; Manufacturer Part 0805B104K160CT-C
C5: 10uF; C_0805_2012Metric_Pad1.18x1.45mm_HandSolder; Manufacturer Part 0805ZD106KAT2A
C6: 100uF; CP_Elec_5x5.3; Manufacturer Part RVT100UF10V67RV0036
C9: 47uF; C_0805_2012Metric_Pad1.18x1.45mm_HandSolder; Manufacturer Part CGA0805X7R106K100MT
C10: 4.7uF; C_0805_2012Metric_Pad1.18x1.45mm_HandSolder; Manufacturer Part TCC0805X5R475M500FT
C12: 1u; C_0805_2012Metric
C14: 10uF; C_0805_2012Metric_Pad1.18x1.45mm_HandSolder; Manufacturer Part CGA0805X7R106K100MT
CAN1: SN65HVD230D; SOIC127P599X175-8N; Manufacturer Part SN65HVD230D
CN1: AXH-2AW-11; JST_XH_S2B-XH-A-1_1x02_P2.50mm_Horizontal; Manufacturer Part AXH-2AW-11
CN2: AXH-3AW-11; JST_PH_S3B-PH-K_1x03_P2.00mm_Horizontal; Manufacturer Part AXH-3AW-11
D1: led_btn; LED_0805_2012Metric
D2: CAN_TX; LED_0805_2012Metric
D3: D_Schottky; D_SMA
D4: SMBJ5.0A-M3/5B; D_SMB; Manufacturer Part SMBJ5.0A-M3/5B
D5: CAN_RX; LED_0805_2012Metric
D6: led2zl; LED_0805_2012Metric
D7: led5zl; LED_0805_2012Metric
D8: LED3v3; LED_0805_2012Metric
D9: led5v; LED_0805_2012Metric
DOWN1: TS-6645DD6X6X5; SW_PUSH_6mm_H13mm; Manufacturer Part TS-6645DD6x6x5
PROG1: Conn_01x05_Pin; JST_SH_BM05B-SRSS-TB_1x05-1MP_P1.00mm_Vertical
Q1: BT151S-650R; IC_BT136S-600E_118
R1, R3, R4, R5, R6, R8, R13, R15, R18: 10kΩ; R_0805_2012Metric; Manufacturer Part RCC080510K0FKEA
R2: 100kΩ; R_0805_2012Metric; Manufacturer Part APC0603B100KN
R7, R24, R25, R28: 1k; R_0805_2012Metric
R9, R10: 220Ω; R_0805_2012Metric; Manufacturer Part SC0805F22R0F4ANRH
R11, R12: 22Ω; R_0805_2012Metric; Manufacturer Part SC0805F22R0F4ANRH
R14, R22, R29: 2k2; R_0805_2012Metric
R16, R17: 10kΩ; R_0805_2012Metric; Manufacturer Part RMC08054.7K1%N
R19: 150R; R_0805_2012Metric; Manufacturer Part RMC08054.7K1%N
R20: 13kΩ; R_0805_2012Metric; Manufacturer Part RMC08054.7K1%N
R21: 1kΩ; R_0805_2012Metric; Manufacturer Part RMC08054.7K1%N
R23, R26: 10kΩ; R_0805_2012Metric; Manufacturer Part RT0603LRA0710KL
R27: 120Ω; R_0805_2012Metric; Manufacturer Part 0603SAJ0121T5E
R30, R31: 4.7kΩ; R_0805_2012Metric; Manufacturer Part RMC08054.7K1%N
RJ_CAN1: RJ45; RJ45_Amphenol_RJHSE5380
SELECT1: TS-6645DD6X6X5; SW_PUSH_6mm_H13mm; Manufacturer Part TS-6645DD6x6x5
SW1: SW_DIP_x01; SW_DIP_SPSTx01_Slide_6.7x4.1mm_W7.62mm_P2.54mm_LowProfile
TF1: SD; CUI_MSD-4-A; Manufacturer Part SD
TFT1: 1.8 TFT 128*RGB*160; TFT 1.8 No card No touch; Manufacturer Part 1.8 TFT 128*RGB*160
U1: ESP32-S3-MINI-1U; ESP32-S2-MINI-1U
U2: TL431DBZ; SOT-23
U3: 1808 SMD FUSEHOLDER; FUSE_1808; Manufacturer Part 1808 SMD Fuseholder
U4: MCP1826S-3302E/DB; MCP1826S-5002EDB; Manufacturer Part MCP1826S-3302E/DB
U5: DS3231S#; DS3231SN; Manufacturer Part DS3231S#
UP1: TS-6645DD6X6X5; SW_PUSH_6mm_H13mm; Manufacturer Part TS-6645DD6x6x5

Connections:
2zl: CN2.3 (2ZL), R9.2, R24.2
5zl: CN2.2 (5ZL), R10.2, R25.2
+3V3: C1.2, C2.2, C3.2, C4.2, C5.2, C6.1, C10.1, C11.1, C13.1, C14.1, CAN1.3 (VCC), D6.2 (A), D7.2 (A), R1.1, R3.1, R4.2, R5.1, R6.1, R8.1, R13.1, R14.1, R15.1, R18.1, R22.1, R23.1, R28.2, R30.2, R31.2, TF1.4 (VDD), TFT1.2 (VCC), U1.3 (3V3), U4.3 (VOUT), U5.2 (VCC)
+5V: D3.1 (K), D4.2 (K), Q1.2 (A), R20.2, R21.2, R29.1, U3.1, U4.1 (VIN)
unnamed: CAN1.7 (CANH), RJ_CAN1.1, SW1.2
unnamed: CAN1.6 (CANL), R27.1, RJ_CAN1.2
unnamed: CAN1.4 (R), D5.1 (K), U1.29 (IO34)
unnamed: CAN1.8 (RS), R26.1
unnamed: CN1.2 (5V), U3.2
unnamed: D1.1 (K), R7.1
unnamed: D2.2 (A), R14.2
unnamed: D5.2 (A), R22.2
unnamed: D6.1 (K), R24.1
unnamed: D7.1 (K), R25.1
unnamed: D8.2 (A), R28.1
unnamed: D9.2 (A), R29.2
unnamed: C12.1, PROG1.2, R3.2, U1.45 (EN)
unnamed: Q1.3 (G), R17.2, R19.1
unnamed: R27.2, SW1.1
unnamed: R23.2, TFT1.5 (RES)
unnamed: R11.2, TFT1.3 (SCK)
unnamed: R12.2, R15.2, TFT1.4 (SDA)
unnamed: R1.2, U1.7 (IO3)
unnamed: C7.2, R9.1, U1.32 (IO36)
unnamed: C8.1, R10.1, U1.33 (IO37)
unnamed: C9.2, R19.2, R21.1, U2.1 (K)
unnamed: C9.1, R16.2, R20.1, U2.2 (REF)
unnamed: BT1.+, U5.14 (VBAT)
io0: PROG1.1, R6.2, U1.4 (IO0)
io2: R8.2, U1.6 (IO2)
io4: R13.2, U1.8 (IO4)
io5: DOWN1.2 (3), U1.9 (IO5)
io12: R2.2, U1.16 (IO12)
io13: R18.2, TFT1.7 (CS), U1.17 (IO13)
io14: CAN1.1 (D), D2.1 (K), U1.18 (IO14)
io15: D1.2 (A), U1.19 (IO15)
io18: R11.1, U1.22 (IO18)
io21: R31.1, U1.25 (IO21), U5.15 (SDA)
io22: R30.1, U1.11 (IO7), U5.16 (SCL)
io23: R12.1, U1.12 (IO8)
io25: U1.14 (IO10), UP1.2 (3)
io26: TFT1.6 (DC), U1.20 (IO16)
io27: TFT1.8 (BL), U1.15 (IO11)
io32: BACK1.2 (3), U1.13 (IO9)
io33: SELECT1.2 (3), U1.28 (IO33)
rxd0: PROG1.4, U1.40 (RXD0)
sdclk: TF1.5 (CLK), U1.37 (IO41)
sdcmd: R4.1, TF1.3 (CMD), U1.36 (IO40)
sddat0: R5.2, TF1.7 (DAT0), U1.38 (IO42)
txd0: PROG1.3, U1.39 (TXD0)

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
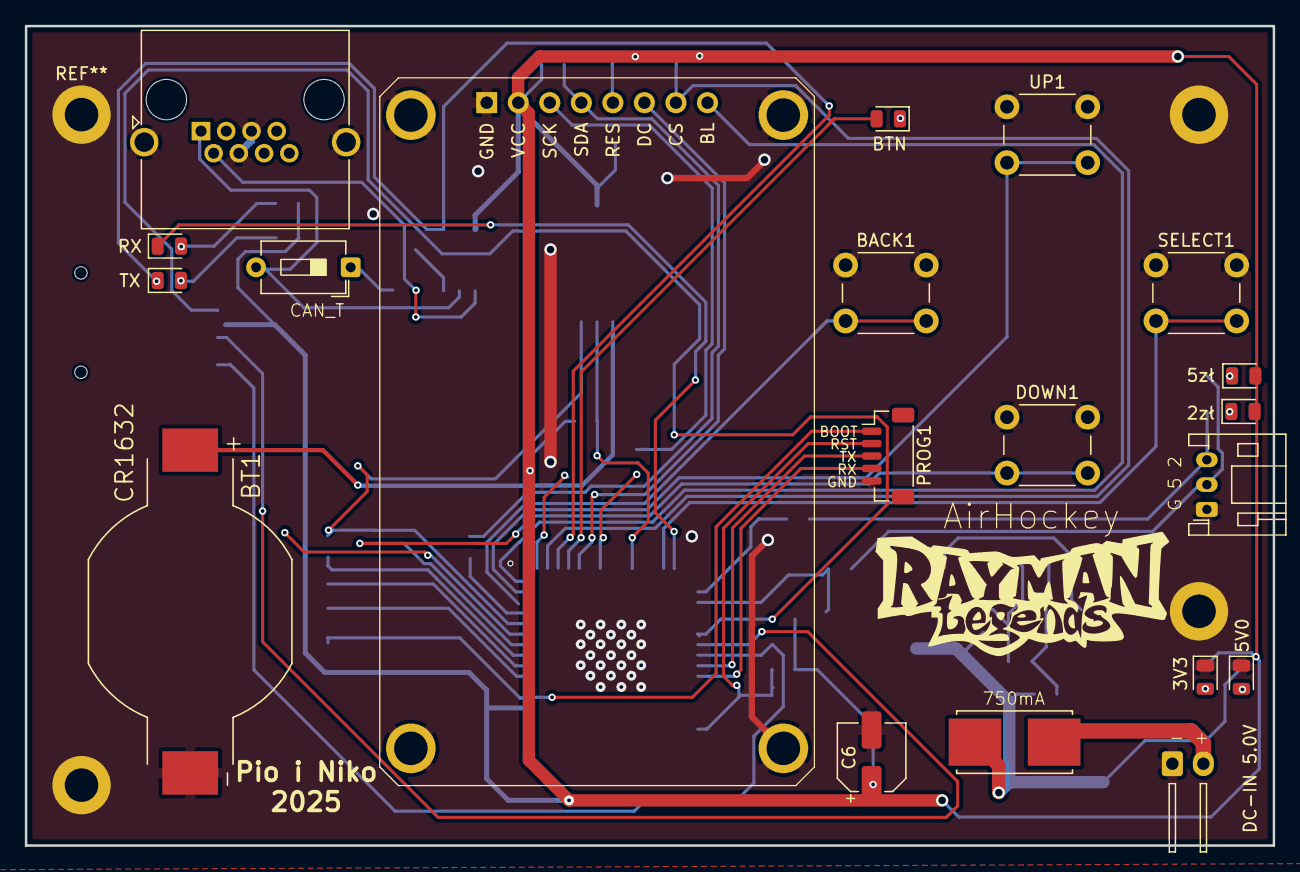
[picture p75: board nowe_ust.kicad_pcb from above]

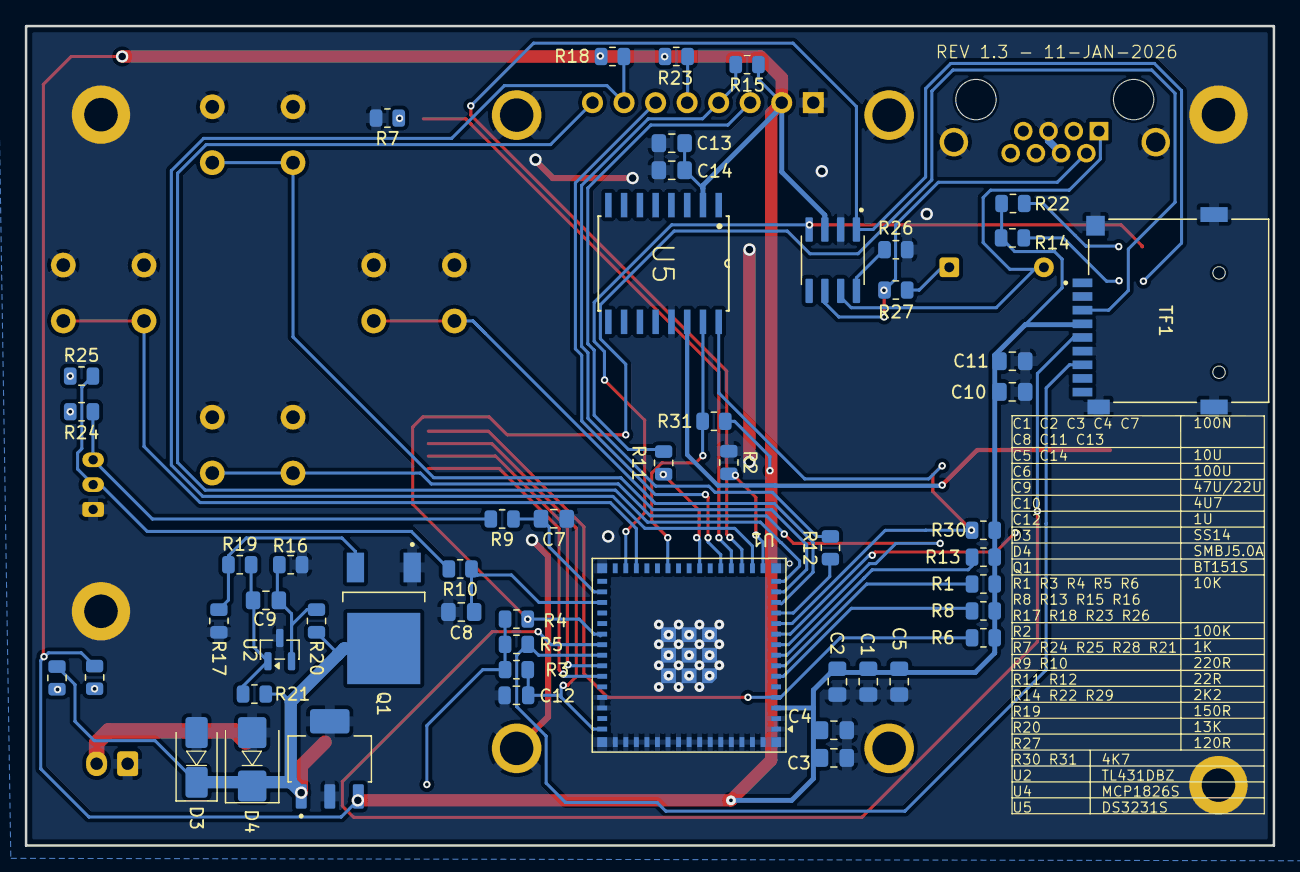
[picture p76: board nowe_ust.kicad_pcb from below]

Board: 2 copper layers, 100.5 x 66.0 mm, 73 parts (53 on the bottom side), 51 nets.
