pioter1234567/airhockey/electronics/lcd-unit-STM32-176/lcd_176/lcd_176.ioc

Mcu.UserName=STM32H743IITx
PA1.Signal=LTDC_R2
PA10.Signal=LTDC_B1
PA11.Signal=FDCAN1_RX
PA12.Signal=FDCAN1_TX
PA2.Signal=LTDC_R1
PA3.Signal=LTDC_B2
PA5.Signal=LTDC_R4
PA6.Signal=LTDC_G2
PA7.Signal=S_TIM14_CH1
PA8.Signal=LTDC_B3
PB0.Signal=LTDC_R3
PB1.Signal=LTDC_R6
PB10.Signal=I2C2_SCL
PB11.Signal=LTDC_G5
PB6.Signal=I2C1_SCL
PB7.Signal=I2C1_SDA
PB8.Signal=LTDC_B6
PB9.Signal=LTDC_B7
PC0.Signal=FMC_SDNWE
PC10.Signal=SDMMC1_D2
PC11.Signal=SDMMC1_D3
PC12.Signal=SDMMC1_CK
PC2_C.Signal=FMC_SDNE0
PC3_C.Signal=FMC_SDCKE0
PC8.Signal=SDMMC1_D0
PC9.Signal=SDMMC1_D1
PD0.Signal=FMC_D2_DA2
PD1.Signal=FMC_D3_DA3
PD10.Signal=FMC_D15_DA15
PD14.Signal=FMC_D0_DA0
PD15.Signal=FMC_D1_DA1
PD2.Signal=SDMMC1_CMD
PD8.Signal=FMC_D13_DA13
PD9.Signal=FMC_D14_DA14
PE0.Signal=FMC_NBL0
PE1.Signal=FMC_NBL1
PE10.Signal=FMC_D7_DA7
PE11.Signal=FMC_D8_DA8
PE12.Signal=FMC_D9_DA9
PE13.Signal=FMC_D10_DA10
PE14.Signal=FMC_D11_DA11
PE15.Signal=FMC_D12_DA12
PE4.Signal=LTDC_B0
PE5.Signal=LTDC_G0
PE6.Signal=LTDC_G1
PE7.Signal=FMC_D4_DA4
PE8.Signal=FMC_D5_DA5
PE9.Signal=FMC_D6_DA6
PF0.Signal=FMC_A0
PF1.Signal=FMC_A1
PF10.Signal=LTDC_DE
PF11.Signal=FMC_SDNRAS
PF12.Signal=FMC_A6
PF13.Signal=FMC_A7
PF14.Signal=FMC_A8
PF15.Signal=FMC_A9
PF2.Signal=FMC_A2
PF3.Signal=FMC_A3
PF4.Signal=FMC_A4
PF5.Signal=FMC_A5
PF6.GPIO_Label=lcd_on_high
PF6.Signal=GPIO_Output
PG0.Signal=FMC_A10
PG1.Signal=FMC_A11
PG12.Signal=LTDC_B4
PG15.Signal=FMC_SDNCAS
PG4.Signal=FMC_A14_BA0
PG5.Signal=FMC_A15_BA1
PG6.Signal=LTDC_R7
PG7.Signal=LTDC_CLK
PG8.Signal=FMC_SDCLK
PH11.Signal=LTDC_R5
PH14.Signal=LTDC_G3
PH2.Signal=LTDC_R0
PH4.Signal=LTDC_G4
PH5.Signal=I2C2_SDA
PI10.Signal=LTDC_HSYNC
PI11.Signal=LTDC_G6
PI2.Signal=LTDC_G7
PI5.Signal=LTDC_B5
PI9.Signal=LTDC_VSYNC
