pioter1234567/airhockey/firmware/main-unit/src/table_lights.cpp

#include "table_lights.h"

#include <Arduino.h>
#include <FastLED.h>
#include <SD.h>

// =====================================================
// HARDWARE
// =====================================================

// GPIO12 jest zajęte przez główną matrycę.
// GPIO13 dajemy na pasek ambiente pod stołem.
// GPIO11 zostawiamy pod bramki.
#define AMBIENT_DATA_PIN 13
#define AMBIENT_LED_COUNT 192

#define GOAL_DATA_PIN 11
#define GOAL_LED_COUNT 22 

// =====================================================
// BIN PARAMS
// =====================================================

#define TABLE_BIN_FPS 20
#define TABLE_BIN_FRAME_MS (1000 / TABLE_BIN_FPS)

#define AMBIENT_FRAME_SIZE (AMBIENT_LED_COUNT * 3)

static CRGB ambientLeds[AMBIENT_LED_COUNT];

#if GOAL_LED_COUNT > 0
static CRGB goalLeds[GOAL_LED_COUNT];
#endif

// =====================================================
// MUSIC BIN STATE
// =====================================================

static File ambientFile;
static bool ambientPlaying = false;
static const char *ambientPath = nullptr;

static uint32_t ambientFrameCount = 0;
static uint32_t ambientLastFrame = UINT32_MAX;
static uint32_t ambientStartMs = 0;

static uint8_t ambientBuf[AMBIENT_FRAME_SIZE];



// =====================================================
// ROUND AMBIENT STATE
// =====================================================

static bool ambientRoundEnabled = false;
static bool ambientBreathing = false;
static CRGB ambientRoundColor = CRGB::Black;
static uint32_t ambientLastSolidFrame = 0;


// =====================================================
// GOAL FX STATE
// =====================================================

static bool goalFxActive = false;
static uint8_t goalFxSide = 0;       // 0 = A, 1 = B
static uint32_t goalFxStartMs = 0;
static uint32_t goalFxDurationMs = 800;
static uint32_t goalFxLastFrameMs = 0;

// =====================================================
// GOAL LIGHTS STATE
// =====================================================

static bool goalsEnabled = false;
static CRGB goalsBaseColor = CRGB::Black;

// =====================================================
// HELPERS
// =====================================================

static bool readExact(File &file, uint8_t *dst, size_t n)
{
  size_t got = 0;

  while (got < n)
  {
    int r = file.read(dst + got, n - got);

    if (r <= 0)
      return false;

    got += (size_t)r;
  }

  return true;
}

static void ambientClear()
{
  fill_solid(ambientLeds, AMBIENT_LED_COUNT, CRGB::Black);
}


static bool isAmbientLeftHalf(uint16_t i)
{
  // Pasek:
  // 0..63    = góra, lewo -> prawo
  // 64..95   = prawa strona, góra -> dół
  // 96..159  = dół, prawo -> lewo
  // 160..191 = lewa strona, dół -> góra

  // Góra lewa połowa
  if (i >= 0 && i <= 31)
    return true;

  // Dół lewa połowa
  if (i >= 128 && i <= 159)
    return true;

  // Lewy bok
  if (i >= 160 && i <= 191)
    return true;

  return false;
}

#if GOAL_LED_COUNT > 0
static void goalsRenderBase();
static void goalsRenderGoalFx(uint8_t scoringSide, uint8_t power);
#endif

static void renderGoalFx(uint32_t nowMs)
{
  if (!goalFxActive)
    return;

  uint32_t dt = nowMs - goalFxStartMs;

if (dt >= goalFxDurationMs)
{
  goalFxActive = false;

#if GOAL_LED_COUNT > 0
  goalsRenderBase();
#endif

  return;
}

  // Limit klatek, żeby nie mielić bez sensu.
  if (nowMs - goalFxLastFrameMs < 25)
    return;

  goalFxLastFrameMs = nowMs;

  // Delikatny flash/puls na początku gola.
  // 255 -> 120 w czasie efektu.
  uint8_t power = 255;
  if (goalFxDurationMs > 0)
  {
    power = 120 + (uint8_t)((goalFxDurationMs - dt) * 135UL / goalFxDurationMs);
  }

  CRGB green = CRGB(0, power, 0);
  CRGB red   = CRGB(power, 0, 0);

  for (uint16_t i = 0; i < AMBIENT_LED_COUNT; i++)
  {
    bool left = isAmbientLeftHalf(i);

    // scoringSide 0:
    // lewa połowa zielona, prawa czerwona
    //
    // scoringSide 1:
    // prawa połowa zielona, lewa czerwona
    bool winnerHalf = (goalFxSide == 0) ? left : !left;

    CRGB c = winnerHalf ? green : red;

    // Tak jak reszta ambiente: swap R/G.
    ambientLeds[i] = CRGB(c.g, c.r, c.b);
  }
  #if GOAL_LED_COUNT > 0
  goalsRenderGoalFx(goalFxSide, power);
#endif
}

static void renderAmbientRound(uint32_t nowMs)
{
  // limit ~40 FPS, tak jak matryca
  if (nowMs - ambientLastSolidFrame < 25)
    return;

  ambientLastSolidFrame = nowMs;

  float scale = 1.0f;

  if (ambientBreathing)
  {
    float t = (nowMs % 2600) / 2600.0f;
    scale = 0.35f + 0.65f * (0.5f - 0.5f * cosf(t * 2.0f * PI));
  }

  CRGB c = ambientRoundColor;
  c.nscale8_video((uint8_t)(scale * 255.0f));

  // Tak samo jak przy BIN-ach ambiente: swap R/G
  fill_solid(ambientLeds, AMBIENT_LED_COUNT, CRGB(c.g, c.r, c.b));
}

#if GOAL_LED_COUNT > 0
static void goalsClear()
{
  fill_solid(goalLeds, GOAL_LED_COUNT, CRGB::Black);
}
#endif

#if GOAL_LED_COUNT > 0

static inline CRGB fixGoalColor(uint8_t r, uint8_t g, uint8_t b)
{
  // Tak samo jak reszta Twoich LED-ów: swap R/G.
  return CRGB(g, r, b);
}

static void goalsRenderBase()
{
  if (!goalsEnabled)
  {
    fill_solid(goalLeds, GOAL_LED_COUNT, CRGB::Black);
    return;
  }

  fill_solid(goalLeds, GOAL_LED_COUNT, fixGoalColor(
    goalsBaseColor.r,
    goalsBaseColor.g,
    goalsBaseColor.b
  ));
}

static void goalsRenderGoalFx(uint8_t scoringSide, uint8_t power)
{
  const uint16_t half = GOAL_LED_COUNT / 2;

  CRGB green = fixGoalColor(0, power, 0);
  CRGB red   = fixGoalColor(power, 0, 0);

  for (uint16_t i = 0; i < GOAL_LED_COUNT; i++)
  {
    bool isGoalA = (i < half);

    // scoringSide 0 = A zdobywa punkt:
    // bramka A zielona, bramka B czerwona
    //
    // scoringSide 1 = B zdobywa punkt:
    // bramka B zielona, bramka A czerwona
    bool winnerGoal = (scoringSide == 0) ? isGoalA : !isGoalA;

    goalLeds[i] = winnerGoal ? green : red;
  }
}

#endif

// =====================================================
// PUBLIC API
// =====================================================

void tableLightsInit(uint8_t brightness)
{
  // Uwaga: FastLED brightness jest globalne.
  // Nie ustawiamy tu FastLED.setBrightness(), żeby nie mieszać jasności matrycy.
  FastLED.addLeds<WS2812B, AMBIENT_DATA_PIN, GRB>(ambientLeds, AMBIENT_LED_COUNT);

#if GOAL_LED_COUNT > 0
  FastLED.addLeds<WS2812B, GOAL_DATA_PIN, GRB>(goalLeds, GOAL_LED_COUNT);
#endif

  ambientClear();

#if GOAL_LED_COUNT > 0
  goalsClear();
#endif

  FastLED.show();

  Serial.printf("[TABLE] init ambient pin=%u leds=%u\n",
                (unsigned)AMBIENT_DATA_PIN,
                (unsigned)AMBIENT_LED_COUNT);

#if GOAL_LED_COUNT > 0
  Serial.printf("[TABLE] init goals pin=%u leds=%u\n",
                (unsigned)GOAL_DATA_PIN,
                (unsigned)GOAL_LED_COUNT);
#endif
}

void tableLightsAllOff()
{
  tableLightsMusicStop();

  ambientClear();

  goalsEnabled = false;
  goalsBaseColor = CRGB::Black;

#if GOAL_LED_COUNT > 0
  goalsClear();
#endif
}

void tableLightsMusicStart(const char *path, uint32_t syncStartMs)
{
  tableLightsMusicStop();

  if (!path)
  {
    ambientClear();
    Serial.println("[TABLE] ambient music: no file for this theme");
    return;
  }

  ambientPath = path;
  ambientFile = SD.open(ambientPath, FILE_READ);

  if (!ambientFile)
  {
    Serial.printf("[TABLE] ambient open FAIL: %s\n", ambientPath);
    ambientClear();
    return;
  }

  uint32_t size = (uint32_t)ambientFile.size();
  ambientFrameCount = size / AMBIENT_FRAME_SIZE;

  if (ambientFrameCount == 0)
  {
    Serial.printf("[TABLE] ambient empty/too small: %s size=%lu\n",
                  ambientPath,
                  (unsigned long)size);

    ambientFile.close();
    ambientClear();
    return;
  }

  ambientStartMs = syncStartMs;
  ambientLastFrame = UINT32_MAX;
  ambientPlaying = true;

  Serial.printf("[TABLE] ambient music START: %s frames=%lu size=%lu startMs=%lu\n",
                ambientPath,
                (unsigned long)ambientFrameCount,
                (unsigned long)size,
                (unsigned long)ambientStartMs);
}

void tableLightsMusicStop()
{
  if (ambientFile)
    ambientFile.close();

  ambientPlaying = false;
  ambientPath = nullptr;
  ambientFrameCount = 0;
  ambientLastFrame = UINT32_MAX;
}


void tableLightsSetRoundColor(uint8_t r, uint8_t g, uint8_t b)
{
  ambientRoundColor = CRGB(r, g, b);
}

void tableLightsSetBreathing(bool enable)
{
  ambientBreathing = enable;
}

void tableLightsSetRoundEnabled(bool enable)
{
  ambientRoundEnabled = enable;

  if (!enable)
    ambientClear();
}

void tableLightsTick(uint32_t nowMs)
{

    // Efekt gola ma priorytet nad BIN-em i stałym kolorem ambiente.
  // Po zakończeniu goalFxActive wróci do false, a BIN wskoczy w aktualną klatkę,
  // bo liczy czas od ambientStartMs.
  if (goalFxActive)
  {
    renderGoalFx(nowMs);
    return;
  }
  if (!ambientPlaying)
  {
    if (ambientRoundEnabled)
      renderAmbientRound(nowMs);

    return;
  }

  if (!ambientFile || ambientFrameCount == 0)
  {
    if (ambientRoundEnabled)
      renderAmbientRound(nowMs);

    return;
  }

  uint32_t elapsed = nowMs - ambientStartMs;
  uint32_t frameIndex = (elapsed / TABLE_BIN_FRAME_MS) % ambientFrameCount;

  if (frameIndex == ambientLastFrame)
    return;

  uint32_t pos = frameIndex * AMBIENT_FRAME_SIZE;

  if (!ambientFile.seek(pos))
  {
    Serial.printf("[TABLE] ambient seek FAIL frame=%lu pos=%lu\n",
                  (unsigned long)frameIndex,
                  (unsigned long)pos);
    return;
  }

  if (!readExact(ambientFile, ambientBuf, AMBIENT_FRAME_SIZE))
  {
    Serial.printf("[TABLE] ambient read FAIL frame=%lu pos=%lu\n",
                  (unsigned long)frameIndex,
                  (unsigned long)pos);
    return;
  }

  for (uint16_t i = 0; i < AMBIENT_LED_COUNT; i++)
  {
    uint8_t r = ambientBuf[i * 3 + 0];
    uint8_t g = ambientBuf[i * 3 + 1];
    uint8_t b = ambientBuf[i * 3 + 2];

    // Tak samo jak w matrixSetIndex() masz swap R/G.
    // Jeśli kolory będą odwrócone, zmienimy na CRGB(r, g, b).
    ambientLeds[i] = CRGB(g, r, b);
  }

  ambientLastFrame = frameIndex;
}

// =====================================================
// GOALS — na później
// =====================================================

void tableLightsGoalFx(uint8_t scoringSide)
{
  // Zamiana fizycznych stron efektu gola:
  // logiczne A pokazujemy jak B, logiczne B pokazujemy jak A
  goalFxSide = scoringSide ? 0 : 1;

  goalFxStartMs = millis();
  goalFxDurationMs = 800;
  goalFxLastFrameMs = 0;
  goalFxActive = true;

  Serial.printf("[TABLE] goal FX side=%u\n", (unsigned)goalFxSide);
}

void tableLightsSetGoalsEnabled(bool enabled)
{
  goalsEnabled = enabled;

#if GOAL_LED_COUNT > 0
  goalsRenderBase();
#endif

  Serial.printf("[TABLE] goals %s\n", enabled ? "ON" : "OFF");
}

void tableLightsSetGoalsColor(uint8_t r, uint8_t g, uint8_t b)
{
  goalsBaseColor = CRGB(r, g, b);

#if GOAL_LED_COUNT > 0
  goalsRenderBase();
#endif

  Serial.printf("[TABLE] goals color r=%u g=%u b=%u\n",
                (unsigned)r,
                (unsigned)g,
                (unsigned)b);
}
