pioter1234567/airhockey/firmware/lcd-unit/src/Rayman_Origins72pt7b.h

const uint8_t Rayman_Origins72pt7bBitmaps[] PROGMEM = {
  0x00, 0x00, 0x00, 0x00, 0x00, 0x1C, 0x00, 0x00, 0x0F, 0xE0, 0x00, 0x07,
  0xFC, 0x00, 0x03, 0xFF, 0x80, 0x01, 0xFF, 0xF0, 0x00, 0xFF, 0xFE, 0x00,
  0x7F, 0xFF, 0x80, 0x3F, 0xFF, 0xF0, 0x1F, 0xFF, 0xFC, 0x0F, 0xFF, 0xFF,
  0x03, 0xFF, 0xFF, 0xE0, 0xFF, 0xFF, 0xF8, 0x3F, 0xFF, 0xFF, 0x0F, 0xFF,
  0xFF, 0xC3, 0xFF, 0xFF, 0xF0, 0xFF, 0xFF, 0xFC, 0x3F, 0xFF, 0xFF, 0x0F,
  0xFF, 0xFF, 0xC3, 0xFF, 0xFF, 0xF0, 0xFF, 0xFF, 0xFC, 0x3F, 0xFF, 0xFF,
  0x0F, 0xFF, 0xFF, 0xC3, 0xFF, 0xFF, 0xF8, 0xFF, 0xFF, 0xFE, 0x3F, 0xFF,
  0xFF, 0x8F, 0xFF, 0xFF, 0xE3, 0xFF, 0xFF, 0xF8, 0xFF, 0xFF, 0xFE, 0x3F,
  0xFF, 0xFF, 0x8F, 0xFF, 0xFF, 0xE3, 0xFF, 0xFF, 0xF8, 0xFF, 0xFF, 0xFE,
  0x3F, 0xFF, 0xFF, 0x8F, 0xFF, 0xFF, 0xE3, 0xFF, 0xFF, 0xF8, 0xFF, 0xFF,
  0xFE, 0x3F, 0xFF, 0xFF, 0x8F, 0xFF, 0xFF, 0xE3, 0xFF, 0xFF, 0xFC, 0xFF,
  0xFF, 0xFF, 0x3F, 0xFF, 0xFF, 0xCF, 0xFF, 0xFF, 0xF3, 0xFF, 0xFF, 0xFC,
  0xFF, 0xFF, 0xFF, 0x3F, 0xFF, 0xFF, 0xCF, 0xFF, 0xFF, 0xF3, 0xFF, 0xFF,
  0xFC, 0xFF, 0xFF, 0xFF, 0x3F, 0xFF, 0xFF, 0xCF, 0xFF, 0xFF, 0xF3, 0xFF,
  0xFF, 0xFC, 0xFF, 0xFF, 0xFF, 0x3F, 0xFF, 0xFF, 0xCF, 0xFF, 0xFF, 0xF1,
  0xFF, 0xFF, 0xFC, 0x7F, 0xFF, 0xFF, 0x1F, 0xFF, 0xFF, 0xC7, 0xFF, 0xFF,
  0xF1, 0xFF, 0xFF, 0xFE, 0x7F, 0xFF, 0xFF, 0x9F, 0xFF, 0xFF, 0xE7, 0xFF,
  0xFF, 0xF9, 0xFF, 0xFF, 0xFE, 0x7F, 0xFF, 0xFF, 0x9F, 0xFF, 0xFF, 0xE7,
  0xFF, 0xFF, 0xF9, 0xFF, 0xFF, 0xFE, 0x7F, 0xFF, 0xFF, 0x9F, 0xFF, 0xFF,
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
  { 27622,  71, 101,  75,    1,  -98 },   // 0x46 'F'
  { 28519,  80, 101,  89,   -3,  -97 },   // 0x47 'G'
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

const GFXfont Rayman_Origins72pt7b PROGMEM = {
  (uint8_t  *)Rayman_Origins72pt7bBitmaps,
  (GFXglyph *)Rayman_Origins72pt7bGlyphs,
  0x20, 0x7E, 162 };

// Approx. 72781 bytes
