pioter1234567/airhockey/(commit log)

2026-03-13 Initial backup
    [nowe_ust-B_Adhesive.gbr, nowe_ust-B_Courtyard.gbr, nowe_ust-B_Cu.gbr, nowe_ust-B_Fab.gbr, nowe_ust-B_Mask.gbr, nowe_ust-B_Paste.gbr, nowe_ust-B_Silkscreen.gbr, nowe_ust-Edge_Cuts.gbr]
2026-03-13 Ignore KiCad backups and autosaves
2026-03-13 Assets added - SD cards for devices
    [coinlog.csv, settings.cfg]
2026-03-16 Auto goal calibration added
2026-03-17 fix: correct theme mapping in music and full rounds
    [main.cpp]
2026-03-19 lcd-unit games backgrounds complete; transition fixed between screens
    [main.cpp]
2026-03-21 goal animation logic for both sides; 3d models added
    [lcd-cover-screen-lasercut.FCStd, lcd-housing.FCStd, lcd-housing.stl, speaker_box.FCStd]
2026-03-21 points display fix; end match points added
    [main.cpp, unit_config.h]
2026-03-23 blinking score added; duplicated game over fixed
    [main.cpp]
2026-03-28 lamp animation fix
    [lamp-driver-B_Cu.gbr, lamp-driver-B_Mask.gbr, lamp-driver-B_Paste.gbr, lamp-driver-B_Silkscreen.gbr, lamp-driver-Edge_Cuts.gbr, lamp-driver-F_Cu.gbr, lamp-driver-F_Mask.gbr, lamp-driver-F_Paste.gbr]
2026-03-29 postGame bug fixed, missing anims added, converter fseq fixed
    [main.cpp]
2026-04-10 lamp fans control added; uv boost anims added; ambiente light timeout fixed
    [can.kicad_pcb, can.kicad_sch, lamp-driver-housing.FCStd, lamp-driver-housing.stl, lamp-driver.kicad_pcb, lamp-driver.kicad_sch, lamp-driver.step, lcd_con.kicad_sch]
2026-04-11 fail safe added to lamp fans
    [lamp-driver.kicad_sch, rayman_main.kicad_pcb, rayman_main.kicad_sch]
2026-04-11 UV control fixed
    [lamp-driver.kicad_sch]
2026-06-02 Ambiente lighting draft, song order fixet for music rounds, many others
    [lcd_con.kicad_sch, preamp.kicad_sch, rayman_LCD_STM.kicad_pcb, rayman_LCD_STM.kicad_sch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]
2026-06-09 RTC corrected
    [5v_tray.stl, BT_tray.stl, main unit tray.FCStd, main unit tray.stl, nowe_ust.step, rayman_main.step, settings tray.FCStd, settings tray.stl]
2026-06-12 Goal animations added, fixed BIN animation glitch after goal
    [main.cpp, table_lights.cpp]
2026-06-22 Goal lightning
    [door_strip_latch.stl, door_strip_latch2.stl, door_stripe_latch.FCStd, door_stripe_latch2.FCStd, kulka.stl]
2026-06-22 lcd ANIMs fixed - previous game ghost
    [anims.cpp, main.cpp, unit_config.h]
2026-06-22 sound effects between rounds and at the end, fixed goal sides
    [main.cpp]
2026-07-15 fixed goal count, end music effect volume down, few minor fixes
    [main.cpp]
